venam123/Open_STMPLC/Document/ATM90E3x_V1.05/Hardware/ATM90E3x-DB V1.0/readme.txt

The project is designed with Altium Designer (Platform 27009).
