venam123/Open_STMPLC/Document/PCB_Design_Review_Report.docx

PCB Schematic Design Review Report

Universal PLC I/O Card + PLC Controller Card

Thingslista Automation LLp — Internal Design Review

Schematic Date: 19 Feb 2026 | Review Date: 20 Mar 2026

12 Critical Issues | 5 Warnings | 17 Total Issues

# Issue Summary

ID | Severity | Issue Title | Section
DI-01 | Critical | H11AA1 — Inverted Logic, NC pe LOW output aana | I/O Card — Digital Input
DO-01 | Critical | TVS Diode SMBJ33A Galat — 33V clamp > AO3400A 30V Vds max | I/O Card — Digital Output
DO-02 | Warning | 1N5819HW aur SMBJ33A Dono Parallel — Unnecessary Duplication | I/O Card — Digital Output
DO-03 | Critical | J20 Connector — Koi Signal Connected Nahi | I/O Card — Digital Output
SPI-01 | Critical | Energy Meter SPI — Chip Select CS Pin Allocate Hi Nahi Kiya | I/O Card — SPI / Energy Meter
SPI-02 | Critical | A_OUT_MOSI Net — Ambiguous Name, SPI Bus Conflict Risk | I/O Card — SPI / Energy Meter
AI-01 | Critical | INA828 — SGND Net Ambiguous, Ground Reference Unclear | I/O Card — Analog Input
AO-01 | Critical | J31/J32 — Voltage aur Current Output Same Connector — Wiring Hazard | I/O Card — Analog Output
AO-02 | Critical | R181-R187 — Component Values Missing in Schematic aur BOM | I/O Card — Analog Output
TEMP-01 | Critical | MAX6603ATB (I/O Card) + MAX31865 (Controller) — Duplicate RTD Architecture | I/O Card — Temperature / RTD
PWR-01 | Critical | TPS563200 U11 VFB Resistors R38/R39 Ulte — Output 1V aa raha, 3.3V nahi | Controller Card — Power Supply
PWR-02 | Critical | EC200U VBAT_RF — Bulk Cap Insufficient, GSM Burst mein Reboot | Controller Card — Power Supply
PWR-03 | Warning | Ferrite Bead FB1 BLM21AG121SN1D — 200mA only, VCC to AVDD33 Insufficient | Controller Card — Power Supply
MCU-01 | Critical | STM32F407 BOOT0 Pin 94 — Pull-Down Resistor Missing | Controller Card — MCU
MCU-02 | Warning | USB Connector J7 — VBUS Overvoltage Protection Missing | Controller Card — MCU
GEN-01 | Warning | Title Block — Sheet Numbers aur Revision Missing | General
GEN-02 | Warning | +5V / -5V Rail — I/O Card par Source Clearly Documented Nahi | General

# I/O Card — Digital Input

## DI-01 — H11AA1 — Inverted Logic, NC pe LOW output aana

Field | Details
Critical | Logic Error
Schematic Reference | Sheet 1-3, U6-U23 H11AA1-X007T, R20-R22, DIGITAL_INPUT1-18
Problem Description | • H11AA1 collector output topology se ACTIVE LOW deta hai — inherently inverting. • Input HIGH pe transistor ON, output LOW. NC/open pe transistor OFF, output HIGH (pull-up se). • Bug: NC pe LOW observe ho raha hai — MCU GPIO ka internal pull-down active ho sakta hai. • Expected: NC=HIGH, HIGH input=HIGH, LOW input=LOW. Actual sab ulta hai.
Recommended Fix | ✓ FIX A (Immediate, no hardware): MCU GPIO_PuPd_UP enable karo. actual = !GPIO_ReadInput(pin). Zero hardware change. ✓ FIX B (Next revision): 74HC14 schmitt trigger inverter add karo — proper hysteresis aur non-inverting output.

# I/O Card — Digital Output

## DO-01 — TVS Diode SMBJ33A Galat — 33V clamp > AO3400A 30V Vds max

Field | Details
Critical | Wrong Protection Component
Schematic Reference | Sheet 4-5, D11-D20 D23-D32 SMBJ33A, Q1-Q12 AO3400A
Problem Description | • AO3400A MOSFET max Vds = 30V. SMBJ33A clamp = 33V — 3V upar MOSFET rating se. • Inductive switching mein MOSFET 33V se pehle damage ho sakta hai. • 24V system ke liye TVS clamp ~26-28V hona chahiye (supply ka 120%).
Recommended Fix | ✓ SMBJ33A ko SMBJ26A ya SMBJ28A se replace karo. ✓ Alternative: AO3400A ki jagah 40V+ rated MOSFET use karo.

## DO-02 — 1N5819HW aur SMBJ33A Dono Parallel — Unnecessary Duplication

Field | Details
Warning | Redundant Components
Schematic Reference | Sheet 4-5, D9/D11 D10/D12 pairs har channel mein
Problem Description | • Har output channel mein Schottky flyback diode aur TVS dono hain. • Inductive load ke liye ek protection sufficient hai.
Recommended Fix | ✓ Ya sirf corrected TVS (SMBJ26A) rakho, ya sirf 1N5819HW. Dono ki zarurat nahi.

## DO-03 — J20 Connector — Koi Signal Connected Nahi

Field | Details
Critical | Floating Connector
Schematic Reference | Sheet 4, J20 1729128 2-pin, sirf +24VDC aur GND
Problem Description | • J20 par sirf power lines hain, koi DIGITAL_OUTPUT signal nahi. • Purpose unclear — power input ya output connector?
Recommended Fix | ✓ Power connector hai to clearly label karo "+24VDC Power Input". ✓ Output connector tha to missing signal connect karo ya connector hatao.

# I/O Card — SPI / Energy Meter

## SPI-01 — Energy Meter SPI — Chip Select CS Pin Allocate Hi Nahi Kiya

Field | Details
Critical | SPI Bus — Missing CS Pin
Schematic Reference | Controller Card Sheet 5, STM32F407VGT6, SPI GPIO allocation
Problem Description | • Energy meter ke liye dedicated CS pin MCU mein assign nahi kiya gaya. • Existing CS pins: E_CS, F_CS, TEMP0_CS, TEMP1_CS, A_IOUT_CS, A_VOUT_CS, CS_SD — sab occupied. • Bina CS ke energy meter SPI pe kabhi respond nahi karega.
Recommended Fix | ✓ STM32F407 available GPIO (PC/PD/PE) mein se ek pin EMETER_CS assign karo. ✓ Schematic mein net add karo aur MCU se energy meter CS pin tak connect karo. ✓ Agar GPIO nahi: 74HC138 decoder se 3 GPIO mein 8 CS lines generate karo.

## SPI-02 — A_OUT_MOSI Net — Ambiguous Name, SPI Bus Conflict Risk

Field | Details
Critical | SPI Net Naming Error
Schematic Reference | Sheet 7 U41 MCP4922 current DAC, Sheet 8 U44 MCP4922 voltage DAC
Problem Description | • A_VOUT_MOSI aur A_IOUT_MOSI dono ek hi A_OUT_MOSI net share karte hain. • Agar firmware dono CS ek saath assert kare to SPI bus fight aur dono DAC galat data receive karenge.
Recommended Fix | ✓ Nets clearly alag karo: A_IOUT_MOSI aur A_VOUT_MOSI. ✓ Firmware mein ek CS high kiye bina doosra CS low nahi karna.

# I/O Card — Analog Input

## AI-01 — INA828 — SGND Net Ambiguous, Ground Reference Unclear

Field | Details
Critical | Analog Ground Reference Error
Schematic Reference | Sheet 6, U36-U39 INA828ID, Pin 5 REF, SGND net
Problem Description | • INA828 REF pin VREF net se connected lekin SGND source schematic mein visible nahi. • SGND aur GND properly tied nahi hain to differential measurements mein systematic offset aayega.
Recommended Fix | ✓ SGND ko AGND se single point par explicitly connect karo. ✓ Agar offset nahi chahiye to REF pin seedha GND se connect karo.

# I/O Card — Analog Output

## AO-01 — J31/J32 — Voltage aur Current Output Same Connector — Wiring Hazard

Field | Details
Critical | Connector Design Error
Schematic Reference | Sheet 8, J31 J32 1727023 3-pin, Analog_Voutput + Analog_Ioutput same
Problem Description | • 0-10V voltage output aur 4-20mA current output ek hi Phoenix 3-pin connector par. • Field wiring mein dono mix ho sakte hain — connected equipment damage.
Recommended Fix | ✓ Voltage aur current output ke liye alag dedicated connectors use karo. ✓ Labels clearly likho: AO-V1 (0-10V) aur AO-I1 (4-20mA).

## AO-02 — R181-R187 — Component Values Missing in Schematic aur BOM

Field | Details
Critical | Incomplete Schematic
Schematic Reference | Sheet 8, R181 R182 R183 R184 R185 R186 R187, BOM Sheet 11
Problem Description | • R181-R187 mein koi resistance value ya part number nahi — ye DAC output voltage divider resistors hain. • Values se output voltage range set hoti hai — manufacturing ke liye incomplete.
Recommended Fix | ✓ Required output range (0-10V) ke liye OPA2197 gain stage se R values calculate karo. ✓ BOM mein in components ki values aur part numbers add karo.

# I/O Card — Temperature / RTD

## TEMP-01 — MAX6603ATB (I/O Card) + MAX31865 (Controller) — Duplicate RTD Architecture

Field | Details
Critical | Conflicting Architecture
Schematic Reference | I/O Card Sheet 9 U47 MAX6603ATB, Controller Sheet 9 U12 U13 MAX31865
Problem Description | • I/O card par MAX6603ATB (analog voltage RTD output). Controller card par MAX31865 SPI IC bhi. • Ek design mein dono approaches — redundant, confusing, extra cost. • MAX31865 direct SPI se accurate digital reading deta hai — better option.
Recommended Fix | ✓ MAX31865 use karo. I/O card par U47 MAX6603ATB ko DNP mark karo aur remove karo.

# Controller Card — Power Supply

## PWR-01 — TPS563200 U11 VFB Resistors R38/R39 Ulte — Output 1V aa raha, 3.3V nahi

Field | Details
Critical | Wrong Output Voltage — Critical Bug
Schematic Reference | Power Sheet 7, U11 TPS563200DDCR, R38 10k top R39 33.2k bot, VCC AVDD33
Problem Description | • TPS563200 reference = 0.768V. Vout = 0.768 x (1 + R_top/R_bot). • Current: R38=10k top, R39=33.2k bot -> Vout = 0.768 x 1.301 = 1.0V. GALAT. • Sahi: R_top=33.2k, R_bot=10k -> 0.768 x 4.32 = 3.317V. Resistors ulte hain. • STM32F407 aur sabhi 3.3V peripherals under-voltage mein — system properly kaam nahi karega.
Recommended Fix | ✓ Immediate rework: R38 position mein 33.2k lagao (top). R39 mein 10k (bottom). Swap karo. ✓ Fix ke baad VCC multimeter se measure karo — 3.3V plus/minus 2% aana chahiye. ✓ Next revision: schematic annotate karo R_top=33.2k R_bot=10k Vout=3.317V.

## PWR-02 — EC200U VBAT_RF — Bulk Cap Insufficient, GSM Burst mein Reboot

Field | Details
Critical | GSM Module Power Instability
Schematic Reference | Sheet 2 U1 EC200U pins 57-60, Power Sheet 7 C52 C53 100uF, MIC29302, F2
Problem Description | • EC200U GSM burst mein 2A peak current draw karta hai. • C52/C53 100uF EC200U se physically door — trace inductance VBAT drop badhata hai. • VBAT_RF 200-300mV dip kar sakta hai. EC200U minimum 3.4V chahiye — 800mV+ drop se reset. • MIC29302 LDO slow transient response se burst current handle nahi hota.
Recommended Fix | ✓ Immediate: EC200U VBAT_RF pins ke bilkul paas 470uF low-ESR cap add karo rework mein. ✓ Oscilloscope se verify: VBAT_RF GSM call mein 3.4V se neeche nahi aana chahiye. ✓ Next revision: VBAT_RF trace 1.5mm min. MIC29302 -> Ferrite bead -> 470uF -> VBAT_RF. ✓ F2 fuse 3A use karo — GSM burst ke liye 1.5A fuse blow ho sakta hai.

## PWR-03 — Ferrite Bead FB1 BLM21AG121SN1D — 200mA only, VCC to AVDD33 Insufficient

Field | Details
Warning | Analog Supply Filtering
Schematic Reference | Power Sheet 7, FB1 BLM21AG121SN1D, VCC to AVDD33, STM32 VDDA VSSA
Problem Description | • BLM21AG121SN1D max DC current = 200mA — saturation pe AVDD33 drop karega. • STM32 ADC measurements inaccurate honge AVDD33 drop se.
Recommended Fix | ✓ FB1 ko BLM21PG600SN1D 600mA se replace karo. ✓ Better: AVDD33 ke liye dedicated LDO LP2985 150mA 3.3V use karo — better analog isolation.

# Controller Card — MCU

## MCU-01 — STM32F407 BOOT0 Pin 94 — Pull-Down Resistor Missing

Field | Details
Critical | MCU Boot Configuration
Schematic Reference | Sheet 5, U2A STM32F407VGT6, Pin 94 BOOT0
Problem Description | • BOOT0 float kare to MCU bootloader mode mein start hoga — user firmware run nahi hoga. • Schematic mein BOOT0 pull-down visible nahi.
Recommended Fix | ✓ BOOT0 pin 94 se GND ke beech 10k resistor add karo. ✓ ISP ke liye test pad ya switch ke through control karo.

## MCU-02 — USB Connector J7 — VBUS Overvoltage Protection Missing

Field | Details
Warning | USB Protection
Schematic Reference | Sheet 5, J7 104110-0001LF micro USB, VBUS pin 1
Problem Description | • J7 VBUS seedha +5V se connected hai bina protection ke.
Recommended Fix | ✓ VBUS par Schottky diode ya USBLC6-2SC6 dedicated USB protection IC add karo.

# General

## GEN-01 — Title Block — Sheet Numbers aur Revision Missing

Field | Details
Warning | Documentation
Schematic Reference | All sheets — bottom right title block
Problem Description | • Multiple sheets par Sheet of blank, revision number missing.
Recommended Fix | ✓ Har sheet number fill karo e.g. Sheet 1 of 9. Revision Rev A add karo.

## GEN-02 — +5V / -5V Rail — I/O Card par Source Clearly Documented Nahi

Field | Details
Warning | Power Distribution Documentation
Schematic Reference | I/O Card Sheet 9, P5 Header 10X2 pins 11-12
Problem Description | • INA828, OPA2197, MCP4922 ko +5V aur -5V chahiye lekin I/O card par source unclear.
Recommended Fix | ✓ P5 connector assignment mein +5V/-5V source document karo. Power budget table add karo.

Confidential — Internal Design Review Thingslista Automation LLp

PCB Design Review — Thingslista Automation LLp March 2026
