venam123/Open_STMPLC/Document/ATM90E3x_V1.05/Hardware/ATSAM4C-CB V1.0/ATSAM4C-CB.PcbDoc.htm

Reporting Options

# File in Newer Format

Date | : | 10-06-2026
Time | : | 22:07:52
Filename | : | D:\Github\Open_STMPLC\Document\ATM90E3x_V1.05\Hardware\ATSAM4C-CB V1.0\ATSAM4C-CB.PcbDoc

Version | Warning
Release 13 | CAUTION - Silkscreen Over Component Pads Rules are converted to Silk To Solder Mask Clearance Rules. Suggest examining rule scopes for accuracy.

This file was generated by an earlier version of the software
