venam123/Open_STMPLC/Document/SMPS Design/Quatation/SMPS Price.xlsx

Sr No | Per PCB | Pcs
1 | 260 | 1200
Note
1 | Transfomer Control & Design
2 | Industry Design Components
3 | Total Indian Component not depend on China
4 | Shippng Charge Extra
