venam123/Open_STMPLC/Document/DXF Files/image (1).png

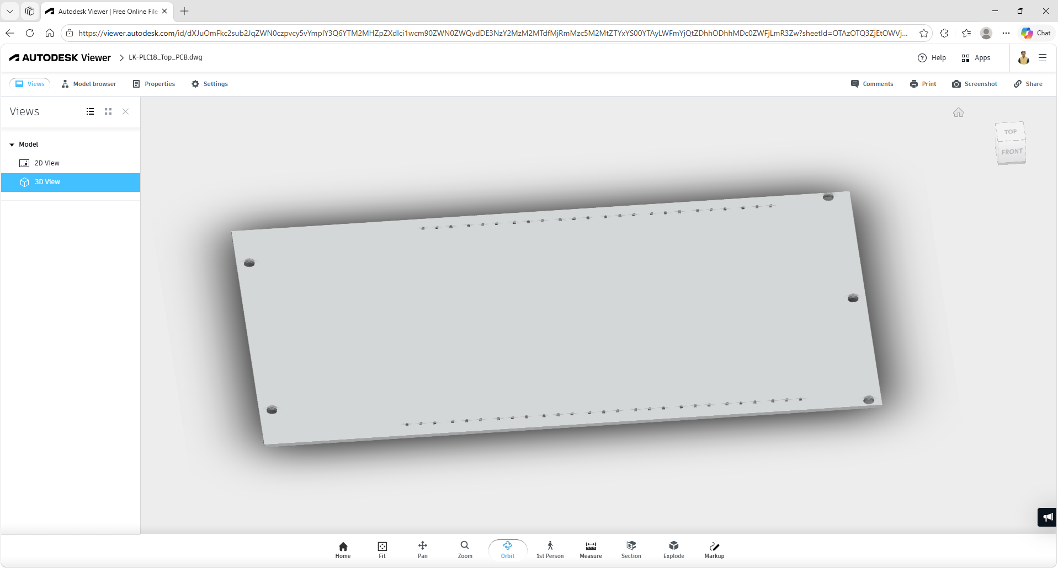
Document/DXF Files/image (1).png
