venam123/Open_STMPLC/Document/DXF Files/image (2).png

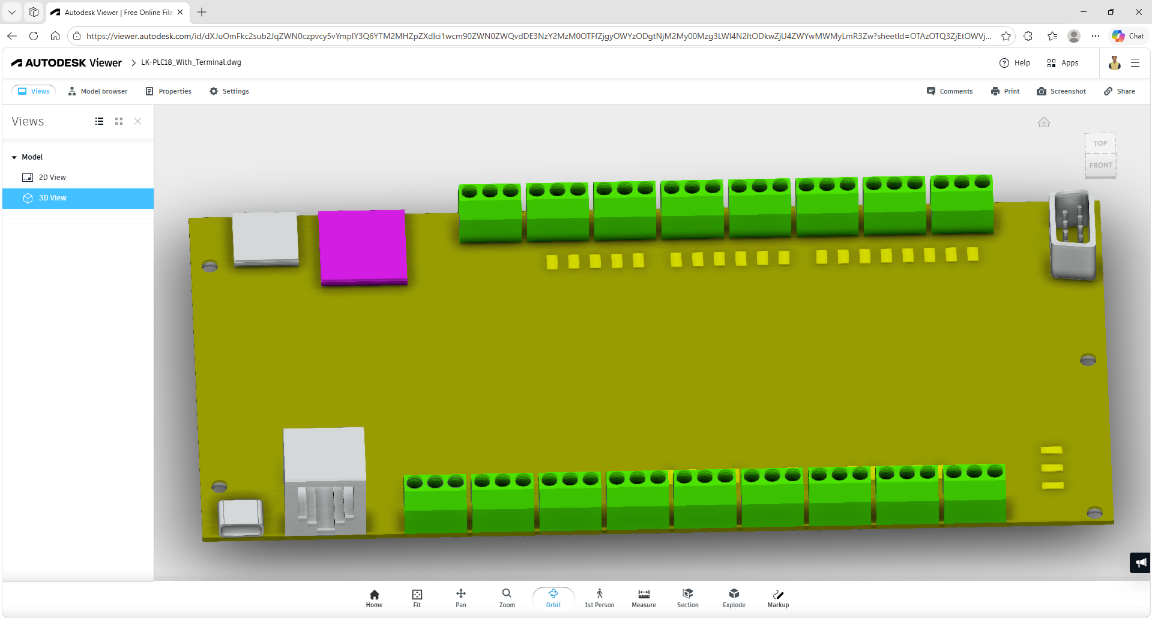
Document/DXF Files/image (2).png
