venam123/Open_STMPLC/Document/DXF Files/image.png

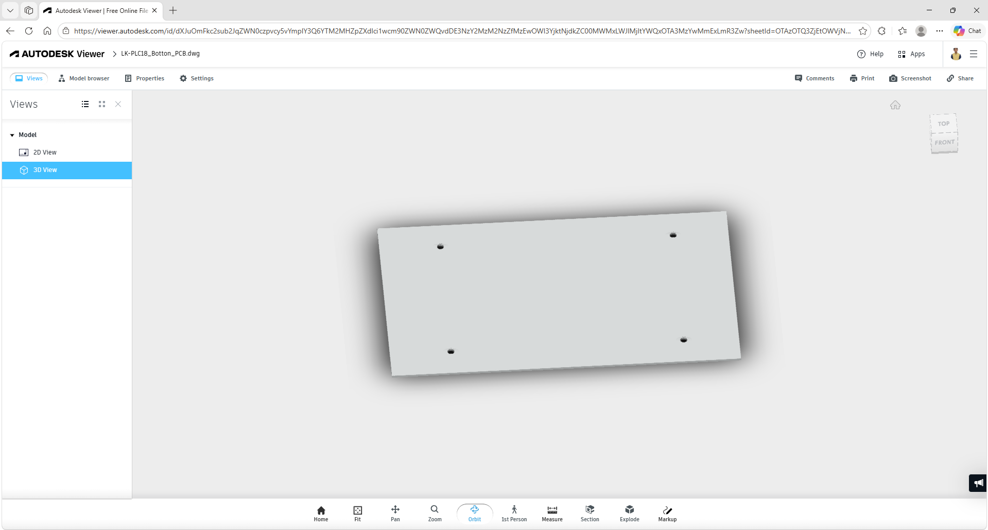
Document/DXF Files/image.png
