venam123/Open_STMPLC/Document/Watch-Dog Ref Image/Watch_Dog_Ref_Image.PNG

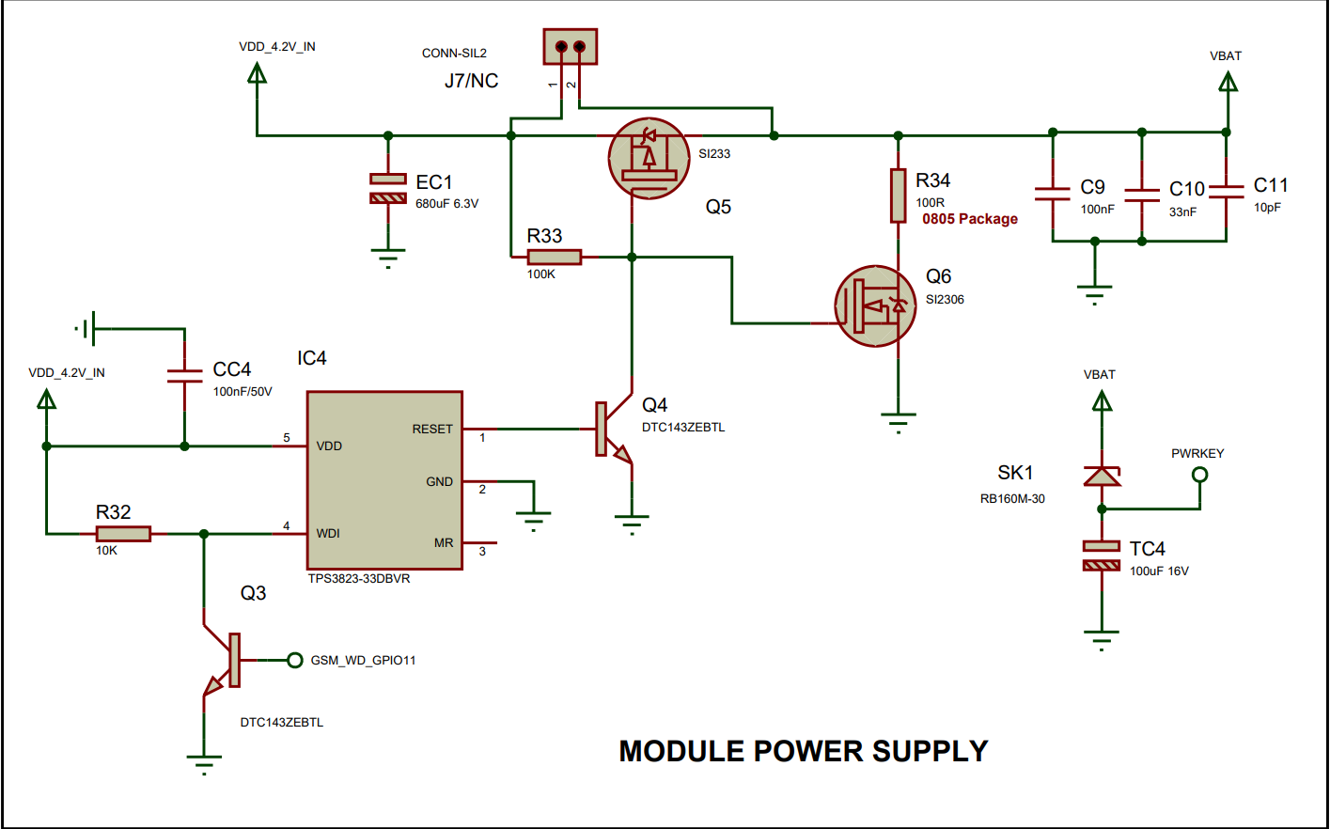
Document/Watch-Dog Ref Image/Watch_Dog_Ref_Image.PNG
