venam123/Open_STMPLC/Hardware/Running_Hardware/Open_STMPLC_IO_V0.1/bom/IO_PCB.xlsx

Sr No | References | Value | Footprint | kicad_dnp | Quantity | JLC PCB Part_Number
1 | C1, C3, C4, C5, C7, C12, C13, C15, C26, C30, C34, C35, C36, C37, C38, C39, C40, C41, C42, C43, C44, C45, C48, C54, C57, C59, C63, C66, C67, C68, C81, C86, C87, C88, C90 | 100nF | C_0603_1608Metric_Pad1.08x0.95mm_HandSolder |  | 35 | C5137636
2 | C8, C23, C27, C31, C47, C50, C51, C52, C58, C64, C65, C82 | 1uF | C_0603_1608Metric_Pad1.08x0.95mm_HandSolder |  | 12 | C559769
3 | C10, C16, C17, C18, C19, C20, C21, C22 | 620nF | C_0603_1608Metric_Pad1.08x0.95mm_HandSolder |  | 8 | C7496642
4 | C2, C25, C29, C33, C46 | 10uF | C_0805_2012Metric_Pad1.18x1.45mm_HandSolder |  | 5 | C440198
5 | C6, C11, C55, C62 | 10nF | C_0603_1608Metric_Pad1.08x0.95mm_HandSolder |  | 4 | C5137477
6 | C9, C24, C28, C32 | 2.2uF | C_0603_1608Metric_Pad1.08x0.95mm_HandSolder |  | 4 | C913904
7 | C69, C74, C79, C80 | 4.7nF | C_0603_1608Metric_Pad1.08x0.95mm_HandSolder |  | 4 | C106218
8 | C70, C73, C77, C78 | 680pF | C_0603_1608Metric_Pad1.08x0.95mm_HandSolder |  | 4 | C107055
9 | C71, C72, C75, C76 | 470pF | C_0603_1608Metric_Pad1.08x0.95mm_HandSolder |  | 4 | C107092
10 | C14, C85 | 10nF | C_0603_1608Metric_Pad1.08x0.95mm_HandSolder | DNP | 2 | C5137477
11 | C53, C60 | 47nF | C_0603_1608Metric_Pad1.08x0.95mm_HandSolder |  | 2 | C107093
12 | C56, C61 | 100nF | C_0603_1608Metric_Pad1.08x0.95mm_HandSolder | DNP | 2 | C5137636
13 | C83, C84 | 10pF | C_0603_1608Metric_Pad1.08x0.95mm_HandSolder |  | 2 | C106245
14 | C89 | 220uF/50V | CP_Elec_10x10.5 |  | 1 | C88818
15 | R1, R2, R17, R19, R20, R33, R35, R36, R40, R42, R43, R47, R49, R50, R54, R56, R57, R61, R63, R64, R68, R70, R71, R75, R77, R78, R89, R90, R100, R101, R111, R112, R207, R208, R215, R216, R217, R218, R219, R220, R221, R222, R223, R224, R225, R226 | 4.7K | R_0603_1608Metric_Pad0.98x0.95mm_HandSolder |  | 46 | C105428
16 | R4, R10, R37, R44, R51, R58, R65, R72, R79, R84, R95, R106, R114, R115, R120, R121, R126, R127, R132, R133, R138, R139, R144, R145, R168, R172, R176, R177, R180, R181, R193, R197, R202, R203, R227, R228, R229, R230, R231, R232, R233, R234, R235, R236, R237, R238 | 1K | R_0603_1608Metric_Pad0.98x0.95mm_HandSolder |  | 46 | C14676
17 | R3, R14, R16, R34, R41, R48, R55, R62, R69, R76, R83, R88, R94, R99, R105, R110, R159, R160, R164, R165, R166, R167, R183, R187, R188, R189 | 10K | R_0603_1608Metric_Pad0.98x0.95mm_HandSolder |  | 26 | C99198
18 | R22, R25, R116, R117, R122, R123, R128, R129, R134, R135, R140, R141, R146, R147, R148, R149, R150, R151, R152, R153, R154, R155, R156, R157 | 10R/1W | R_2512_6332Metric_Pad1.40x3.35mm_HandSolder |  | 24 | C16861
19 | R21, R23, R24, R27, R113, R118, R119, R124, R125, R130, R131, R136, R137, R142, R143, R169, R170, R185, R186, R206 | 2.2K | R_0603_1608Metric_Pad0.98x0.95mm_HandSolder |  | 20 | C113303
20 | R11, R87, R98, R109, R163, R239, R240, R241, R242, R243 | 470R | R_0603_1608Metric_Pad0.98x0.95mm_HandSolder |  | 10 | C23179
21 | R15, R38, R45, R52, R59, R66, R73, R80 | 100K | R_0603_1608Metric_Pad0.98x0.95mm_HandSolder | DNP | 8 | C14675
22 | R18, R39, R46, R53, R60, R67, R74, R81 | 15K | R_0603_1608Metric_Pad0.98x0.95mm_HandSolder |  | 8 | C114661
23 | R192, R194, R195, R196, R198, R199, R200, R201 | 180R | R_0603_1608Metric_Pad0.98x0.95mm_HandSolder |  | 8 | C137786
24 | R29, R30, R31, R210, R211, R212 | 0R | R_0603_1608Metric_Pad0.98x0.95mm_HandSolder | DNP | 6 | C95177
25 | R32, R171, R182, R190, R191, R209 | 0R | R_0603_1608Metric_Pad0.98x0.95mm_HandSolder |  | 6 | C95177
26 | R158, R161, R162, R204, R205, R245 | 100K | R_0603_1608Metric_Pad0.98x0.95mm_HandSolder |  | 6 | C14675
27 | R5, R12, R91, R102 | 715K | R_0603_1608Metric_Pad0.98x0.95mm_HandSolder |  | 4 | C19267401
28 | R6, R13, R92, R103 | 20K | R_0603_1608Metric_Pad0.98x0.95mm_HandSolder |  | 4 | C2907011
29 | R7, R82, R93, R104 | 30.1K | R_0603_1608Metric_Pad0.98x0.95mm_HandSolder |  | 4 | C137745
30 | R8, R85, R96, R107 | 11.8K | R_0603_1608Metric_Pad0.98x0.95mm_HandSolder |  | 4 | C185375
31 | R9, R86, R97, R108 | 33.2K | R_0603_1608Metric_Pad0.98x0.95mm_HandSolder |  | 4 | C2933200
32 | R26, R213 | 400R | R_0603_1608Metric_Pad0.98x0.95mm_HandSolder |  | 2 | C5841024
33 | R28, R214 | 4K | R_0603_1608Metric_Pad0.98x0.95mm_HandSolder | DNP | 2 | C242164
34 | R173, R184 | 15R | R_0603_1608Metric_Pad0.98x0.95mm_HandSolder |  | 2 | C128059
35 | R174, R179 | 1.65K | R_0603_1608Metric_Pad0.98x0.95mm_HandSolder |  | 2 | C2930051
36 | R175, R178 | 1.65K | R_0603_1608Metric_Pad0.98x0.95mm_HandSolder | DNP | 2 | C2930051
37 | D1, D2, D6, D7, D12, D13, D15, D16, D17, D19, D20, D21, D23, D24, D25, D27, D28, D29, D31, D32, D33, D34, D36, D37, D39, D41, D42, D44, D46, D47, D49, D50, D51, D53, D54, D55, D108, D109, D110, D111, D113, D115, D116, D117 | SS510 | D_SMA |  | 44 | C65010
38 | D100, D101, D102, D103, D104, D105, D126, D127, D128, D129, D130, D131, D132, D133, D134, D135, D136, D137, D138, D139, D140, D141, D142, D143, D144, D145, D146, D147, D148, D149, | LED(G) | LED_0603_1608Metric_Pad1.05x0.95mm_HandSolder |  | 30 | C965799
39 | D150, D151, D152 | LED® | LED_0603_1608Metric_Pad1.05x0.95mm_HandSolder |  | 3 | C125094
40 | D3, D5, D8, D9, D10, D14, D18, D22, D26, D30, D38, D43, D48, D52, D56, D60, D61, D66, D67, D72, D73, D78, D79, D84, D85, D112, D114, D118, D121, D124, D125, D160 | SMAJ33CA | D_SMA |  | 32 | C908829
41 | D11, D57, D62, D63, D68, D69, D74, D75, D80, D81, D86, D87 | MB110S | TO-269AA |  | 12 | C94545
42 | D58, D59, D64, D65, D70, D71, D76, D77, D82, D83, D88, D89 | NSI50010YT1G | D_SOD-123 |  | 12 | C150049
43 | D92, D93, D94, D95, D96, D97, D98, D99 | SMF5V0A | D_SMF |  | 8 | C1972946
44 | D4, D35, D40, D45 | BZT52C12 | D_SOD-123 |  | 4 | C173429
45 | D119, D120, D122, D123 | SMAJ10CA | D_SMA |  | 4 | C908816
46 | D90, D159 | BZV55C10 | D_MiniMELF |  | 2 | C2892588
47 | D91 | MMSZ5256ET1G | D_MiniMELF |  | 1
48 | U12, U20, U21, U22, U23, U24, U25, U26, U27, U28, U29, U30 | 6N137 | SMDIP-8_W9.53mm_Clearance8mm |  | 12 | C110020
49 | U1, U2, U3, U4, U5, U6, U9, U13 | TPS1H200A | HVSSOP-8-1EP_3x3mm_P0.65mm_EP1.57x1.89mm_ThermalVias |  | 8 | C2653785
50 | U7, U14, U16, U18 | TPS26600PWP | HTSSOP-16-1EP_4.4x5mm_P0.65mm_EP3.4x5mm_Mask2.66x2.46mm_ThermalVias |  | 4 | C544399
51 | U8, U15, U17, U19 | NVTFS5124PLTAG | WDFN-8_3.3X3.3_P0.65mm |  | 4 | C606162
52 | U10, U41 | MAX31865xTP | TQFN-20-1EP_5x5mm_P0.65mm_EP3.25x3.25mm |  | 2 | C779509
53 | U37, U38 | XTR305 | Texas_RGW0020A_VQFN-20-1EP_5x5mm_P0.65mm_EP3.15x3.15mm |  | 2 | C266132
54 | U11 | MAX31856 | TSSOP-14_4.4x5mm_P0.65mm |  | 1 | C2653162
55 | U39 | AD4111 | LFCSP-40-1EP_6x6mm_P0.5mm_EP4.6x4.6mm |  | 1 | C649166
56 | U40 | REF3025 | SOT-23 |  | 1 | C11334
57 | Y2 | 16MHz | Crystal_SMD_5032-4Pin_5.0x3.2mm |  | 1 | C18214305
58 | F1, F2, F3, F4 | MF-USMF005-2 | Fuse_1210_3225Metric |  | 4 | C118758
59 | F5 | 0685T5000-01 | Fuse_1206_3216Metric |  | 1 | C3163312
60 | Q1, Q2, Q3, Q4 | 2N7002K | SOT-23 |  | 4 | C414015
61 | FB1, FB2, FB3 | 120R@100MHz | L_0805_2012Metric_Pad1.05x1.20mm_HandSolder |  | 3 | C79382
62 | Q5, Q6 | AOD407 | TO-252-3_TabPin2 |  | 2 | C6396162
63 | FB4 | BLM31SN500SH1L | L_1206_3216Metric_Pad1.22x1.90mm_HandSolder |  | 1 | C527600
64 | Q7 | MMBT5401 | SOT-23 |  | 1 | C21488
65 | J3, J5, J6, J7, J8, J40 | Screw_Terminal_01x04 | TerminalBlock_Phoenix_MKDS-1-4-3.81_1x04_P3.81mm_Horizontal |  | 6 | C395880
66 | J4, J33, J34, J43 | Screw_Terminal_01x02 | TerminalBlock_Phoenix_MKDS-1-2-3.81_1x02_P3.81mm_Horizontal |  | 4 | C395878
67 | J35, J36, J37, J38 | Screw_Terminal_01x03 | TerminalBlock_Phoenix_MKDS-1-3-3.81_1x03_P3.81mm_Horizontal |  | 4 | C395879
68 | J39, J41, J42 | 10144517-041802LF | AMPHENOL_10144517-041802LF |  | 3 | C3645392
69 | J1 | Screw_Terminal_01x10 | TerminalBlock_Phoenix_MKDS-1-10-3.81_1x10_P3.81mm_Horizontal |  | 1 | C5137189
70 | J2 | Screw_Terminal_01x06 | TerminalBlock_Phoenix_MKDS-1-6-3.81_1x06_P3.81mm_Horizontal |  | 1 | C5143696
71 | J9 | DE9_Pins | A-DF_09_PP_Z |  | 1 | C183530
