venam123/Open_STMPLC/Hardware/Running_Hardware/Open_STMPLC_Main_V0.1/bom/Main_PCB_BOM.xlsx

null | Sourced | Placed | References | Value | Footprint | kicad_dnp | Quantity | JLC Part number
1 |  |  | C1, C5, C6, C8, C9, C10, C11, C12, C13, C14, C16, C17, C18, C21, C22, C23, C24, C26, C30, C31, C33, C34, C38, C39, C40, C41, C44, C45, C51, C53, C54, C59, C60, C63, C65, C70, C80 | 100nF | C_0603_1608Metric_Pad1.08x0.95mm_HandSolder |  | 37 | C5137636
2 |  |  | C2, C3, C19, C20, C42, C57, C58 | 10pF | C_0603_1608Metric_Pad1.08x0.95mm_HandSolder |  | 7 | C106245
3 |  |  | C4, C25, C27, C32, C35, C66, C71, C72, C79 | 10uF | C_0805_2012Metric_Pad1.18x1.45mm_HandSolder |  | 9 | C440198
4 |  |  | C43, C49, C50, C52 | 33pF | C_0603_1608Metric_Pad1.08x0.95mm_HandSolder |  | 4 | C107047
5 |  |  | C36, C46, C64 | 1uF | C_0603_1608Metric_Pad1.08x0.95mm_HandSolder |  | 3 | C15849
6 |  |  | C7, C15 | 10nF | C_0603_1608Metric_Pad1.08x0.95mm_HandSolder |  | 2 | C5137477
7 |  |  | C28, C29 | 1nF | C_0603_1608Metric_Pad1.08x0.95mm_HandSolder | DNP | 2 | C100040
8 |  |  | C47, C48 | 100uF | CP_EIA-3528-15_AVX-H |  | 2 | C2887903
9 |  |  | C55, C56, C67, C68 | 22uF | C_0805_2012Metric_Pad1.18x1.45mm_HandSolder |  | 4 | C338080
10 |  |  | C61, C62 | 2.2uF | C_0603_1608Metric_Pad1.08x0.95mm_HandSolder |  | 2 | C913904
13 |  |  | C69 | 100pF | C_0603_1608Metric_Pad1.08x0.95mm_HandSolder |  | 1 | C14858
14 |  |  | C73 | 1nF/2kV | C_1206_3216Metric_Pad1.33x1.80mm_HandSolder |  | 1 | C23631
11 |  |  | C37 | 470pF | C_0603_1608Metric_Pad1.08x0.95mm_HandSolder |  | 1 | C107092
12 |  |  | R1, R2, R8, R18, R19, R20, R31, R35, R36, R67, R68, R69, R70, R71, R72, R73 | 10K | R_0603_1608Metric_Pad0.98x0.95mm_HandSolder |  | 16 | C99198
13 |  |  | R3, R4, R5, R9, R22 | 0R | R_0603_1608Metric_Pad0.98x0.95mm_HandSolder |  | 5 | C95177
14 |  |  | R23, R24, R25, R26 | 49.9R | R_0603_1608Metric_Pad0.98x0.95mm_HandSolder |  | 4 | C114625
15 |  |  | R6, R7 | 10K | R_0603_1608Metric_Pad0.98x0.95mm_HandSolder | DNP | 2 | C99198
16 |  |  | R10, R11 | 5.1K | R_0603_1608Metric_Pad0.98x0.95mm_HandSolder |  | 2 | C105580
17 |  |  | R12, R13 | 10R | R_0603_1608Metric_Pad0.98x0.95mm_HandSolder |  | 2 | C109318
18 |  |  | R27, R28 | 270R | R_0603_1608Metric_Pad0.98x0.95mm_HandSolder |  | 2 | C2907020
19 |  |  | R21 | 12.1K | R_0603_1608Metric_Pad0.98x0.95mm_HandSolder |  | 1 | C22864
26 |  |  | R30 | 1M | R_1206_3216Metric_Pad1.30x1.75mm_HandSolder |  | 1 | C2907441
20 |  |  | R29 | 4.7K | R_0603_1608Metric_Pad0.98x0.95mm_HandSolder |  | 1 | C99782
21 |  |  | R34 | 51K | R_0603_1608Metric_Pad0.98x0.95mm_HandSolder |  | 1 | C107231
22 |  |  | L2 | 3.3uH | L_Abracon_ASPI-0630LR |  | 1 | C167219
31 |  |  | D92 | SMF5V0A | D_SMF |  | 1 | C1972946
24 |  |  | D1 | BAT54J | D_SOD-323F |  | 1 | C86299
29 |  |  | D2, D3, D4, D5, D6, D7, D8, D9, D10, D11, D12, D13, D14, D15, D16, D17, D18, D19, D20, D21, D22, D23, D24, D25, D26, D27, D28, D29, D30, D31 | UAD8C05L01 | D_SOD-882 |  | 30 | C523533
25 |  |  | D6 | DT1240A-08LP3810 | UDFN-9_1.0x3.8mm_P0.5mm |  | 1 | C526598
26 |  |  | U1 | STM32F407IGTx | LQFP-176_24x24mm_P0.5mm |  | 1 | C33993
27 |  |  | U2 | ADM2587E | SOIC-20W_7.5x12.8mm_P1.27mm |  | 1 | C12081
28 |  |  | U3 | TPS3430WDRC | VSON-10-1EP_3x3mm_P0.5mm_EP1.65x2.4mm |  | 1 | C2870545
29 |  |  | U4 | CH340C | SOIC-16_3.9x9.9mm_P1.27mm |  | 1 | C84681
30 |  |  | U5 | AMS1117-3.3 | SOT-223-3_TabPin2 |  | 1 | C917183
31 |  |  | U6 | W25Q64JVSSIQ | SOIC-8_5.3x5.3mm_P1.27mm |  | 1 | C179171
32 |  |  | U7 | LAN8720A | VQFN-24-1EP_4x4mm_P0.5mm_EP2.5x2.5mm_ThermalVias |  | 1 | C511283
32 |  |  | U11, U12 | SRV05-4 | SOT-23-6 |  | 2 | C20615829
33 |  |  | U8 | EC200U | EC200UCNAA-N05-SGNSA |  | 1
41 |  |  | U9 | AP63200WU | TSOT-23-6 |  | 1 | C2071868
42 |  |  | U10 | AP63205WU | TSOT-23-6 |  | 1 | C2071056
34 |  |  | Y1 | 48MHz | Crystal_SMD_5032-4Pin_5.0x3.2mm |  | 1 | C112580
35 |  |  | Y2 | 32.768kHz | Crystal_SMD_3215-2Pin_3.2x1.5mm |  | 1 | C42438016
36 |  |  | Y3 | 25MHz | Crystal_SMD_5032-4Pin_5.0x3.2mm |  | 1 | C7471625
37 |  |  | SW1 | Switch | SW_PUSH_6mm_H5mm |  | 1 | C393938
38 |  |  | SW2 | SW_SPDT | SW_Slide_SPDT_Straight_CK_OS102011MS2Q |  | 1
39 |  |  | SW3 | Switch_6x6 | SW_Push_1P1T_NO_E-Switch_TL3301NxxxxxG |  | 1
40 |  |  | Q1, Q2, Q3, Q4, Q5, Q6, Q7 | DTC143Z | SOT-23-3 |  | 7 | C15236
41 |  |  | BT1 | Battery_Cell | BatteryHolder_MYOUNG_BS-07-A1BJ001_CR2032 |  | 1 | C5239862
42 |  |  | ` | 10144518-041802LF | AMPHENOL_10144518-041802LF |  | 3 | C5410298
43 |  |  | J5, J6 | Conn_Coaxial | U.FL_Hirose_U.FL-R-SMT-1_Vertical |  | 2 | C5137195
44 |  |  | J1 | Conn_02x08_Odd_Even | PinSocket_2x08_P2.54mm_Horizontal |  | 1 | C239359
45 |  |  | J2 | USB C | USB_C_Receptacle_GCT_USB4105-xx-A_16P_TopMnt_Horizontal |  | 1 | C2765186
46 |  |  | J4 | TF-01A | SD_Card |  | 1 | C91145
47 |  |  | J7 | Simcard_Nano | TE_2336582-1 |  | 1
48 |  |  | J11 | HY951180A | HY951180A |  | 1 | C34677
