venam123/Open_STMPLC/Document/ATM90E3x_V1.05/Hardware/ATM90E3x-DB V1.0/ATM90E3x-DB BOM.xlsx

Bill of Materials |  | Bill of Materials For Project [ATM90E3x-DB.PrjPcb]
Source Data From: | ATM90E3x-DB.PrjPcb
Project: | ATM90E3x-DB.PrjPcb
Variant: | None
Version | 1.1
Print Date: | 2020-04-16 | 14:52:36
Designator | Comment | Footprint | Designation | Manufacturer | Part Number | Quantity
C1 | 100pF | C_FILM_600 |  | Epcos | B32922C3104M | 1
C2 | 220uF | C_ALUM_MIX_10x10 |  | Lelon | VE-221M1VTR-1010 | 1
C3, C4 | 22uF | C_TANT_B3528 | Tantalum Capacitor, 25V |  |  | 2
C5, C12, C22, C30 | 10uF | C0805 | Ceramic Capacitor, 16V |  |  | 4
C6, C7, C8 | 0.1uF | C0805 | Ceramic Capacitor, 16V |  |  | 3
C9, C15, C16, C17, C23 | 0.1uF | C0603 | Ceramic Capacitor, 16V |  |  | 5
C10, C11, C13, C14, C18, C19, C20, C21, C24, C25, C26, C27, C28, C29 | 18nF | C0805 | Ceramic Capacitor, 16V |  |  | 14
D1, D2 | 1N4147 | SMA DO-214AC |  |  |  | 2
D3 | Yellow | LED-0805Y |  |  |  | 1
D4, D5, D6, D7 | Red | LED-0805R |  |  |  | 4
J-IA, J-IB, J-IC, J-IN |  | TE-1776119-2 |  | Tyco | 1776119-2 | 4
J-U |  | TE-282843-4 |  | Tyco | 282843-4 | 1
J2 | HDR2X10 | HDR2X10 | Socket,Right Angle,2x10Pin,2.54MM pitch |  |  | 1
J3, J5, J6, J7, J8 | HDR1X2 | HDR1X2 | 2.54mm Pitch Single Row Pin Header |  |  | 5
J4 | HDR1X8 | HDR1X8 | 2.54mm Pitch Single Row Pin Header |  |  | 1
JP2, JP3, JP4, JP5, JP6, JP7, JP8 | JMP | HDR1X2 | 2.54mm Pitch Single Row Pin Header |  |  | 7
PW1 | PowerJack | PowerJacket2.5 | Connector,DC Jack,Right Angle,3Pin,2.0M |  |  | 1
R1, R5, R12, R16, R17, R20, R21, R23, R32 | 510R | R0805 | Chip Resistor |  |  | 9
R2, R3, R10, R11, R14, R15, R18, R19 | 1K | R0805 | Chip Resistor |  |  | 8
R30, R31, R40, R41, R49, R50 | 1K | R0805 | Chip Resistor, 25ppm |  |  | 6
R4 | 10K | R0603 | Chip Resistor |  |  | 1
R13 | 0R | R0603 | Chip Resistor |  |  | 1
R22, R24, R25, R26, R27, R28, R29, R33, R34, R35, R36, R37, R38, R39, R42, R43, R44, R45, R46, R47, R48 | 240K | R1206 | Chip Resistor, 25ppm |  |  | 21
RC1, RC2, RC3, RC4, RC5, RC6, RC7, RC8 | 2R4 | R0805 | Chip Resistor, 25ppm |  |  | 8
RR1, RR2, RR3, RR4, RR5, RR6, RR7, RR8 | 0 | R0805 | Chip Resistor |  |  | 8
RV1 | RES-V | VDRS10P510BSE |  | Vishay | VDRS10P510BSE | 1
U1 | TMLM04109 | TMLM04112 |  | TRACO POWER | TMLM04109 | 1
U2 | 78L33 | SOT-89 |  | ST |  | 1
U3, U4, U5, U6 | PS2501L-1 | PS2501L-1 |  | NEC | PS2501L-1 | 4
U7 | ATM90E36 | TQFP-48(7x7) |  | ATMEL | ATM90E36A | 1
X1 | 16.384MHz | XTAL-MIX-49 | 16.384MHz,+/-20PPM,18PF, Level≤100µW | e.g. YXC | e.g. X49SD16384MSD2SI-1 | 1
 |  |  |  |  |  | 128
