venam123/Open_STMPLC/Document/ATM90E3x_V1.05/Hardware/ATSAM4C-CB V1.0/ATSAM4C-CB BOM.xlsx

Bill of Materials |  | Bill of Materials For Project [ATSAM4C-CB.PrjPcb]
Source Data From: | ATSAM4C-CB.PrjPcb
Project: | ATSAM4C-CB.PrjPcb
Variant: | None
Creation Date: | 7/23/2013 | 10:06:57
Print Date: | 2013-10-25 | 10:23:07
Designator | Comment | Footprint | Designation | Manufacturer | Part Number | Quantity
BT1 | 3000TR | X-S_3000_01 | BATTERY HOLDER | Keystone | 3000TR | 1
C1, C6, C7, C8 | 20pF | C0603 | Ceramic Capacitor |  |  | 4
C2 | 47uF | C_TANT_B3528 | Tantalum Capacitor |  |  | 1
C3 | 22uF | C_TANT_B3528 | Tantalum Capacitor |  |  | 1
C4, C5, C9, C10, C11, C12, C14, C16, C17, C18, C19, C21, C22, C23, C24, C26, C28, C29, C30, C31, C33, C35, C37, C40, C42, C43, C48, C49, C50, C51, C55, C56, C57, C58, C59, C60, C61, C62, C63, C65, C67, C68, C69 | 0.1uF | C0603 | Ceramic Capacitor |  |  | 43
C13, C15 | 10uF | C0805 | Ceramic Capacitor |  |  | 2
C20, C25, C27, C32, C34, C36, C38, C39, C44, C45 | 2.2uF | C0805 | Ceramic Capacitor |  |  | 10
C41, C54 | 4.7uF | C0805 | Ceramic Capacitor |  |  | 2
C46, C47 | 47pF | C0603 | Ceramic Capacitor |  |  | 2
C52, C53 | 1uF | C0805 | Ceramic Capacitor |  |  | 2
D1 | 1N4147 | DIODE-SMD |  |  |  | 1
D2, D4, D5, D6 | LED | LED-0805 |  |  |  | 4
D3 | IR | LED-5mm |  |  |  | 1
J2 | HDR1X2 | HDR1X2(None) |  |  |  | 1
J3 | 105017-0001 | micro_usb_dip_b | MicroUSB B port,5 Position,Right Angle,Gold Flash 1u |  |  | 1
J4 | Terminal-Screw-2 | TE-1776119-2 |  | Tyco | 1776119-2 | 1
J5 | D Connector 9 | DSUB1.385-2H9 | Receptacle Assembly, 9 Position, Right Angle |  |  | 1
J6 | HDR2X10 | HDR2X10 | 2.54mm Pitch THU 20 Pins Box Connector | SAMTEC | HTST-110-01-L-D | 3
J7 | HDR2X10 | HDR2X10 | Header,Right Angle,2x10Pin,2.54MM pitch |  |  | 3
J8 | HDR2X10 | HDR2X10 | Header,Straight,,2x10Pin,2.54MM pitch |  |  | 3
JP1, JP2, JP3, JP6, JP7 | JMP | JMP |  |  |  | 5
JP4, JP5 | JMP3 | JMP3 |  |  |  | 2
L1, L2 | 56uH | 1210 | INDUCTOR 56UH FIXED 1210 5% | Panasonic | ELJ-DA560JF | 2
L3 | 220ohm @100MHZ | 0805 | FerriteBead,220ohm@100MHz,2000mA,0.045ohm | Murata | BLM21PG221SN1D | 1
LCD1 | JY12298 | LCD_JY12298 |  |  |  | 1
PW1 | PowerJack | PowerJacket2.5 |  |  |  | 1
Q1 | PT334-6C | LED-DIP-100 | PT334-6C；EVERLIGHT; |  |  | 1
Q2 | PNP | SOT-23 |  |  |  | 1
Q3 | NPN | SOT-23 |  |  |  | 1
R1 | 510R | R0603 | Chip Resistor |  |  | 1
R2 | 680K | R0603 | Chip Resistor |  |  | 1
R3, R13, R14, R15, R17, R24, R28, R37, R38, R48, R49, R50, R51, R62, R63, R64, R65, R66, R67, R68, R69, R70, R71, R72, R73, R74, R75, R77, R79 | 0R | R0603 | Chip Resistor |  |  | 29
R4 | 240K | R0603 | Chip Resistor |  |  | 1
R5, R6, R7, R8, R9, R10, R16, R22, R27, R33, R34, R35, R36, R42, R43, R44, R46, R47, R78 | 10K | R0603 | Chip Resistor |  |  | 19
R11, R12 | 2R2 | R0603 | Chip Resistor |  |  | 2
R18, R19, R21, R26 | 1K | R0603 | Chip Resistor |  |  | 4
R20 | 270R | R0603 | Chip Resistor |  |  | 1
R23 | 1K5 | R0603 | Chip Resistor |  |  | 1
R25 | 100R | R0603 | Chip Resistor |  |  | 1
R29, R31 | 150R | R0603 | Chip Resistor |  |  | 2
R30 | 3K3 | R0603 | Chip Resistor |  |  | 1
R32 | 3.3K | R0603 | Chip Resistor |  |  | 1
R39, R40, R58, R59, R60, R61 | 100K | R0603 | Chip Resistor |  |  | 6
R41, R45 | 47K | R0603 | Chip Resistor |  |  | 2
R52 | 470R | R0603 | Chip Resistor |  |  | 1
R54 | 470K | R0603 | Chip Resistor |  |  | 1
R55, R56, R57 | 33R | R0603 | Chip Resistor |  |  | 3
R76 | 4K7 | R0603 | Chip Resistor |  |  | 1
S1, S2, S3, S4, S5 | KEY | KEY-4P - SMD |  |  |  | 5
U1 | 78L33 | SOT-89 |  | ST |  | 1
U2 | AT91SAM4C16C | LQFP-100 |  |  |  | 1
U3 | FT232RL | SSOP-28 | IC,USB to serial UART interface | FTDI | FT232RL-REEL | 1
U4 | IR-RX | IR-Rx |  |  |  | 1
U5, U6 | SFH6345-X007 | SO08-400 | IC,High Speed Optocoupler 1Mbd 15kV/μs CMR Transistor Output |  |  | 2
U7 | TLV70033QDDCRQ1 | SOT23-5 | IC,200-mA Low-IQ Low-Dropout Regulator | TI | TLV70033QDDCR | 1
U8 | ADM3312EA | TSSOP-24 |  |  |  | 1
U9 | ADM3485 | SOP-8 |  |  |  | 1
U10 | AT24C1024BN-SH25-S | SO8 | Two Wires Serial EEPROM |  |  | 1
U11 | ATSHA204-SH-DA-T | SO8 | IC,CryptoAuthentication,ATSHA204-SH-DA-T |  |  | 1
U12 | AT25DF321A-SH-T | SOIC8 | 32 Mb Serial DataFlash |  |  | 1
X1 | 8.192MHz | crystal_5032 | Crystal,ABM3B-8.192MHz-B2-T,8.192MHz,+/-20PPM,18PF | Abracon | ABM3B-8.192MHZ-B2-T | 1
X2 | 32.768KHz | CFPX-217 | Crystal,CFPX-217,32.768KHz,+/-20PPM,12.5PF,3.2 x1.5MM,SMD | IQD | CFPX-217 | 1
 |  |  |  |  |  | 199
