venam123/Open_STMPLC/Quatation/Mass_Qty_Queatation.xlsx

Mass_Quantity (LCSC Site)
Sr No | Description | PCB Qunatity | BOM Cost in Doller | BOM Cost in Ruppes | Per PCB Cost in Doller | Per PCB Cost in Ruppes
1 | Main_PCB | 1000 | 16648.6 | 1612583.396 | 16.6486 | 1612.583396
2 |  | 2000 | 32269.4 | 3125614.084 | 16.1347 | 1562.807042
3 | IO_PCB | 1000 | 39405.5 | 3816816.73 | 39.4055 | 3816.81673
4 |  | 2000 | 78103.6 | 7565114.696 | 39.0518 | 3782.557348
 | Combine Main + IO PCB Price
 | 1000 Qty | 5429.400126
 | 2000 Qty | 5345.36439
