venam123/Open_STMPLC/Document/Controller/Controller Card/Project Outputs for PLC_Controller Card/PLC_Controller Card.xlsx

Comment | Description | Designator | Footprint | LibRef | Quantity | Value | Part Number | PartNumber | Resistance | Capacitance
S8411-45R | BATTERY HOLDER COIN 12MM SMD | BT1 | FP-S8411-45R-MFG | CMP-15817-000007-1 | 1
NA |  | C1, C2 | CAPC2013X145X50ML20T25 | CMP-1036-04819-2 | 2 |  | C0805C225K9PACTU
GRM21BR71H104KA01L | Chip Capacitor, 0.1 uF, +/- 10%, 50 V, -55 to 125 degC, 0805 (2012 Metric), RoHS, Tape and Reel | C3 | CAPC2013X135X45ML10T25 | CMP-2100-03644-1 | 1 |  |  |  |  | 100nF
C0805C101J1GACTU | CAP CER 100PF 100V C0G/NP0 0805 | C4 | FP-C0805C-DN-MFG | CMP-03020-014281-1 | 1 | 100 pF |  |  |  | 100 pF
CC0603KRX5R8BB475 | CAP CER 4.7UF 25V X5R 0603 | C5 | FP-CC0603-DA-MFG | CMP-03422-001217-1 | 1 | 4.7 uF |  |  |  | 4.7 uF
CC0603KRX7R6BB105 | CAP CER 1UF 10V X7R 0603 | C6, C11 | FP-CC0603-DA-MFG | CMP-03422-000835-1 | 2 | 1 uF |  |  |  | 1 uF
CC0603KRX7R6BB103 | CAP CER 10000PF 10V X7R 0603 | C7, C12 | FP-CC0603-DA-MFG | CMP-03422-000575-1 | 2 | 10 nF |  |  |  | 10 nF
C0603C104K8PAC7867 | CAP CER SMD 0603 .1UF 10% X5R 10 | C8, C9, C10, C13, C16 | FP-C0603C-CF-MFG | CMP-03020-019869-2 | 5 | 0.1μF |  |  |  | 0.10 μF
CC0603KPX5R5BB225 | CC0603 2.2 uF X5R 10.00% 6.3 V | C14, C15 | FP-CC0603-DA-MFG | CMP-03422-000566-1 | 2 | 2.2 uF |  |  |  | 2.2 uF
0.1uF |  | C17, C60, C61, C62, C63, C64, C65 | CAPC1608X92X38ML15T08 | CMP-2006-01211-1 | 7 |  | VJ0603Y104KXJAP
C0805C106K8PACTU | CAP CER 10UF 10V X5R 0805 | C18, C21, C22 | FP-C0805C-DG-MFG | CMP-2007-03243-2 | 3 | 10uF |  |  |  | 10uF
08051C104K4T2A | Automotive Ceramic Capacitor, 0805, 100nF, 10%, X7R, 15%, 100V | C19, C20, C23 | FP-0805-L_2_01_0_2-W_1_25-IPC_B | CMP-2007-04172-2 | 3 |  |  |  |  | 100nF
EEE-HA1H100P | CAP ALUM 10UF 20% 50V SMD | C24 | FP-HAD-MFG | CMP-05427-000102-1 | 1 |  |  |  |  | 10uF
C1206C106K3RACAUTO | CAP CER 10UF 25V X7R 1206 | C25, C26, C32, C33, C39, C40 | FP-C1206C-EH-MFG | CMP-03020-004605-1 | 6 | 10uF |  |  |  | 10uF
C1206C104F3GACAUTO | C1206 0.10 μF C0G 1.00% 25 V | C27, C31, C34, C38, C41, C45 | FP-C1206C-EB-MFG | CMP-03020-009647-2 | 6 | 0.1μF |  |  |  | 0.10 μF
CAP 22uF 16V 1206(3216) | CAP 22uF 16V -20% to +80% 1206 (3216 Metric) Thickness 1.9mm SMD | C28, C29, C30, C35, C36, C37, C42, C43, C44 | CAPC1206(3216)190_L | CMP-1037-04994-1 | 9 | 22uF
CAP 100nF 16V 1206(3216) | CAP 100nF 16V ±20% 1206 (3216 Metric) Thickness 1.7mm SMD | C46, C49 | CAPC1206(3216)170_L | CMP-1037-04183-1 | 2 | 100nF
C1206C330M4GACTU | CAP CER 33PF 16V NP0 1206 | C47, C50, C57, C58, C59 | FP-C1206C-EB-MFG | CMP-1037-01126-2 | 5 | 33 pF |  |  |  | 33 pF
CAP 10pF 16V 1206(3216) | CAP 10pF 16V ±10% 1206 (3216 Metric) Thickness 1mm SMD | C48, C51 | CAPC1206(3216)100_N | CMP-1037-00631-1 | 2 | 10pF
EEEFK1C101P | Aluminum Electrolytic Capacitor, 100 uF, 20%, 16 V, -55 to 105 degC, 2-Pin SMD, RoHS, Tape and Reel | C52, C53 | PNSC-EEEFK1C101P_L | CMP-2000-06203-1 | 2 |  |  |  |  | 100µF
C0805C103K2RACTU | CAP CER 10000PF 200V X7R 0805 | C54 | FP-C0805C-DN-MFG | CMP-2007-00259-2 | 1 | 10,000 pF |  |  |  | 10,000 pF
08051A102J4T2A |  | C55, C56 | CAPC2013X94X50NL20T25 | CMP-2007-04125-1 | 2 |  | 08051A102J4T2A
VJ0603A180JXAAC |  | C66, C67 | CAPC1608X92X38ML15T08 | CMP-2006-01139-1 | 2 |  | VJ0603A180JXAAC
C0603C120C5GAC7867 | CAP CER 12PF 50V NP0 0603 | C68, C69 | FP-C0603C-CF-MFG | CMP-03020-011295-1 | 2 | 12 pF |  |  |  | 12 pF
KP-3216PBC-A | LED, Low Power, Blue, SMD, 1.6mm x 2mm, 20 mA, 3.2 V, 470 nm | D1, D2, D3, D4 | FP-KP-3216PBC-A-MFG | CMP-44529-000052-1 | 4
SM712-02HTG | TVS DIODE 12V 31V SOT23-3 | D5 | FP-SM712-MFG | CMP-2000-07561-2 | 1 |  |  |  |  | 75pF
ESD5Z2.5T1G | Transient Voltage Suppressor, Micro-Packaged Diode for ESD Protection, 2-Pin SOD-523, Pb-Free, Tape and Reel | D6, D7, D8, D17, D18, D19, D20, D21 | ONSC-SOD-523-2-502-01_V | CMP-1063-00103-1 | 8 |  |  | ESD5Z2.5T1G
SS34-E3/9AT | DIODE SCHOTTKY 40V 3A DO214AB | D9 | FP-SMC-MFG | CMP-02539-000066-1 | 1
SML-LX0805SRC-TR | LED RED CLEAR SMD | D10, D12, D13, D14, D16 | FP-SML-LX0805SRC-TR-MFG | CMP-57192-000013-1 | 5
SMBJ33A | TVS DIODE 33V 53.3V DO214AA | D11 | FP-SMBJ-MFG | CMP-2000-07095-2 | 1
MMSZ4V7T1G | Zener Voltage Regulator, 500 mW, 2-Pin SOD-123, Pb-Free, Tape and Reel | D15 | ONSC-SOD-123-2-425-04_V | CMP-1060-00343-1 | 1 |  |  | MMSZ4V7T1G
LTST-C191TBKT | LED BLUE CLEAR CHIP SMD | D22, D23 | FP-LTST-C191TBKT-MFG | CMP-22017-000008-1 | 2
1812L150/24MR | PTC RESET FUSE 24V 1.5A 1812 | F1 | FP-1812L-MFG | CMP-08606-000018-1 | 1 | 0.04-0.12Ω |  |  | 0.04-0.12Ω
0473003.YRT1L | FUSE BRD MNT 3A 125VAC/VDC AXIAL | F2 | FP-473-0 | CMP-08605-000017-1 | 1 | 0.0380Ω |  |  | 0.0380Ω
BLM21AG121SN1D | FERRITE BEAD 120 OHM 0805 1LN | FB1 | FP-BLM21-0_2-t0_85-e0_5-IPC_A | CMP-0686-00716-3 | 1 |  |  |  | 150mR
U.FL-R-SMT(10) | CONN U.FL RCPT STR 50 OHM SMD | J1, J2 | FP-U_FL-R-SMT_10-MFG | CMP-0029-00003-2 | 2
MSD-1-A | Micro SD Card Connector, 9 Positions, Connector and Ejector, Push In, Auto Eject Out, Surface Mount, 1.8 mm Height Above Board, Gold Flash | J3 | MSD1A | MSD-1-A | 1
1729128 | PCB Terminal Block, 13.5 A, 400 V, 2-Pin THD, RoHS, Bulk | J4 | PHOE-1729128-2_V | CMP-2000-05815-1 | 1 |  |  | 1729128
SIM8066-6-1-14-01-A | SIM8066-6-1-14-01-A Memory Card Connectors 1.44mm Nano SIM Conn w/Peg and Switch | J5 | FP-SIM8066-6-1-14-01-A-MFG | CMP-03329-117635865-1 | 1
315-43-106-41-001000 | 315-43-106-41-001000 IC & Component Sockets Interconnect Socket | J6 | FP-315-43-106-41-001000-MFG | CMP-00254-12081839-1 | 1
10104110-0001LF | Micro USB, Receptacle, -55 to 85 degC, 5-Pin SMD, RoHS, Tape and Reel | J7 | FCI-10104110-0001LF_V | CMP-2000-05823-1 | 1
LQW18AN47NG00D | Wire Wound RF Inductor 47nH ±2% 380mA 0.29Ω 0603 (1608) | L1 | FP-LQW18AN_00-MFG | CMP-06042-007966-1 | 1
IFSC1515AHER2R2M01 | FIXED IND 2.2UH 3A 45 MOHM SMD | L2, L3, L4 | FP-IFSC1515AH-MFG | CMP-02424-000690-1 | 3
Header 10X2 | Header, 10-Pin, Dual row | P1 | HDR2X10 | Header 10X2 | 1
Header 20 | Header, 20-Pin | P2 | HDR1X20 | Header 20 | 1
Header 14 | Header, 14-Pin | P3 | HDR1X14 | Header 14 | 1
Header 3 | Header, 3-Pin | P5 | HDR1X3 | Header 3 | 1
61900411121 |  | P6, P7 | 61900411121 | CMP-1502-00586-2 | 2
691317510004 | 691317510004 Terminal block, 5.08mm pitch, close horizontal PCB header, flanges, 4 Pins | P8, P9 | 691317510004 | CMP-03913-90321403-1 | 2
MMBT3904 | NPN General Purpose Amplifier, 40 V, 0.2 A, -55 to 150 degC, 3-Pin SOT23, RoHS, Tape and Reel | Q1, Q2, Q3, Q4, Q5, Q6, Q7 | FAIR-SOT23-3_V | CMP-1670-00008-1 | 7 |  |  |  |  | 1.8E-11 f
0R | RES Thick Film, 0Ω, 0.125W, 0805 | R1, R2 | FP-CRCW0805-e3-IPC_B | CMP-2001-04897-2 | 2 |  |  |  | 0mR
CRCW08052K20FKEA | RES Thick Film, 2.2kΩ, 1%, 0.125W, 100ppm/°C, 0805 | R3, R4, R9, R10 | FP-CRCW0805-e3-IPC_B | CMP-2001-03760-2 | 4 |  |  |  | 2.2K
CRG0805F1K0 | CRG0805F1K0 Thick Film Resistors - SMD 1K Ohm 1% 1/8W Res Thick Film 0805 | R5, R6, R11, R43, R44, R47, R48 | FP-CRG0805-IPC_A | CMP-03790-16077480-1 | 7 |  |  |  | 1kΩ
RC0805FR-0710KL | Chip Resistor, 10 KOhm, +/- 1%, 0.125 W, -55 to 155 degC, 0805 (2012 Metric), RoHS, Tape and Reel | R7, R8, R12, R42, R45, R46, R49, R50 | RESC2013X60X35NL10T20 | CMP-1659-00013-4 | 8 | 10K
CRCW060310K0FKED | RES Thick Film, 10kΩ, 1%, 0.1W, 100ppm/°C, 0603 | R13, R14, R15, R30, R32, R34, R36, R38, R40 | FP-CRCW0603-e3-IPC_A | CMP-02407-003273-1 | 9 |  |  |  | 10kR
RC0805FR-071KL | Chip Resistor, 1 KOhm, +/- 1%, 125 mW, -55 to 155 degC, 0805 (2012 Metric), RoHS, Tape and Reel | R16, R18 | RESC2013X60X35ML10T20 | CMP-2100-03671-1 | 2 |  |  |  | 1KOhm
CRCW0805120RFKEA | RES Thick Film, 120Ω, 1%, 0.125W, 100ppm/°C, 0805 | R17 | FP-CRCW0805-e3-MFG | CMP-02407-007854-1 | 1 |  |  |  | 120R
RC0805FR-074K7L | General Puprose Chip Resistor, 4700 Ohm +/- 1%, 0.125 W, -55 to 155 degC, 2-Pin SMD, RoHS, Tape and Reel | R19, R20, R21, R22, R23 | YAGO-RC0805_M | CMP-1568-00001-1 | 5 |  |  | RC0805FR-074K7L | 4.7K
CRGCQ0603J1K0 | CRGCQ 0603 1K0 5% | R24, R29, R35, R37, R41 | FP-CRGCQ0603-IPC_C | CMP-03211-006828-1 | 5 | 1KΩ |  |  | 1KΩ
CRCW080551K0FKEA |  | R25, R51 | RESC2013X50X30NL20T20 | CMP-2001-03993-1 | 2 | 51K | CRCW080551K0FKEA
12K | RES 100K OHM 1% 1/8W 0805 | R26 | FP-RC0805-0_6-IPC_C | CMP-2100-03668-5 | 1 |  |  |  | 20K
CRCW0805470RJNEAHP | RES Thick Film, 470Ω, 5%, 0.5W, 200ppm/°C, 0805 | R27 | FP-CRCW0805-HPe3-MFG | CMP-2001-04210-2 | 1 |  |  |  | 470R
CR0805-FX-4702ELF | Thick Film Chip Resistors 0805 47kΩ 0.125W 1% 100ppm/°C | R28 | FP-CR0805-IPC_C | CMP-07231-004291-1 | 1
CRCW060332K4FHEAP | RES Thick Film, 32.4kΩ, 1%, 0.1W, 50ppm/°C, 0603 | R31, R33, R39 | FP-CRCW0603-Pe3-IPC_B | CMP-03613-000206-1 | 3 |  |  |  | 54.9K, 44.2K, 33.2kR
AC0603JR-0710ML | RES 10MΩ 5.00% 0.1W 0603 | R52, R57 | FP-AC0603-IPC_A | CMP-03412-043768-1 | 2 |  |  |  | 10MR
CRGCQ0603F1K2 | CRGCQ 0603 1K2 1% | R53, R58 | FP-CRGCQ0603-IPC_C | CMP-03211-000516-1 | 2 | 1.2KΩ |  |  | 1.2KΩ
DNP | 35.7Ω ±1% 0.4W 0805 Anti-Surge Chip Resistor AEC-Q200 | R54, R55, R59, R60 | FP-ESR10-IPC_A | CMP-08839-006492-1 | 4 |  |  |  | 35.7R
4K | 35.7Ω ±1% 0.4W 0805 Anti-Surge Chip Resistor AEC-Q200 | R56, R61 | FP-ESR10-IPC_A | CMP-08839-006492-1 | 2 |  |  |  | 35.7R
EVP-BB2A9B000 | SWITCH TACTILE SPST-NO 0.02A 15V | SW1 | FP-EVP-BB2A9B000-MFG | CMP-05618-000013-1 | 1
EC200U |  | U1 | XCVR_EC200U | EC200U | 1
STM32F407VGT6 |  | U2 | FP-LQFP100-1L-IPC_A | CMP-0243-00017-5 | 1
W5500_LITE |  | U3 | W5500 | W5500 | 1
ISO3088DWR | Isolated RS-485 Transceiver, 20 Mbps, 5 V, Half Duplex, -40 to 85 degC, 16-pin SOIC (DW) | U4 | DW0016B_N | CMP-0316-00040-2 | 1 |  |  | ISO3088DWR
TCA9517DR | IC TRNSLTR BIDIRECTIONAL 8SOIC | U5 | FP-D0008A-MFG | CMP-04881-000005-1 | 1
W25Q16JVSNIQ TR | IC FLASH 16MBIT SPI/QUAD 8SOIC | U6 | FP-W25Q16JVSNIQ_TR-IPC_A | CMP-78876-000009-2 | 1
MIC29302WU-TR | IC REG LINEAR POS ADJ 3A TO263-5 | U7 | FP-C04-012-MFG | CMP-06324-000007-1 | 1
TPS60400DBVR | IC REG CHARG PUMP INV 60MA SOT23 | U8 | FP-DBV0005A-IPC_C | CMP-0391-00019-3 | 1
TPS563200DDCR | IC REG BUCK ADJ 3A TSOT23-6 | U9, U10, U11 | FP-DDC0006A-MFG | CMP-04918-000155-1 | 3
MAX31865ATP+ | RTD-to-Digital Converter | U12, U13 | QFN65P500X500X80-21N | MAX31865ATP+ | 2
ABM8-25.000MHZ-B2-T3 | Crystal 25MHz ±20ppm 18pF SMD-4 3.2mm x 2.5mm | Y1 | FP-ABM8-MFG | CMP-27762-001275-1 | 1
ABS09-32.768KHZ-1-T | CRYSTAL 32.7680KHZ 12.5PF SMD | Y2 | FP-ABS09-MFG | CMP-27762-005385-1 | 1
