venam123/Open_STMPLC/Hardware/Running_Hardware/Open_STMPLC_EnergyMon_V0..1/Libraries_Open_STMPLC_EnergyMon/3D_Models/DC-DC_B5050S-1W.stp

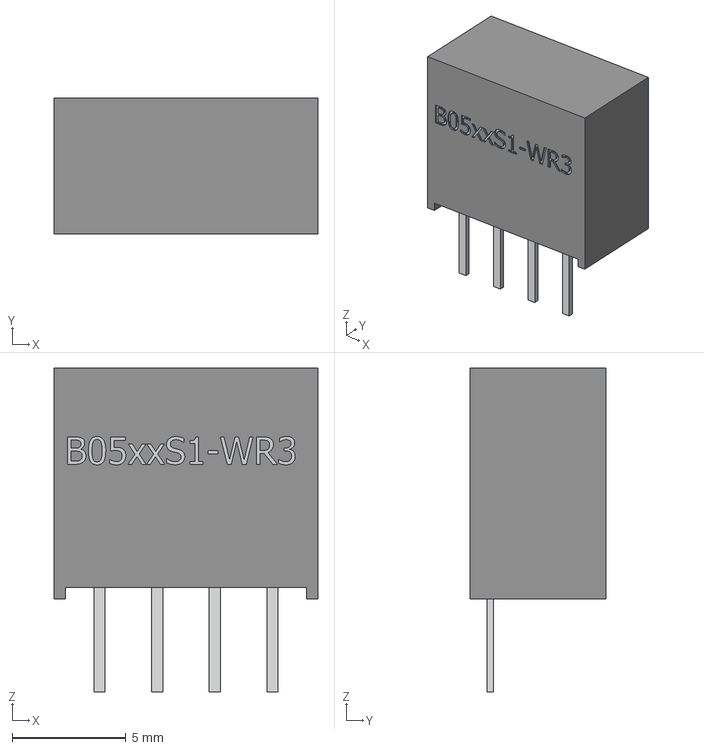
[picture p5: CAD file, 2026-06-21]
Hardware/Running_Hardware/Open_STMPLC_EnergyMon_V0..1/Libraries_Open_STMPLC_EnergyMon/3D_Models/DC-DC_B5050S-1W.stp
11.6 x 6.00 x 14.3 mm
