venam123/Open_STMPLC/Hardware/Running_Hardware/Open_STMPLC_EnergyMon_V0..1/Open_STMPLC_EnergyMon_V0..1.step

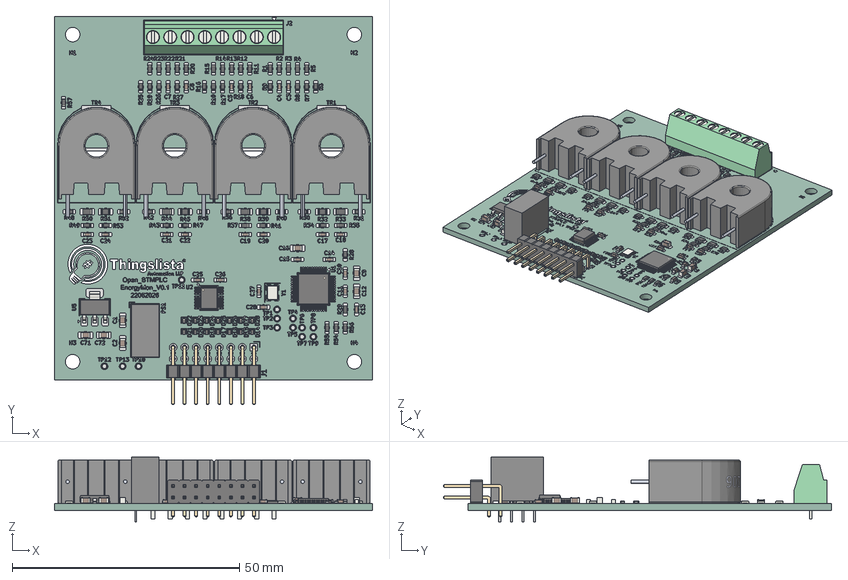
[picture p6: CAD file, 2026-06-22]
Hardware/Running_Hardware/Open_STMPLC_EnergyMon_V0..1/Open_STMPLC_EnergyMon_V0..1.step
70.0 x 85.4 x 14.3 mm
R_0603_1608Metric x 49
C_0603_1608Metric x 23
R_0805_2012Metric x 8
D_SOD-882 x 14
PinHeader_2x08_P2.54mm_Horizontal
zmct206 x 4
C_0805_2012Metric x 7
TQFP-48_7x7mm_P0.5mm
TerminalBlock_Phoenix_MKDS-1-8-3.81_1x08_P3.81mm_Horizontal
DC-DC_B5050S-1W
Crystal_SMD_3225-4Pin_3.2x2.5mm
SSOP-16_3.9x4.9mm_P0.635mm
SOT-223
Open_STMPLC_EnergyMon_V0..1_pad
Open_STMPLC_EnergyMon_V0..1_silkscreen x 2
Open_STMPLC_EnergyMon_V0..1_PCB
