venam123/Open_STMPLC/Hardware/Running_Hardware/Open_STMPLC_IO_V0.1/DXF_Plot/Universal_PLC_Top_PCB.dxf

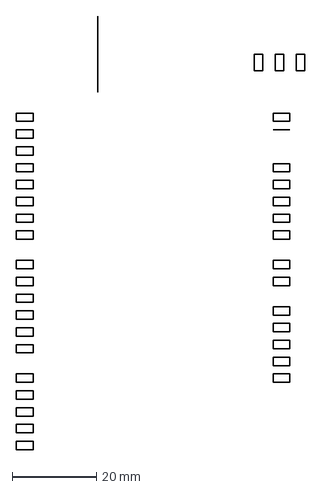
[picture p7: CAD file, 2026-04-20]
Hardware/Running_Hardware/Open_STMPLC_IO_V0.1/DXF_Plot/Universal_PLC_Top_PCB.dxf
68.5 x 103.0 mm
