venam123/Open_STMPLC/Hardware/Running_Hardware/Open_STMPLC_EnergyMon_V0..1/Libraries_Open_STMPLC_EnergyMon/3D_Models/zmct206.STEP

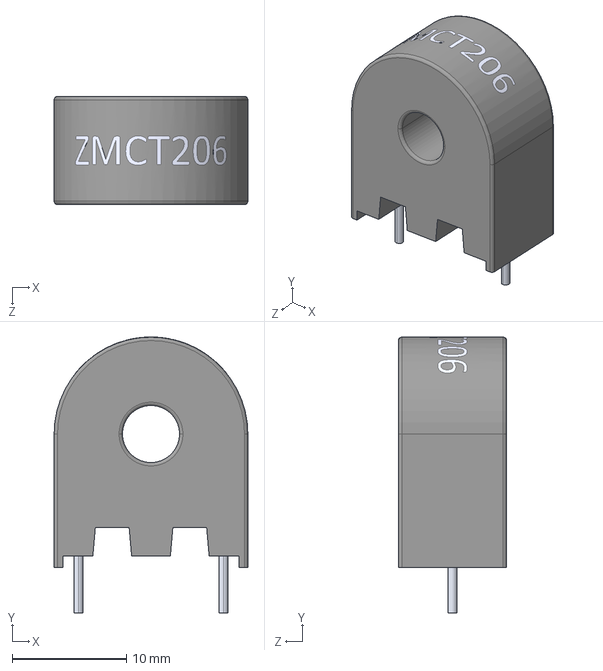
[picture p8: CAD file, 2026-06-21]
Hardware/Running_Hardware/Open_STMPLC_EnergyMon_V0..1/Libraries_Open_STMPLC_EnergyMon/3D_Models/zmct206.STEP
17.0 x 24.2 x 9.50 mm
