venam123/Open_STMPLC/Hardware/Running_Hardware/Open_STMPLC_IO_V0.1/DXF_Plot/Universal_PLC_Bottom_PCB.dxf

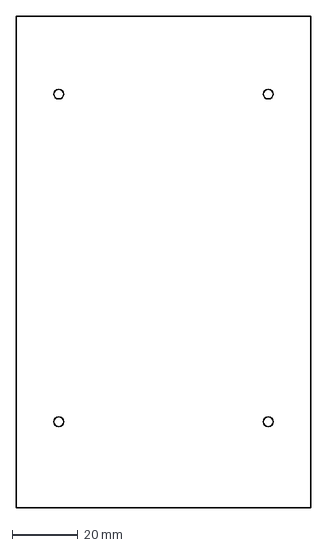
[picture p9: CAD file, 2026-04-20]
Hardware/Running_Hardware/Open_STMPLC_IO_V0.1/DXF_Plot/Universal_PLC_Bottom_PCB.dxf
90.0 x 150.0 mm
