venam123/Open_STMPLC/Hardware/Running_Hardware/Open_STMPLC_IO_V0.1/Libraries_Open_STMPLC_IO/3D_Models/A-DF_09_PP_Z.stp

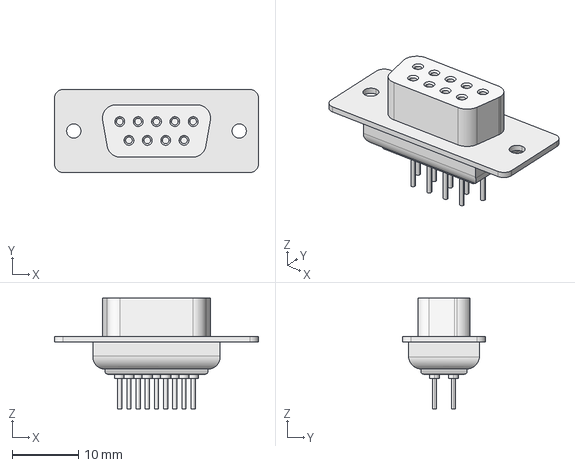
[picture p10: CAD file, 2026-05-02]
Hardware/Running_Hardware/Open_STMPLC_IO_V0.1/Libraries_Open_STMPLC_IO/3D_Models/A-DF_09_PP_Z.stp
30.8 x 12.6 x 16.7 mm
