venam123/Open_STMPLC/Hardware/Running_Hardware/Open_STMPLC_IO_V0.1/Libraries_Open_STMPLC_IO/3D_Models/TPS1H200AQDGNRQ1.STEP

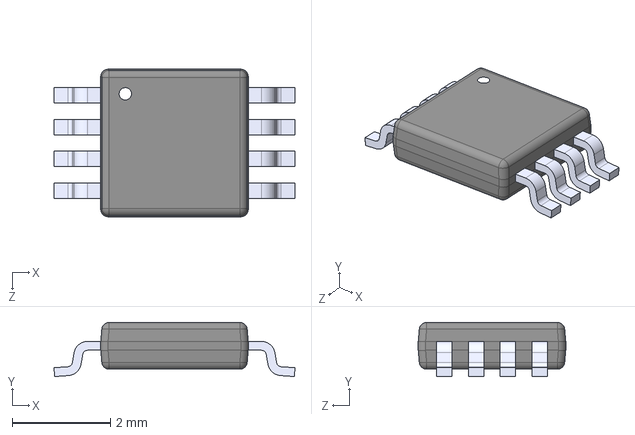
[picture p11: CAD file, 2026-04-26]
Hardware/Running_Hardware/Open_STMPLC_IO_V0.1/Libraries_Open_STMPLC_IO/3D_Models/TPS1H200AQDGNRQ1.STEP
4.90 x 1.10 x 3.00 mm
