venam123/Open_STMPLC/Hardware/Running_Hardware/Open_STMPLC_Main_V0.1/Libraries_Open_STMPLC_Main/3D_Models/EC200UCNAA.STEP

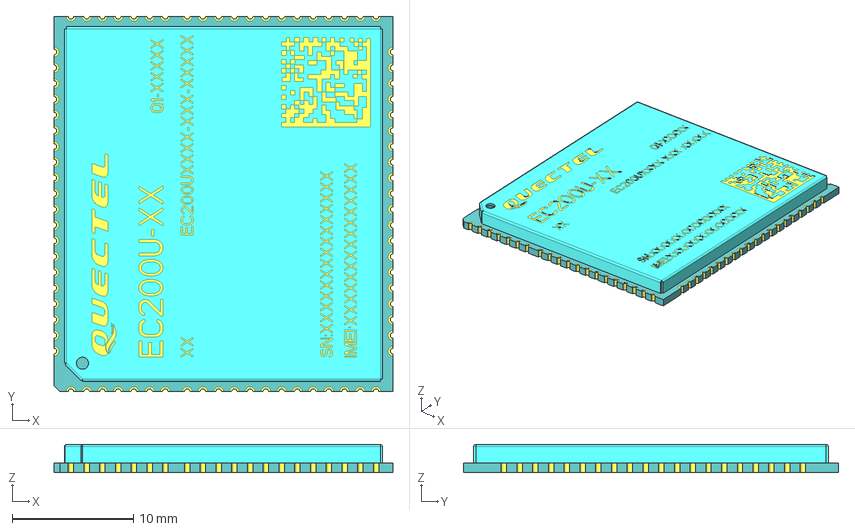
[picture p12: CAD file, 2026-05-13]
Hardware/Running_Hardware/Open_STMPLC_Main_V0.1/Libraries_Open_STMPLC_Main/3D_Models/EC200UCNAA.STEP
28.0 x 31.0 x 2.35 mm
EC200-CN_PCB_1
EC200X-CN_COVER_1
