venam123/Open_STMPLC/Hardware/Running_Hardware/Open_STMPLC_IO_V0.1/Libraries_Open_STMPLC_IO/3D_Models/NVTFS5124PLTAG.stp

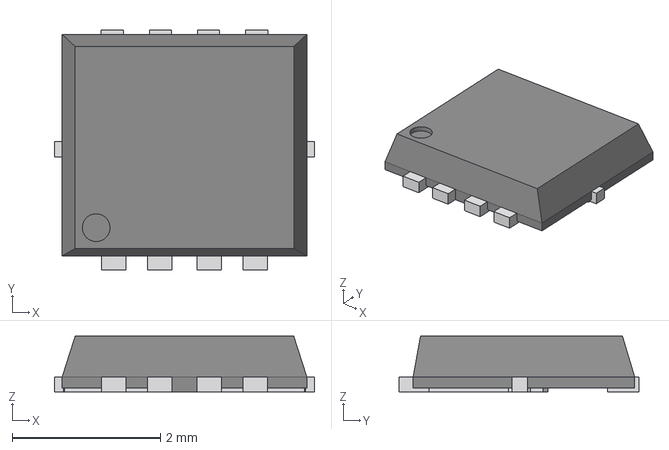
[picture p13: CAD file, 2026-03-25]
Hardware/Running_Hardware/Open_STMPLC_IO_V0.1/Libraries_Open_STMPLC_IO/3D_Models/NVTFS5124PLTAG.stp
3.50 x 3.24 x 0.75 mm
