venam123/Open_STMPLC/Hardware/Running_Hardware/Open_STMPLC_Main_V0.1/Libraries_Open_STMPLC_Main/3D_Models/CR2032_Holder_THT_Horizontal.STEP

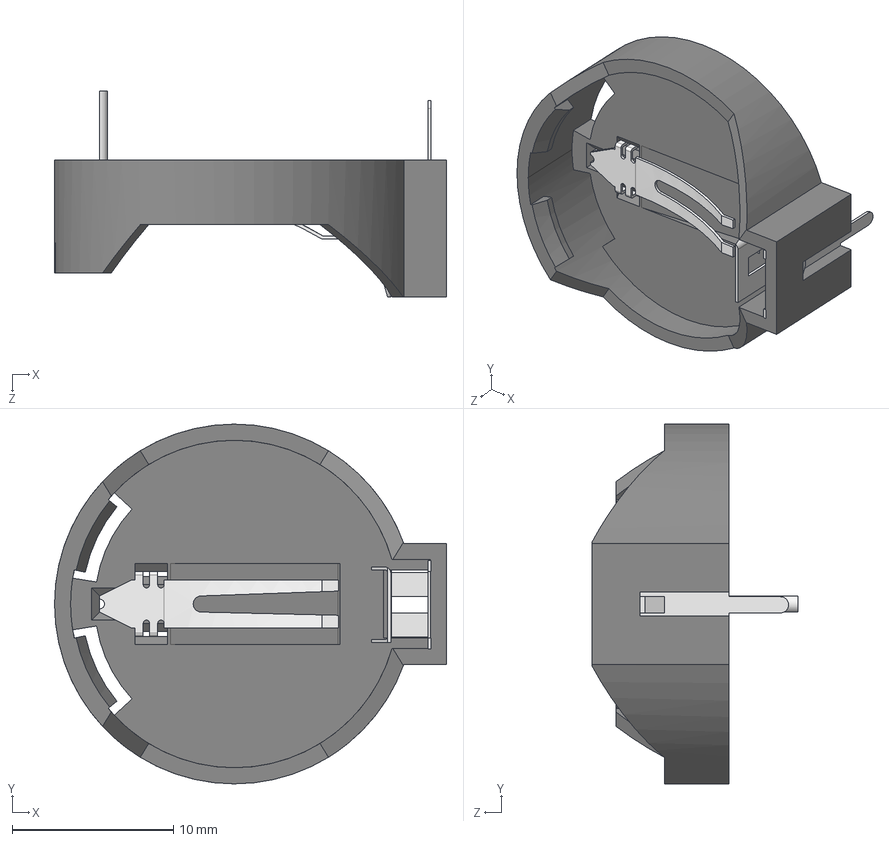
[picture p14: CAD file, 2026-05-13]
Hardware/Running_Hardware/Open_STMPLC_Main_V0.1/Libraries_Open_STMPLC_Main/3D_Models/CR2032_Holder_THT_Horizontal.STEP
24.3 x 22.3 x 12.8 mm
BH-642_Plastic
BH-642_Metal_minus
BH-642_Metal_plus
