venam123/Open_STMPLC/Hardware/Running_Hardware/Open_STMPLC_Main_V0.1/Libraries_Open_STMPLC_Main/3D_Models/Inductor_ASPI-0630LR.STEP

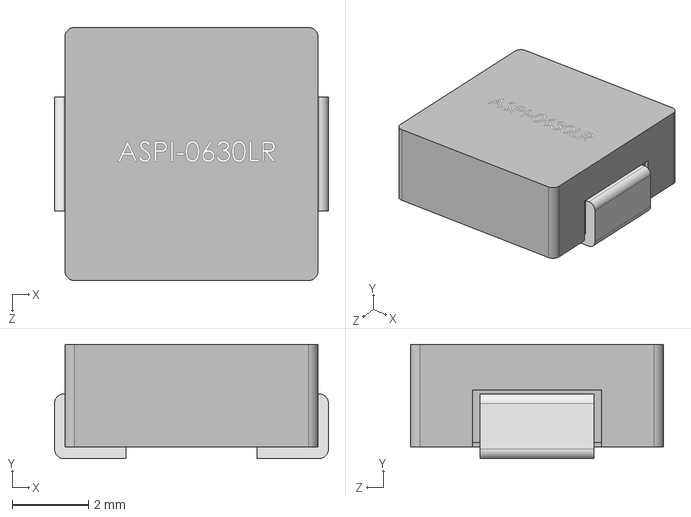
[picture p15: CAD file, 2026-05-13]
Hardware/Running_Hardware/Open_STMPLC_Main_V0.1/Libraries_Open_STMPLC_Main/3D_Models/Inductor_ASPI-0630LR.STEP
7.20 x 3.00 x 6.65 mm
