venam123/Open_STMPLC/Hardware/Running_Hardware/Open_STMPLC_Main_V0.1/Libraries_Open_STMPLC_Main/3D_Models/SD_Card_TF-01A.step

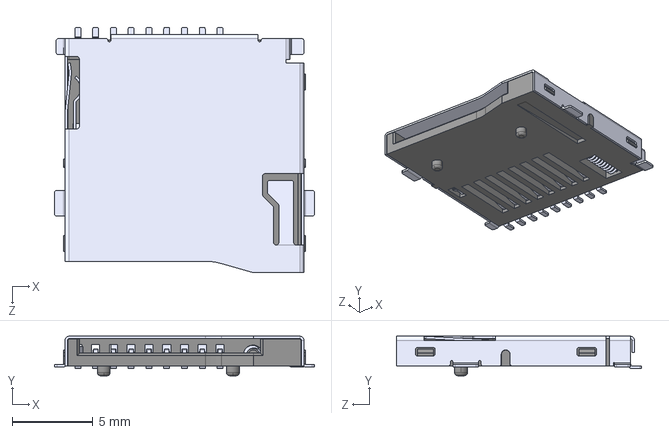
[picture p16: CAD file, 2026-05-11]
Hardware/Running_Hardware/Open_STMPLC_Main_V0.1/Libraries_Open_STMPLC_Main/3D_Models/SD_Card_TF-01A.step
16.1 x 2.45 x 15.2 mm
