venam123/Open_STMPLC/Hardware/Running_Hardware/Open_STMPLC_Main_V0.1/Libraries_Open_STMPLC_Main/3D_Models/SimCard_Nano.stp

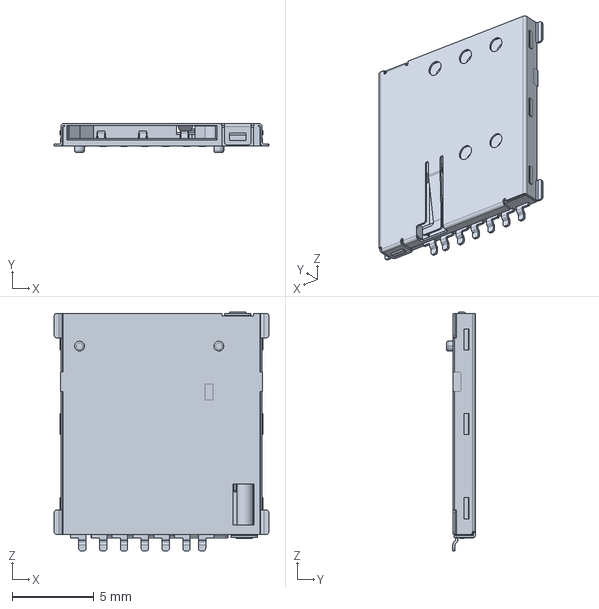
[picture p17: CAD file, 2026-04-04]
Hardware/Running_Hardware/Open_STMPLC_Main_V0.1/Libraries_Open_STMPLC_Main/3D_Models/SimCard_Nano.stp
13.1 x 1.77 x 14.6 mm
