venam123/Open_STMPLC/Hardware/Running_Hardware/Open_STMPLC_IO_V0.1/Libraries_Open_STMPLC_IO/3D_Models/10144517-043802LF.STEP

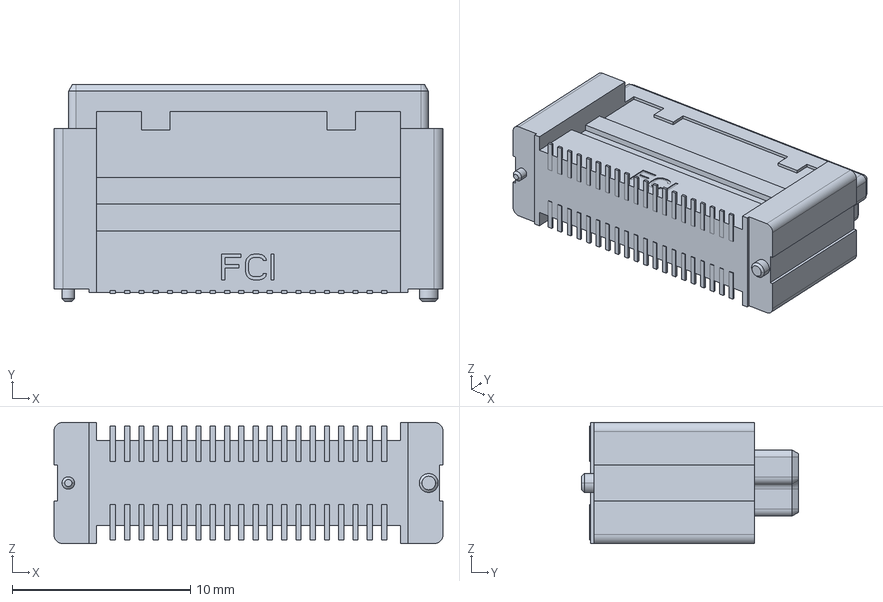
[picture p18: CAD file, 2026-05-24]
Hardware/Running_Hardware/Open_STMPLC_IO_V0.1/Libraries_Open_STMPLC_IO/3D_Models/10144517-043802LF.STEP
21.8 x 12.2 x 6.80 mm
