venam123/Open_STMPLC/Hardware/Running_Hardware/Open_STMPLC_Main_V0.1/Libraries_Open_STMPLC_Main/3D_Models/10144518-042802LF.STEP

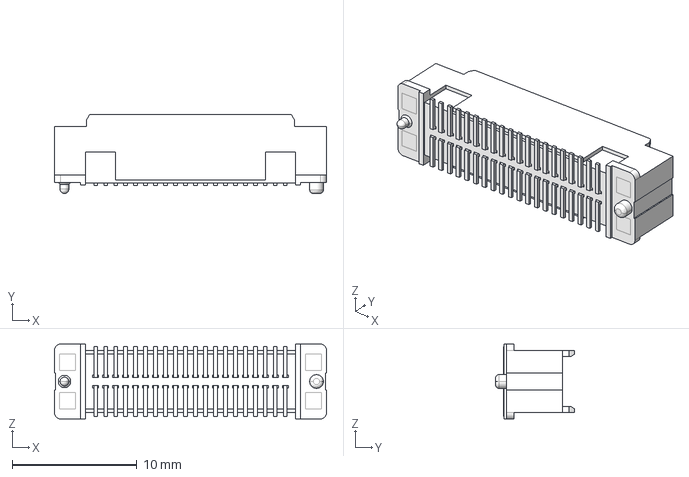
[picture p19: CAD file, 2026-05-24]
Hardware/Running_Hardware/Open_STMPLC_Main_V0.1/Libraries_Open_STMPLC_Main/3D_Models/10144518-042802LF.STEP
21.8 x 6.35 x 6.00 mm
