venam123/Open_STMPLC/(list of files, cad)

Other CAD files:
Document/DXF Files/LK-PLC18_Botton_PCB.dxf
Document/DXF Files/LK-PLC18_Top_PCB.dxf
Document/DXF Files/LK-PLC18_Top_Bottom_Overlapp.dxf
Hardware/Running_Hardware/Open_STMPLC_IO_V0.1/DXF_Plot/Universal_PLC_Bottom_PCB.dwg
Hardware/Running_Hardware/Open_STMPLC_IO_V0.1/DXF_Plot/Universal_PLC_Top_PCB.dwg
Hardware/Running_Hardware/Open_STMPLC_IO_V0.1/Libraries_Open_STMPLC_IO/3D_Models/10144517-042802LF.STEP
Hardware/Running_Hardware/Open_STMPLC_Main_V0.1/Libraries_Open_STMPLC_Main/3D_Models/10144518-041802LF.step
Hardware/Running_Hardware/Open_STMPLC_Main_V0.1/Libraries_Open_STMPLC_Main/3D_Models/10144518-043802LF.STEP
Hardware/Running_Hardware/Open_STMPLC_Main_V0.1/Libraries_Open_STMPLC_Main/3D_Models/HR911105A.STEP
Hardware/Running_Hardware/Open_STMPLC_Main_V0.1/Libraries_Open_STMPLC_Main/3D_Models/HY951180A.stp
