venam123/Open_STMPLC/Hardware/Running_Hardware/Open_STMPLC_IO_V0.1/Open_STMPLC_IO_V0.1.pdf

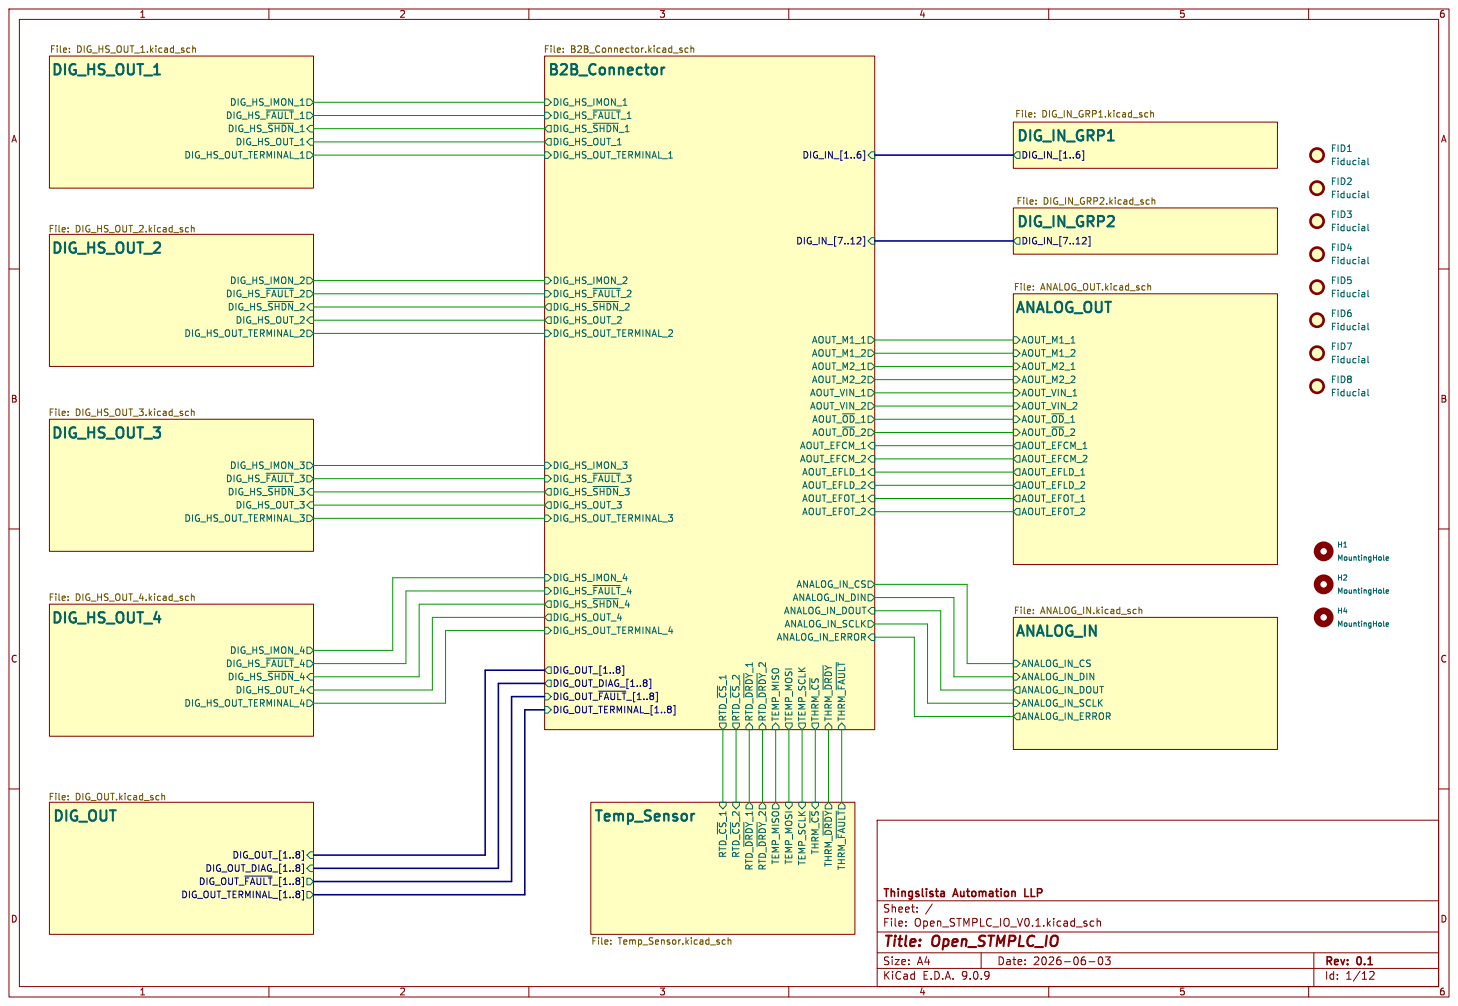
[picture p20: page 1]

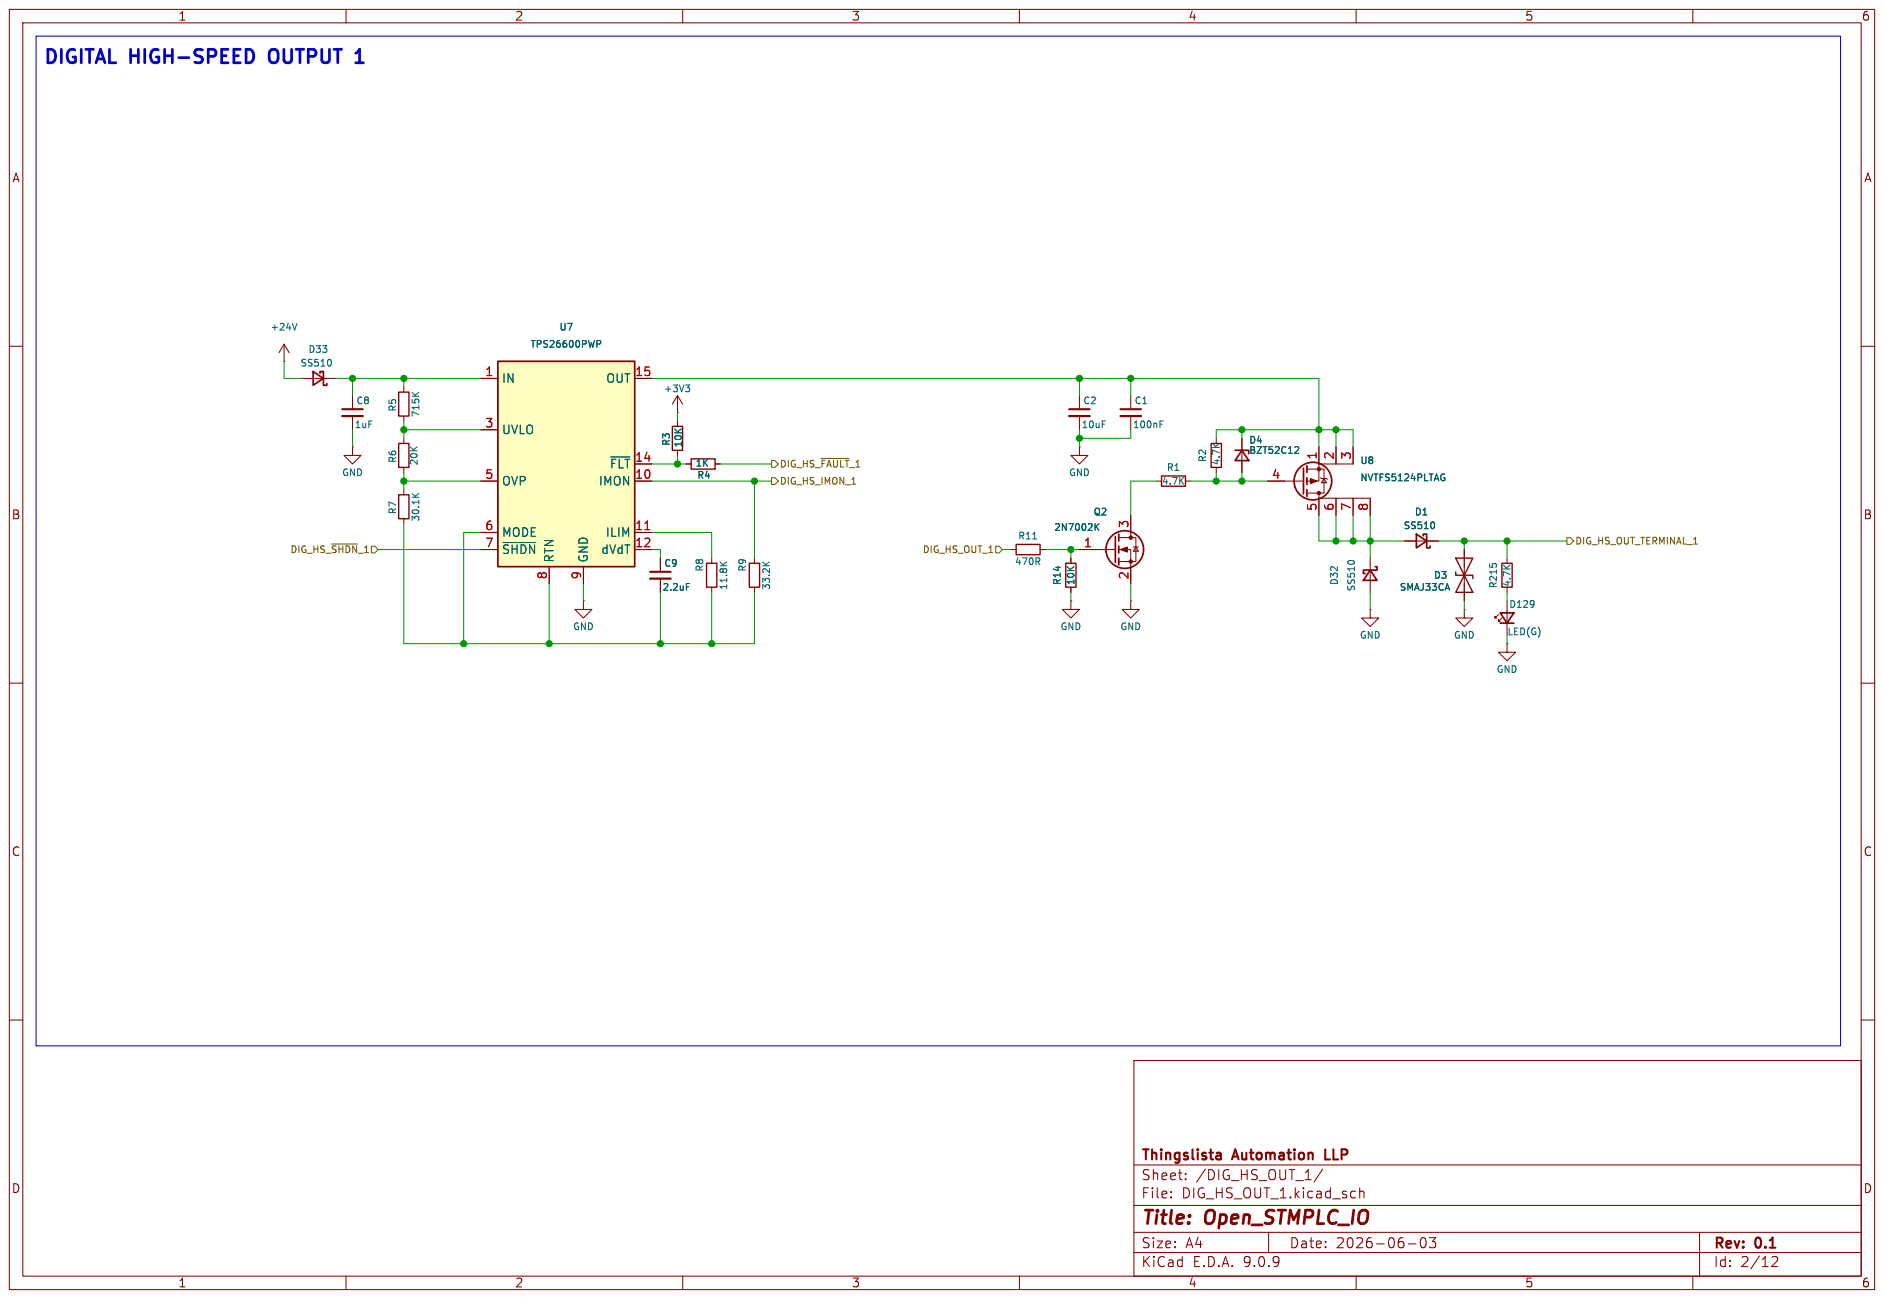
[picture p21: page 2]

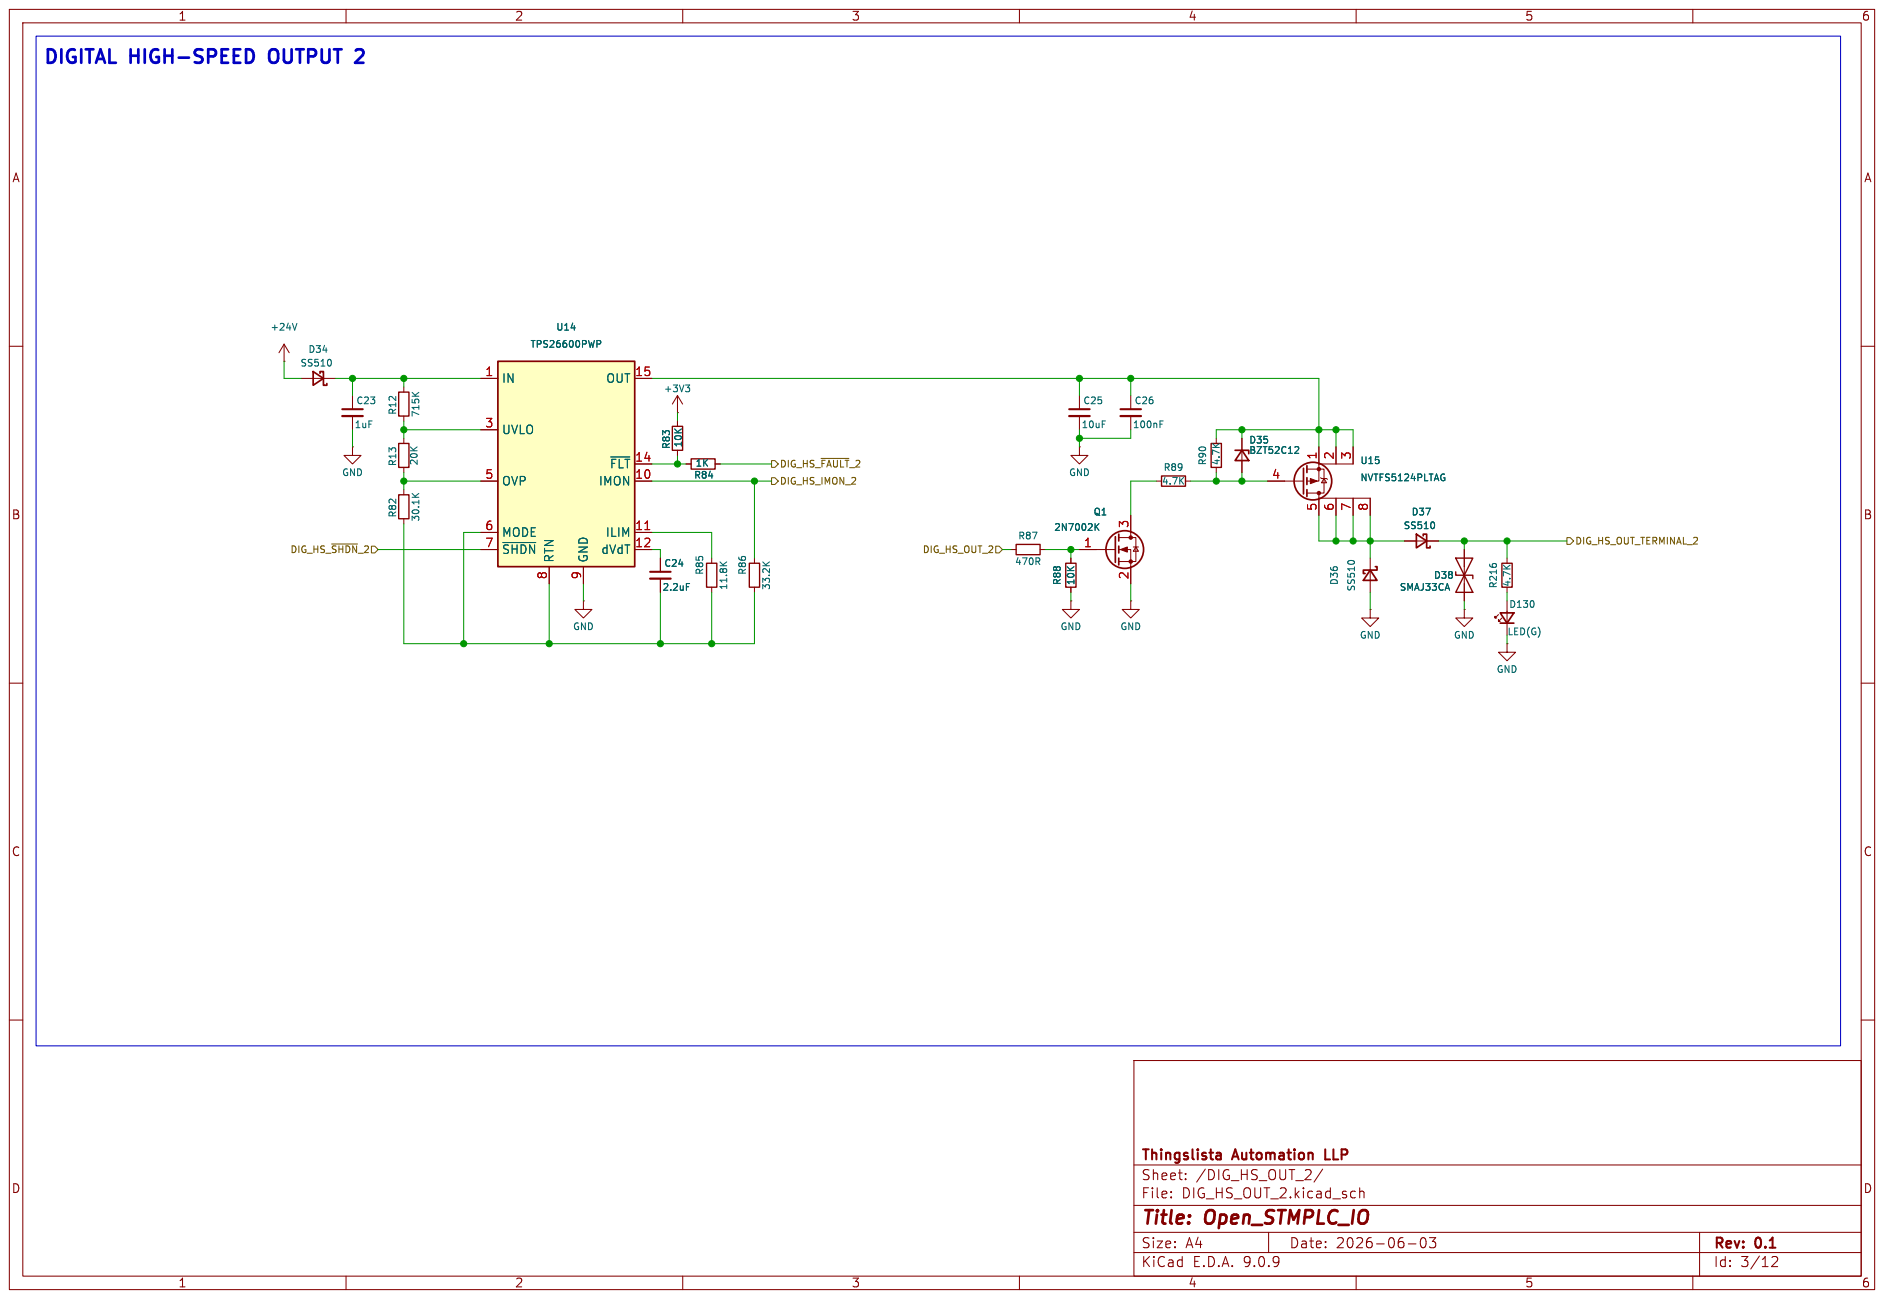
[picture p22: page 3]

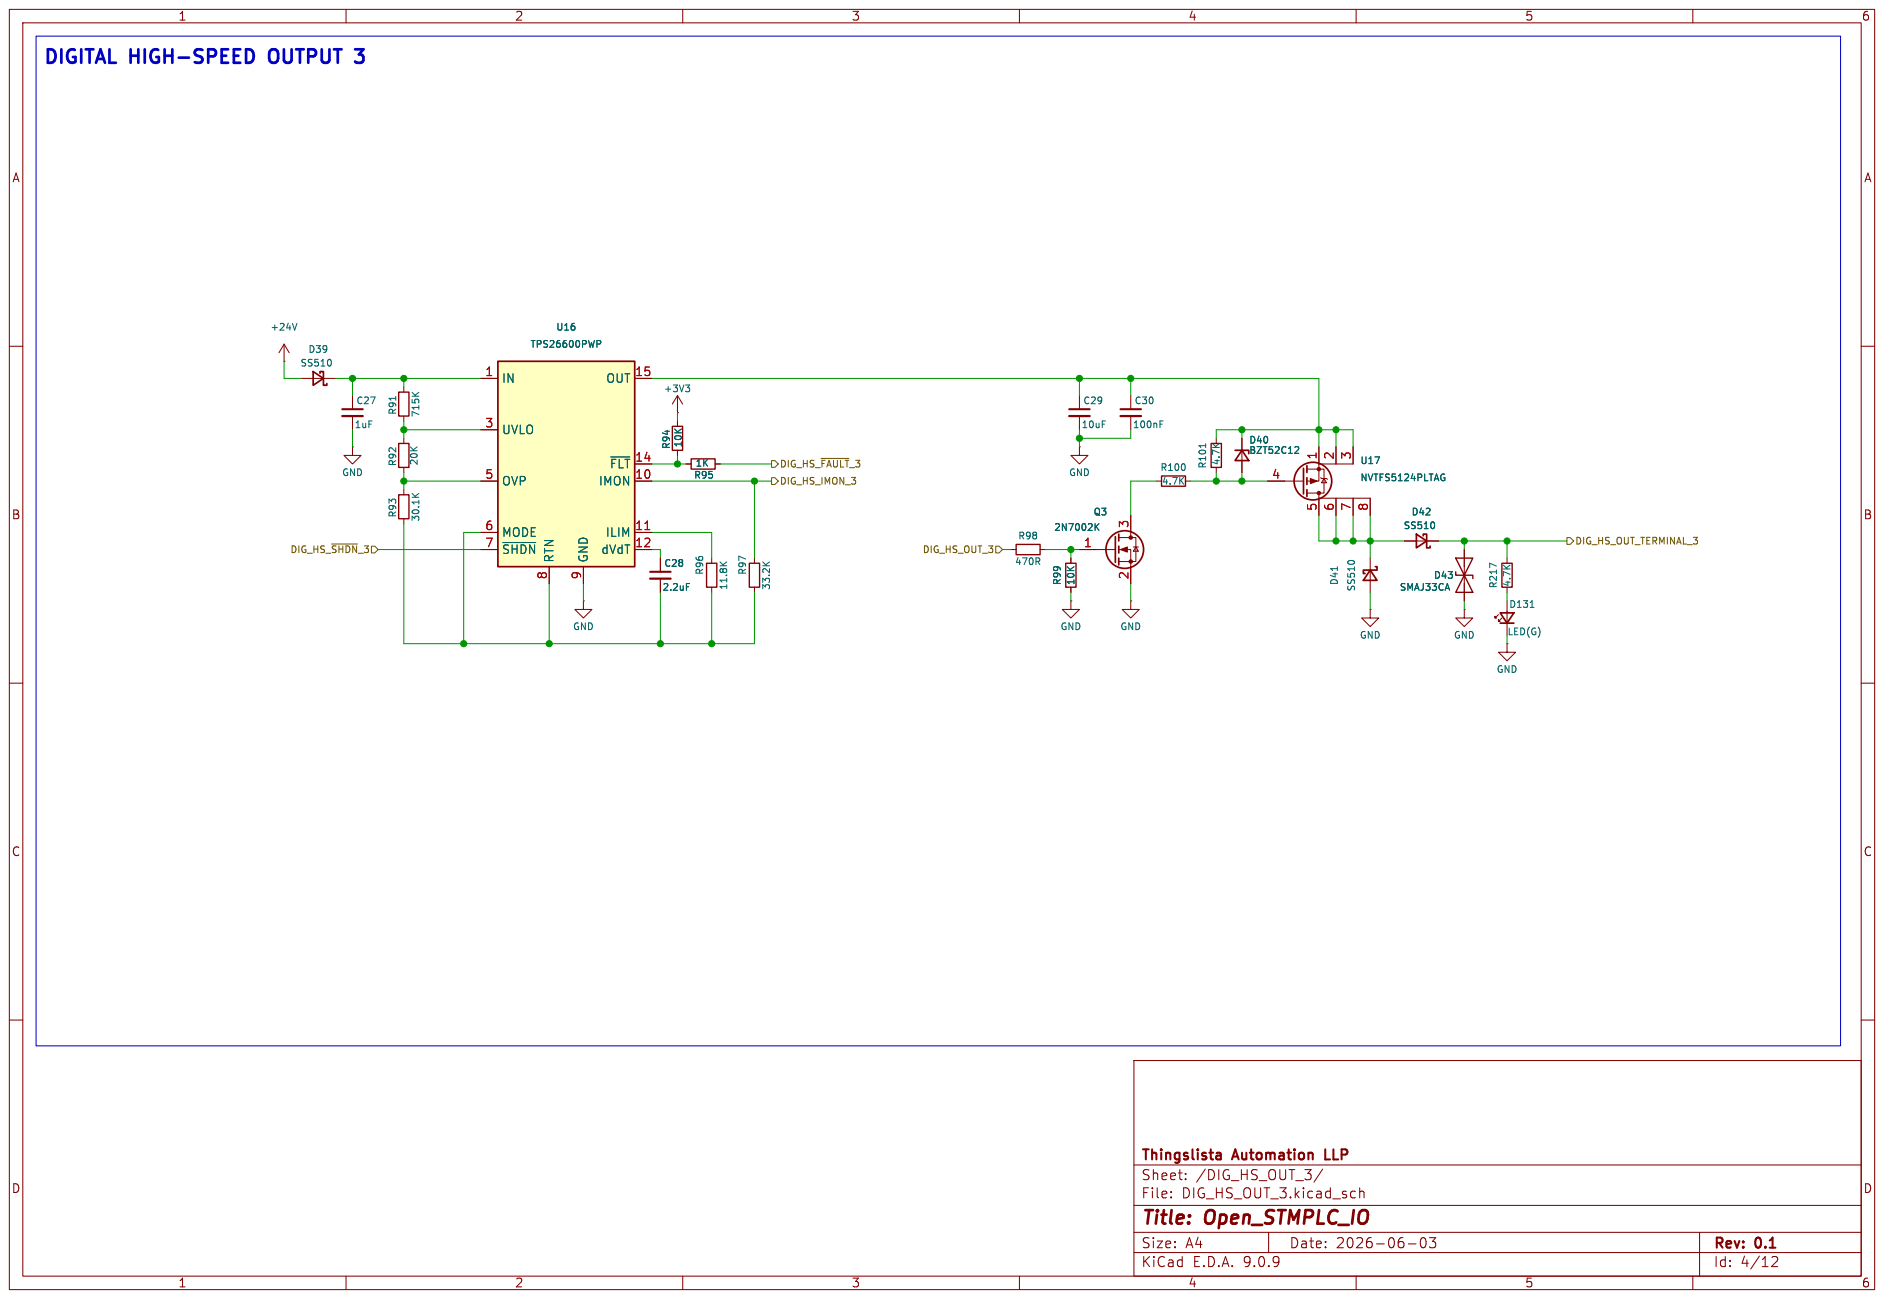
[picture p23: page 4]

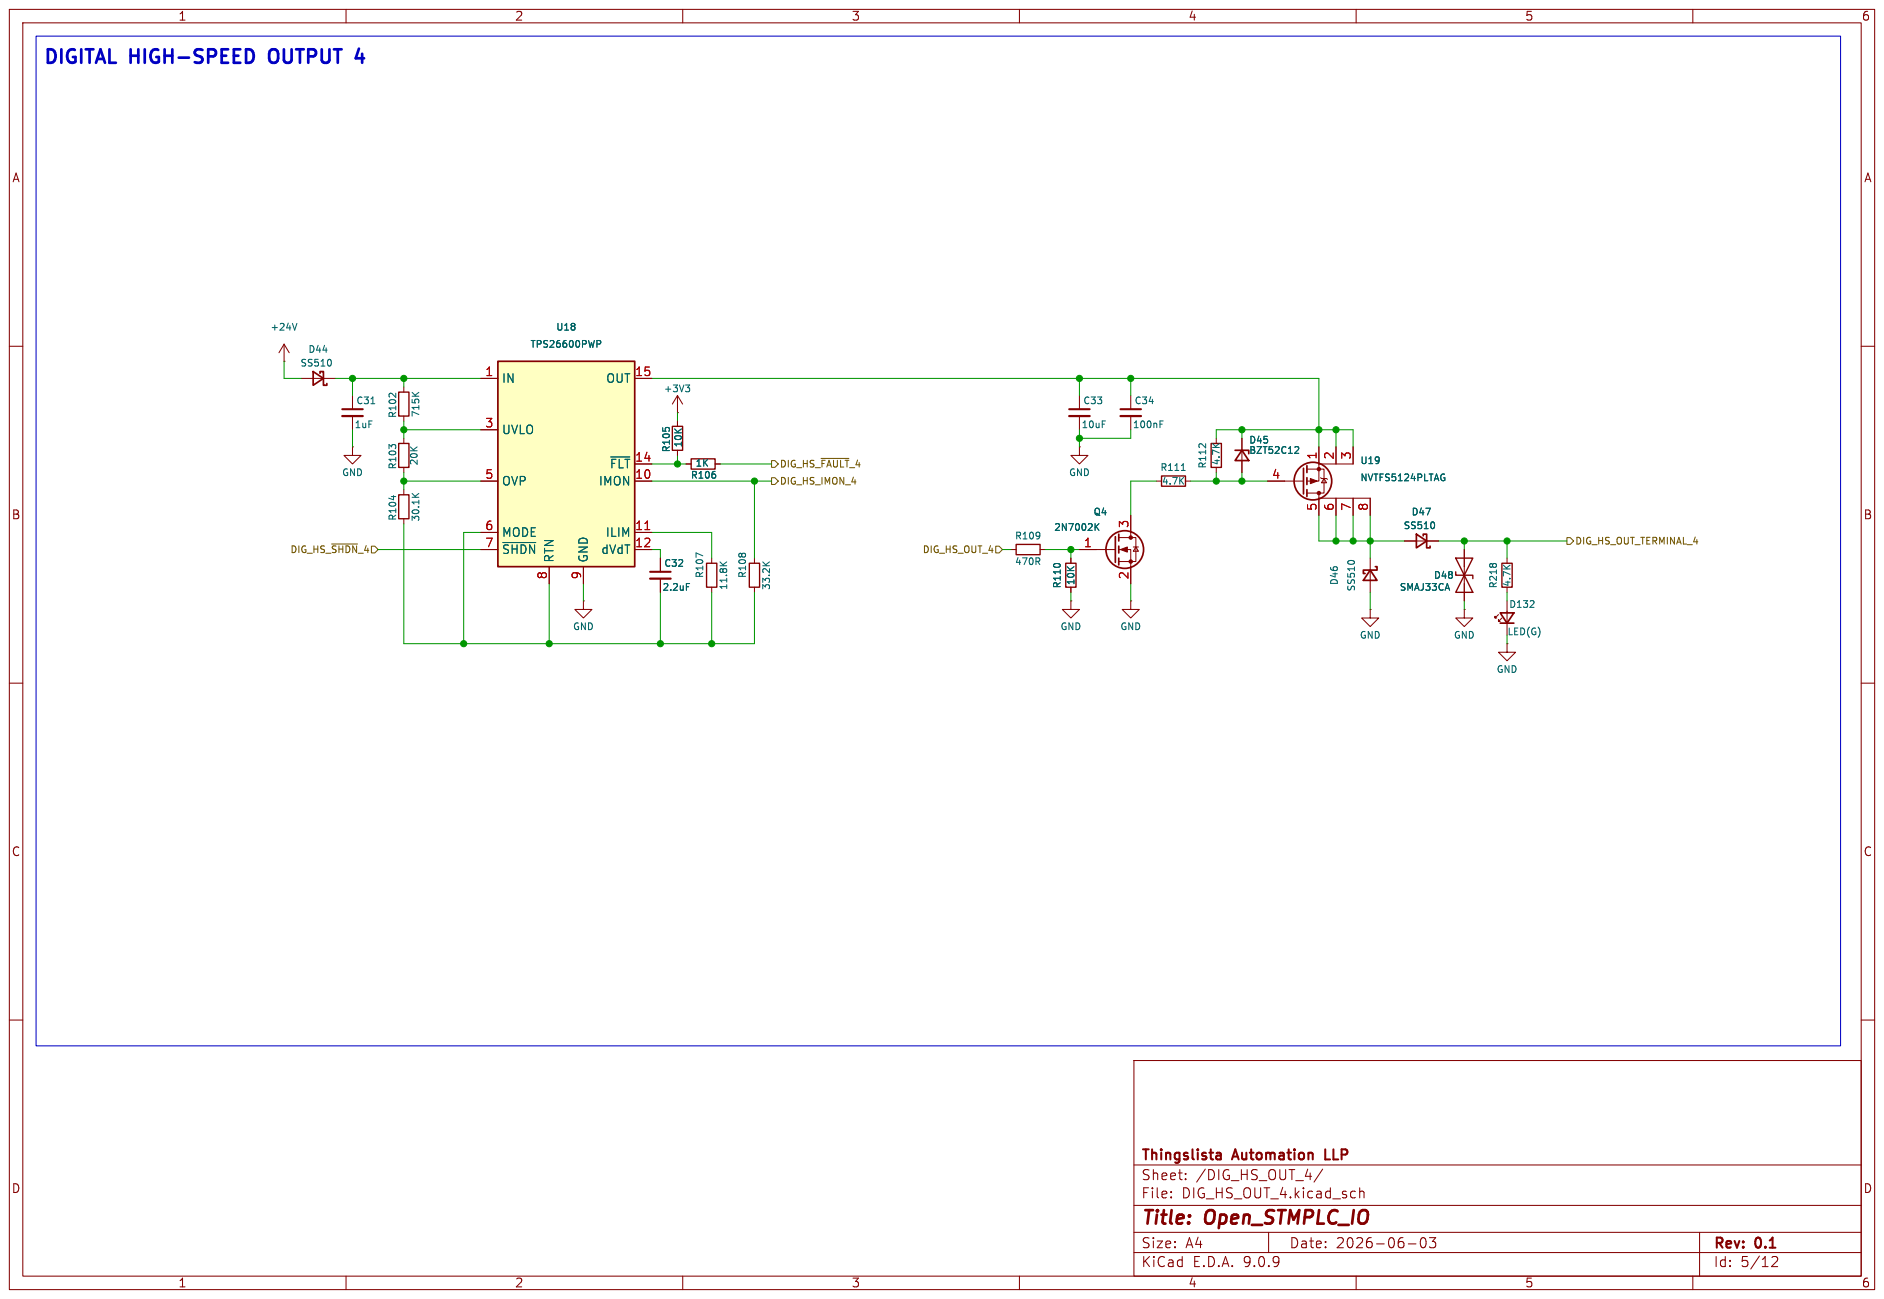
[picture p24: page 5]

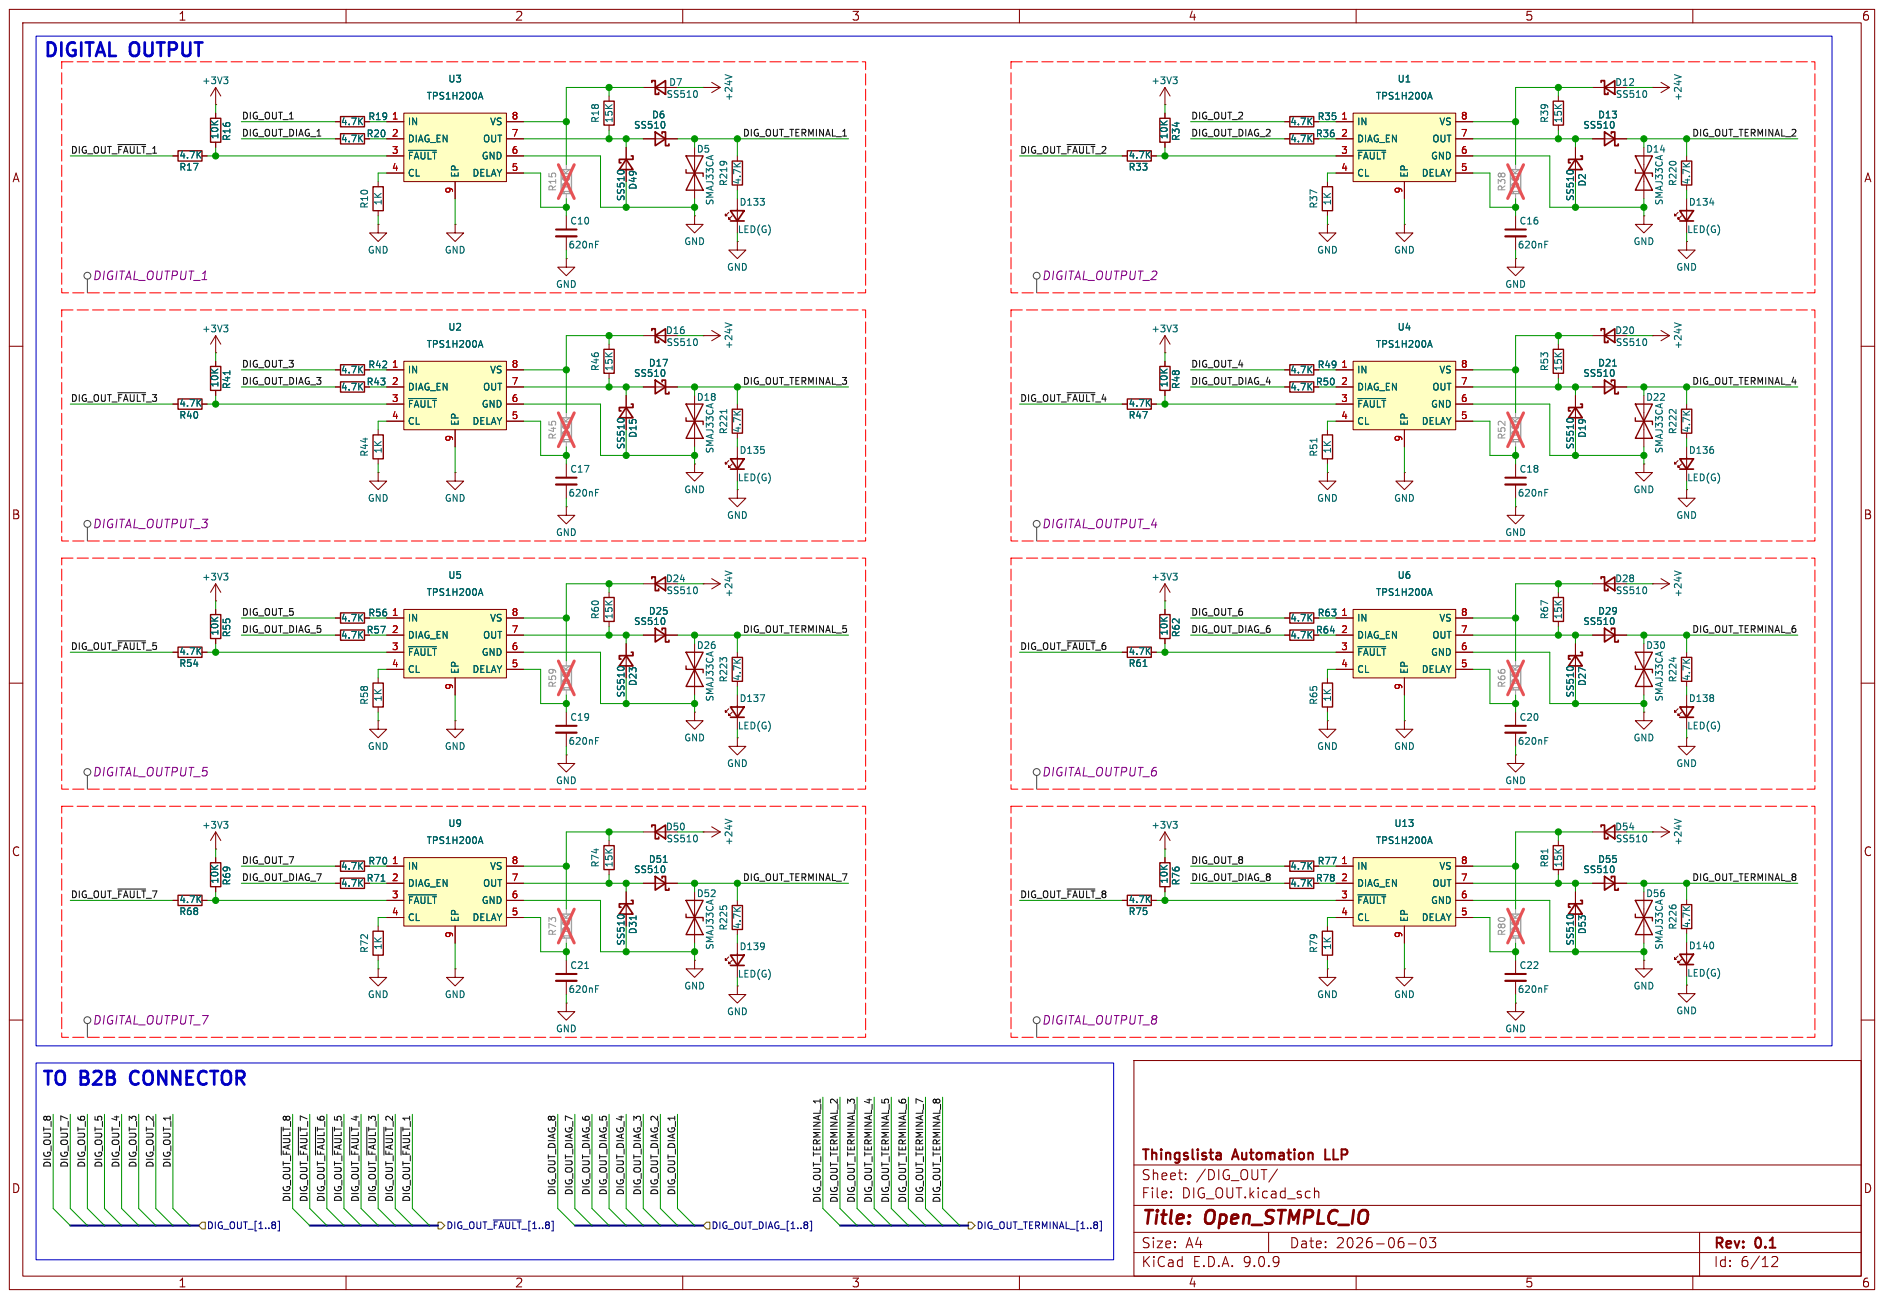
[picture p25: page 6]

9 VS 8 OUT 7 GND 6 DELAY 5 U3 TPS1H200A

9 VS 8 OUT 7 GND 6 DELAY 5 U1 TPS1H200A 10K R34 +3V3 +3V3 +24V D13 SS510 D12 SS510 R47

9 VS 8 OUT 7 GND 6 DELAY 5 10K R16 D25 SS510 D23 SS510 R68

9 VS 8 OUT 7 GND 6 DELAY 5 10K R34 D13 SS510 R47

9 VS 8 OUT 7 GND 6 DELAY 5 R50 4.7K R33

9 VS 8 OUT 7 GND 6 DELAY 5 U2 TPS1H200A GND

9 VS 8 OUT 7 GND 6 DELAY 5 D51 SS510 D31 SS510 U2 TPS1H200A

9 VS 8 OUT 7 GND 6 DELAY 5 U4 TPS1H200A R51 1K R50 4.7K GND GND

9 VS 8 OUT 7 GND 6 DELAY 5 D15 SS510 D53 SS510 10K R62 R61

9 VS 8 OUT 7 GND 6 DELAY 5 U13 TPS1H200A R77 4.7K R79 1K GND DIGITAL_OUTPUT_3 DIGITAL_OUTPUT_7

9 VS 8 OUT 7 GND 6 DELAY 5 U5 TPS1H200A

9 VS 8 OUT 7 GND 6 DELAY 5 U6 TPS1H200A +24V D55 SS510 GND

9 VS 8 OUT 7 GND 6 DELAY 5 10K R69 R71 4.7K R70 4.7K R54

9 VS 8 OUT 7 GND 6 DELAY 5 R64 4.7K R63 4.7K U13 TPS1H200A

9 VS 8 OUT 7 GND 6 DELAY 5 U9 TPS1H200A D139

9 VS 8 OUT 7 GND 6 DELAY 5 R77 4.7K R78 4.7K

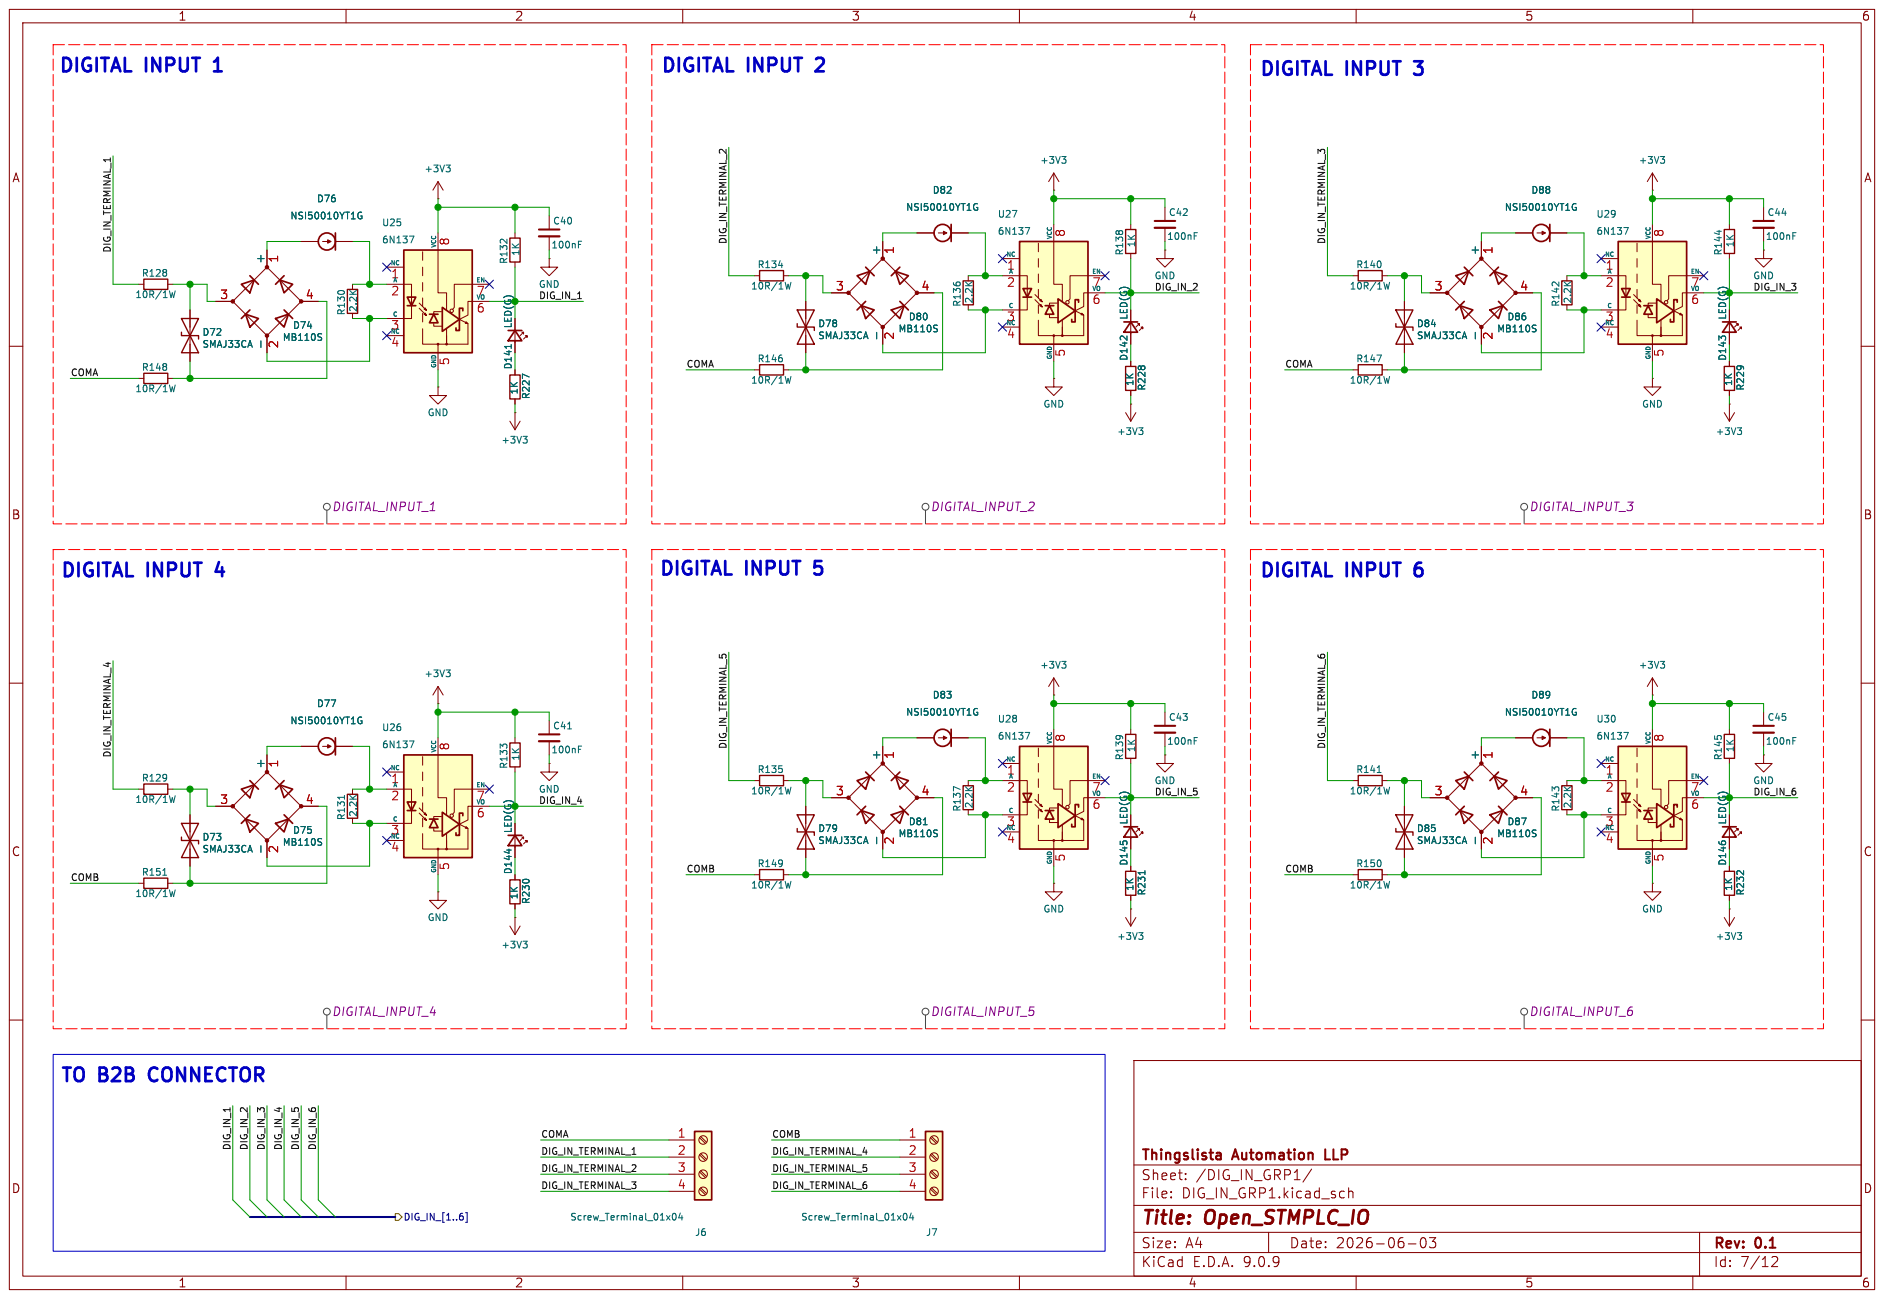
[picture p26: page 7]

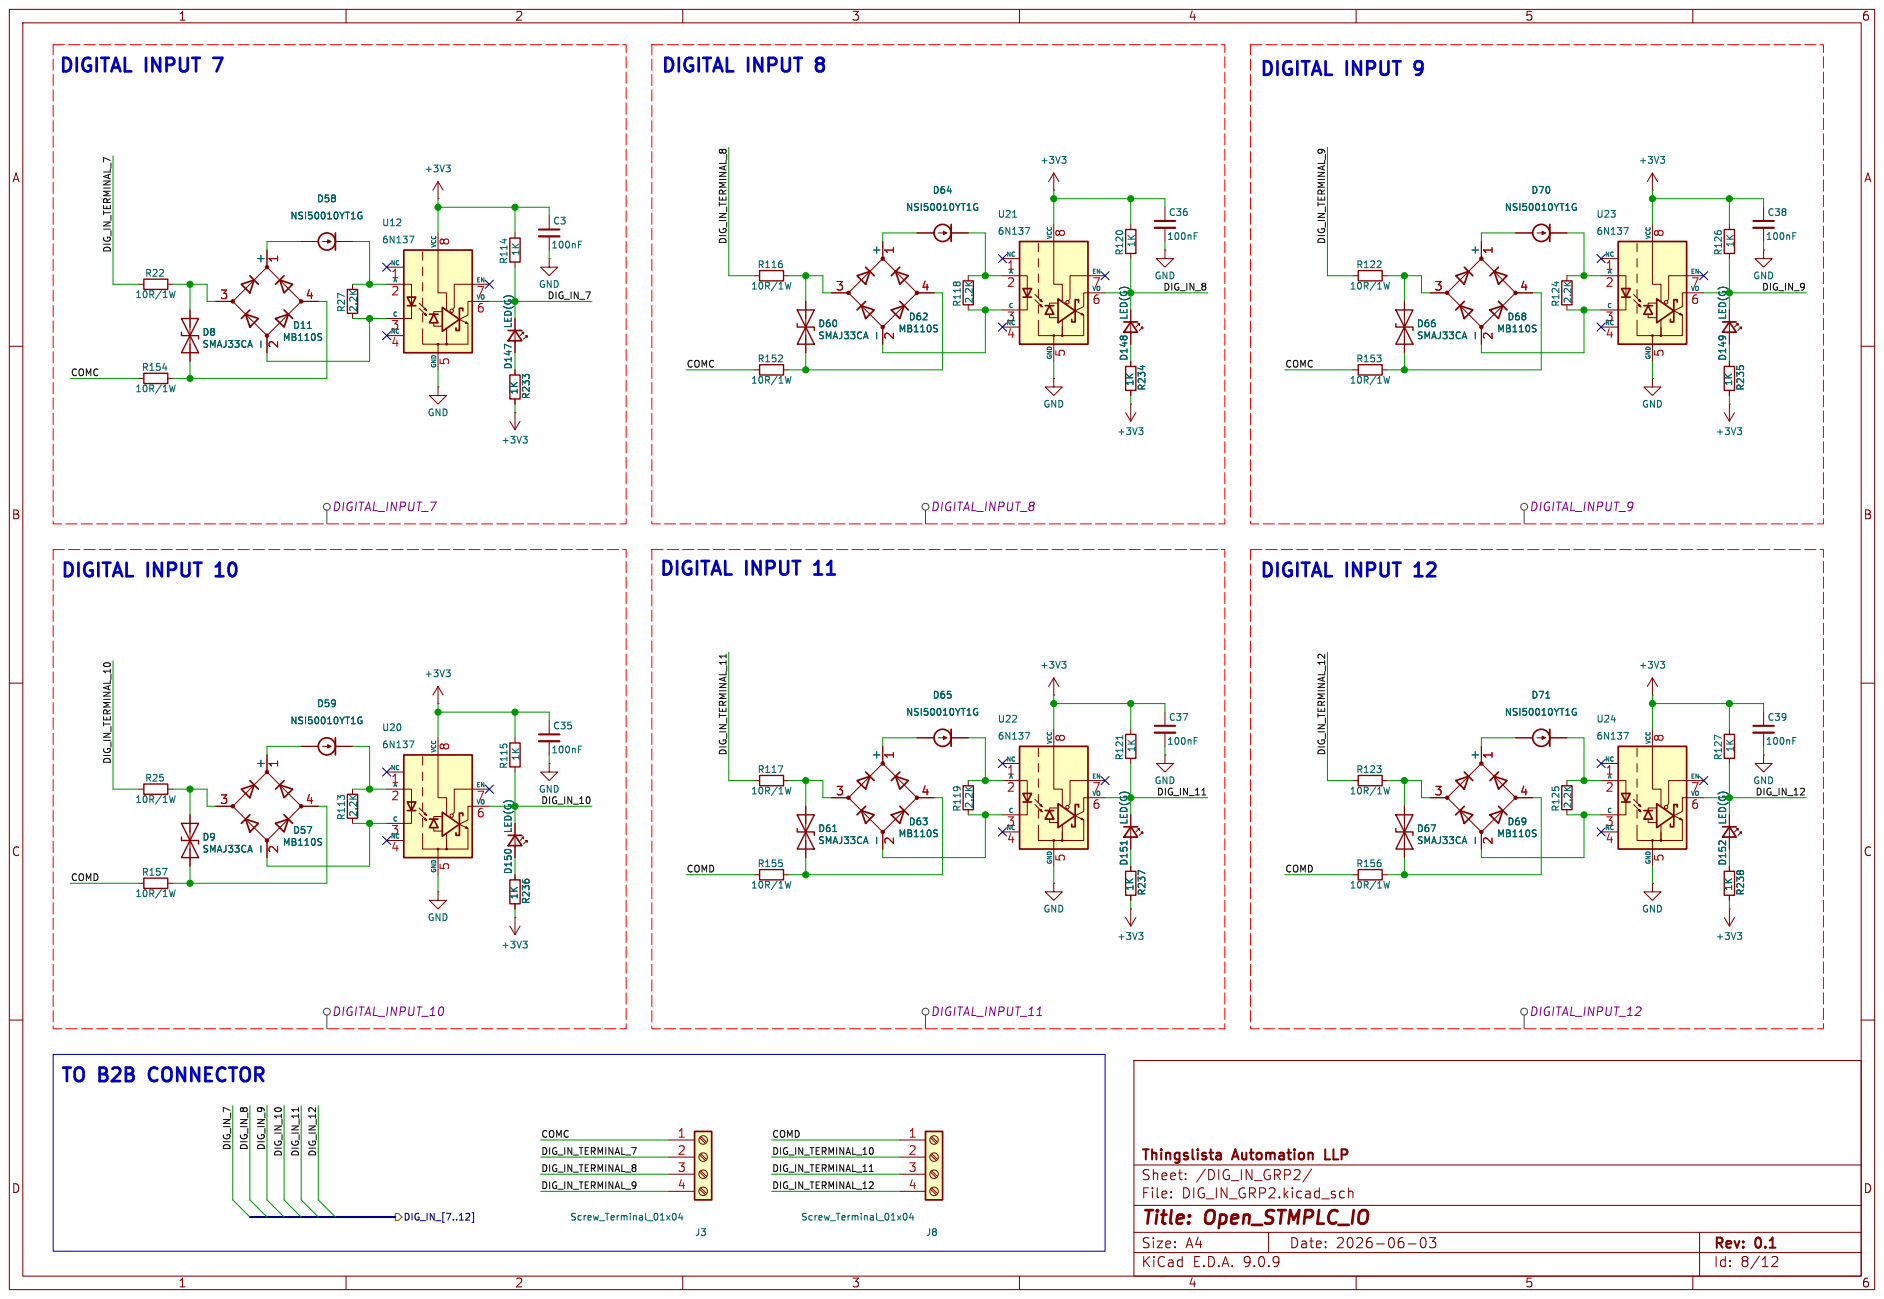
[picture p27: page 8]

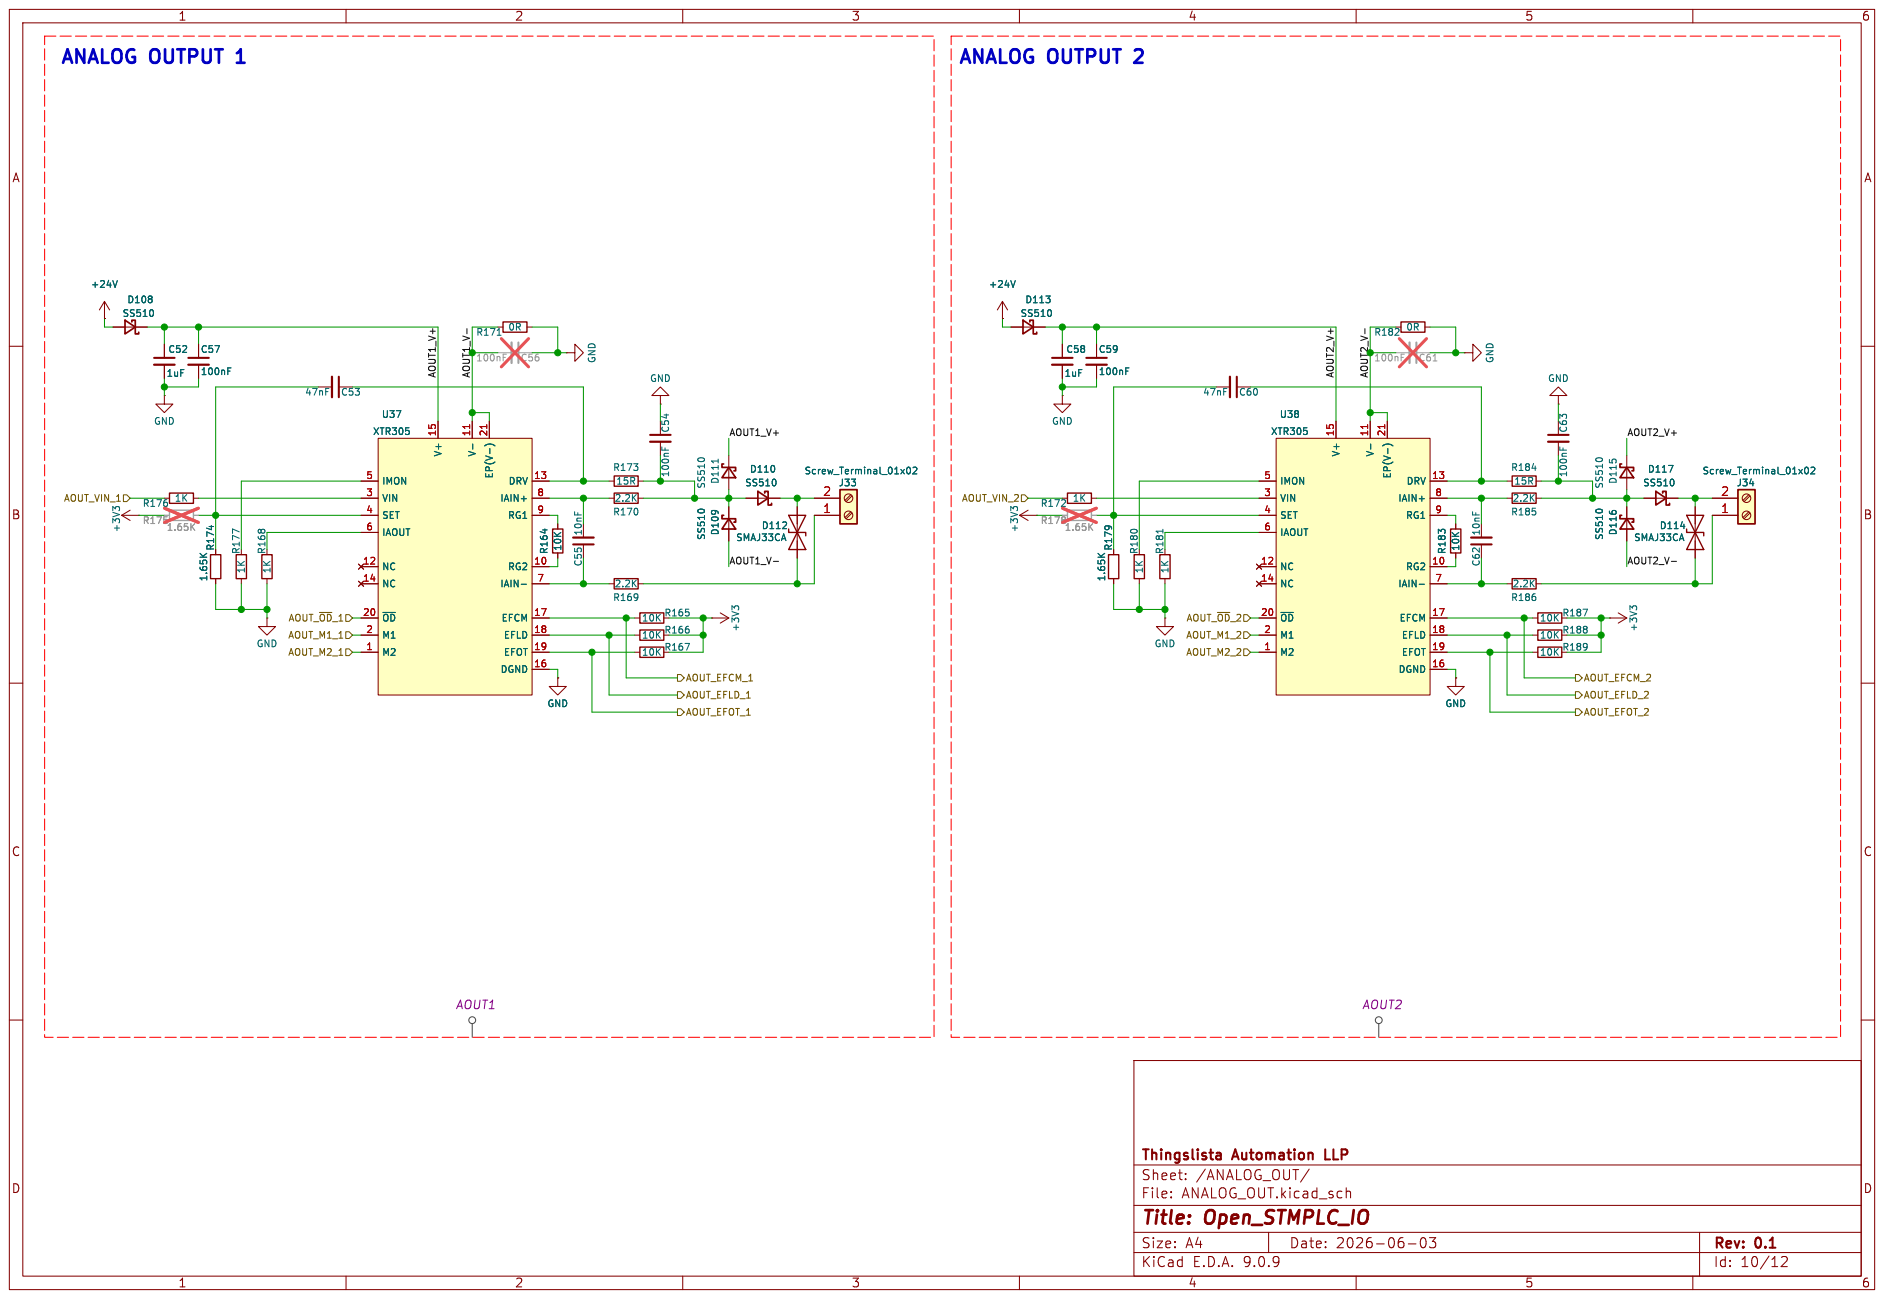
[picture p28: page 9]

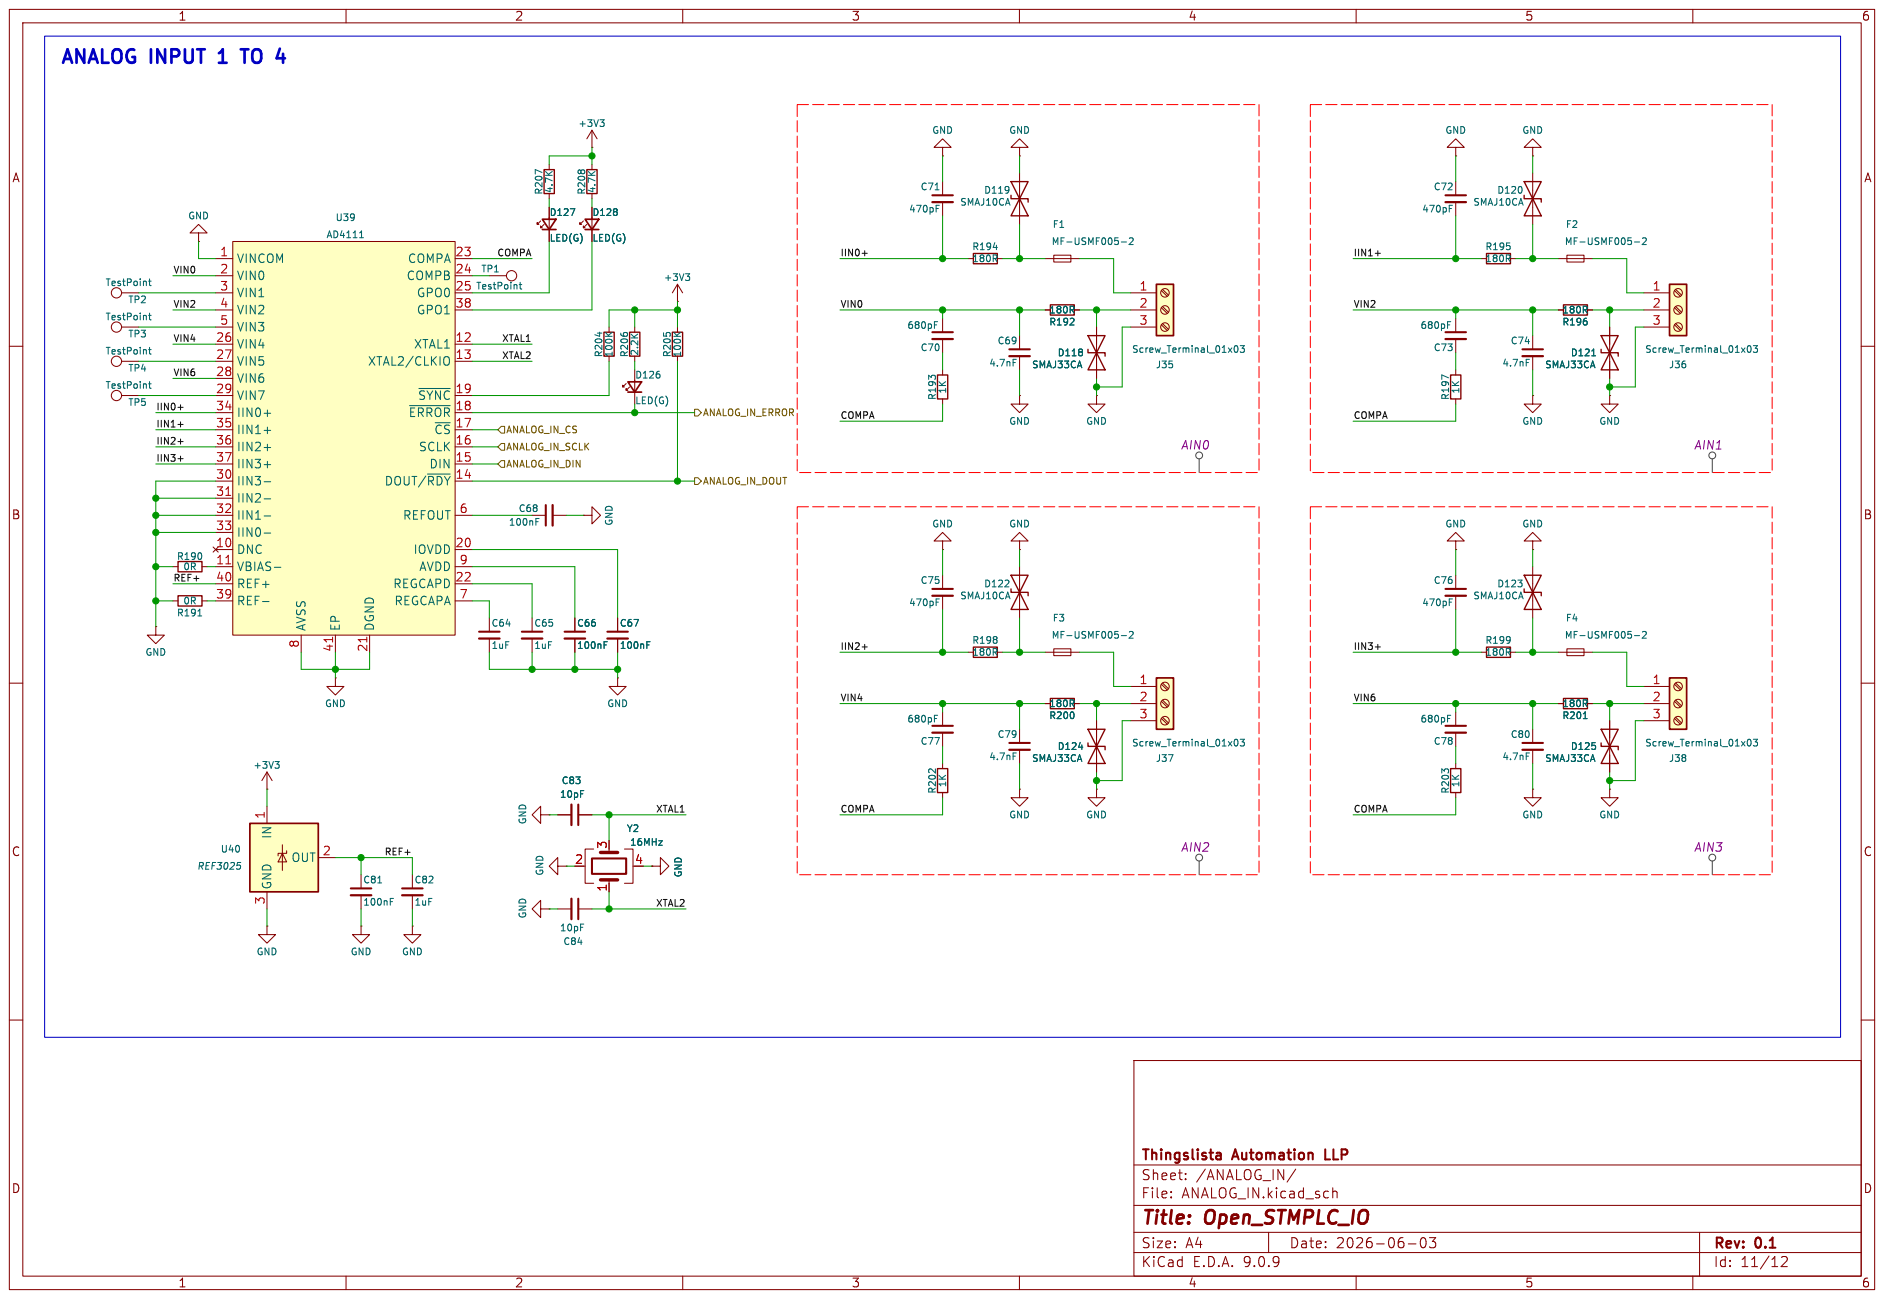
[picture p29: page 10]

8 EP 41 DGND 21 COMPA 23 COMPB 24 GPO0 25 GPO1 38 XTAL1 12 XTAL2/CLKIO 13 ~{SYNC} 19 ~{ERROR} 18 ~{CS} 17 SCLK 16 DIN 15 DOUT/~{RDY}14 REFOUT 6

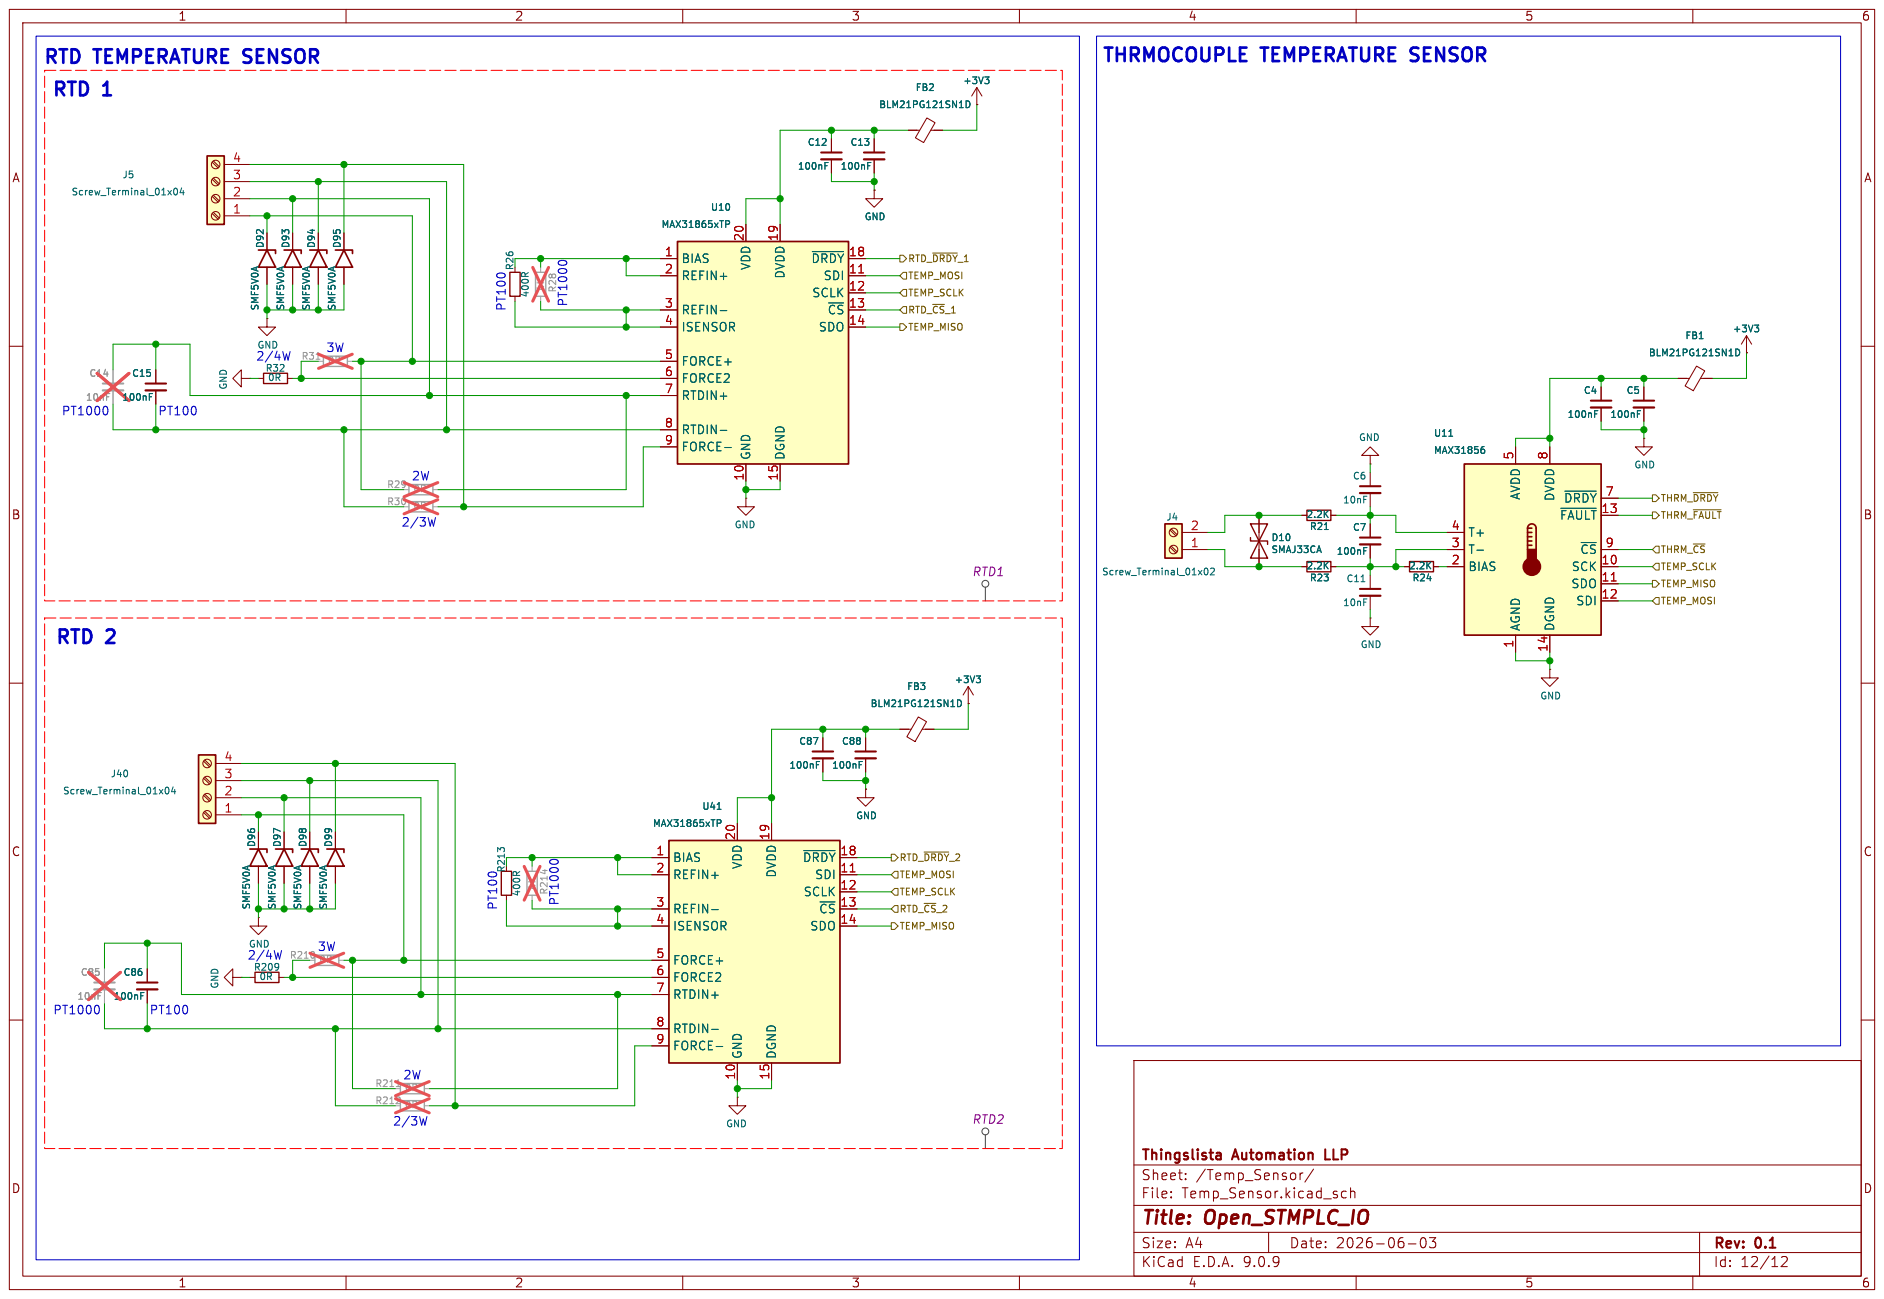
[picture p30: page 11]

~{DRDY}7 ~{FAULT} 13 ~{CS}9 SCK 10 SDO 11 SDI 12 U11 MAX31856 D99 SMF5V0A

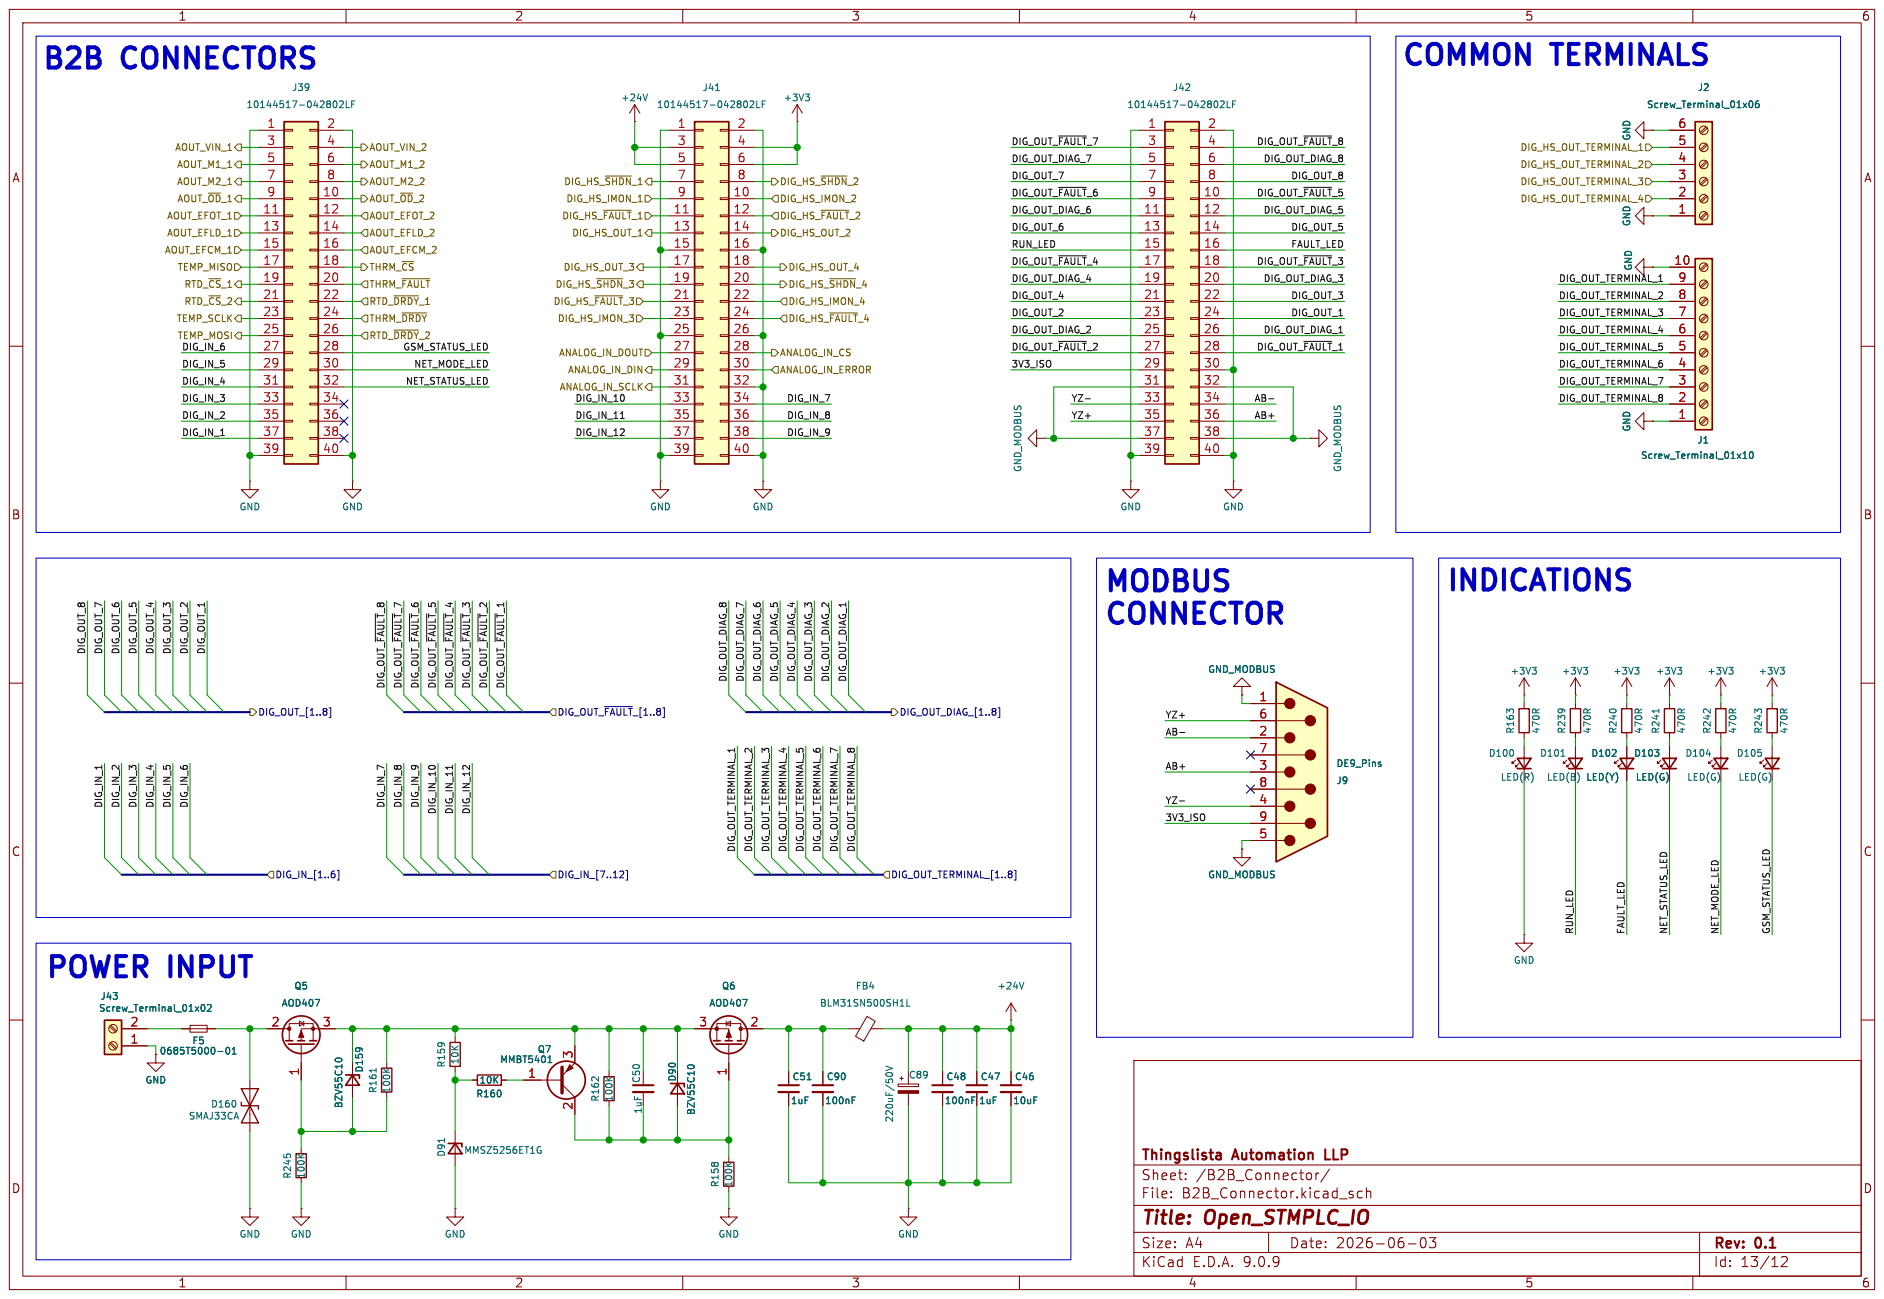
[picture p31: page 12]

DIG_HS_~{FAULT}_3 DIG_HS_~{SHDN}_3 DIG_HS_~{SHDN}_1 DIG_OUT_~{FAULT}_[1..8]
