venam123/Open_STMPLC/Document/ATM90E3x_V1.05/Hardware/ATM90E3x-DB V1.0/PDF.pdf

# dpdp fg

# dpdp fg

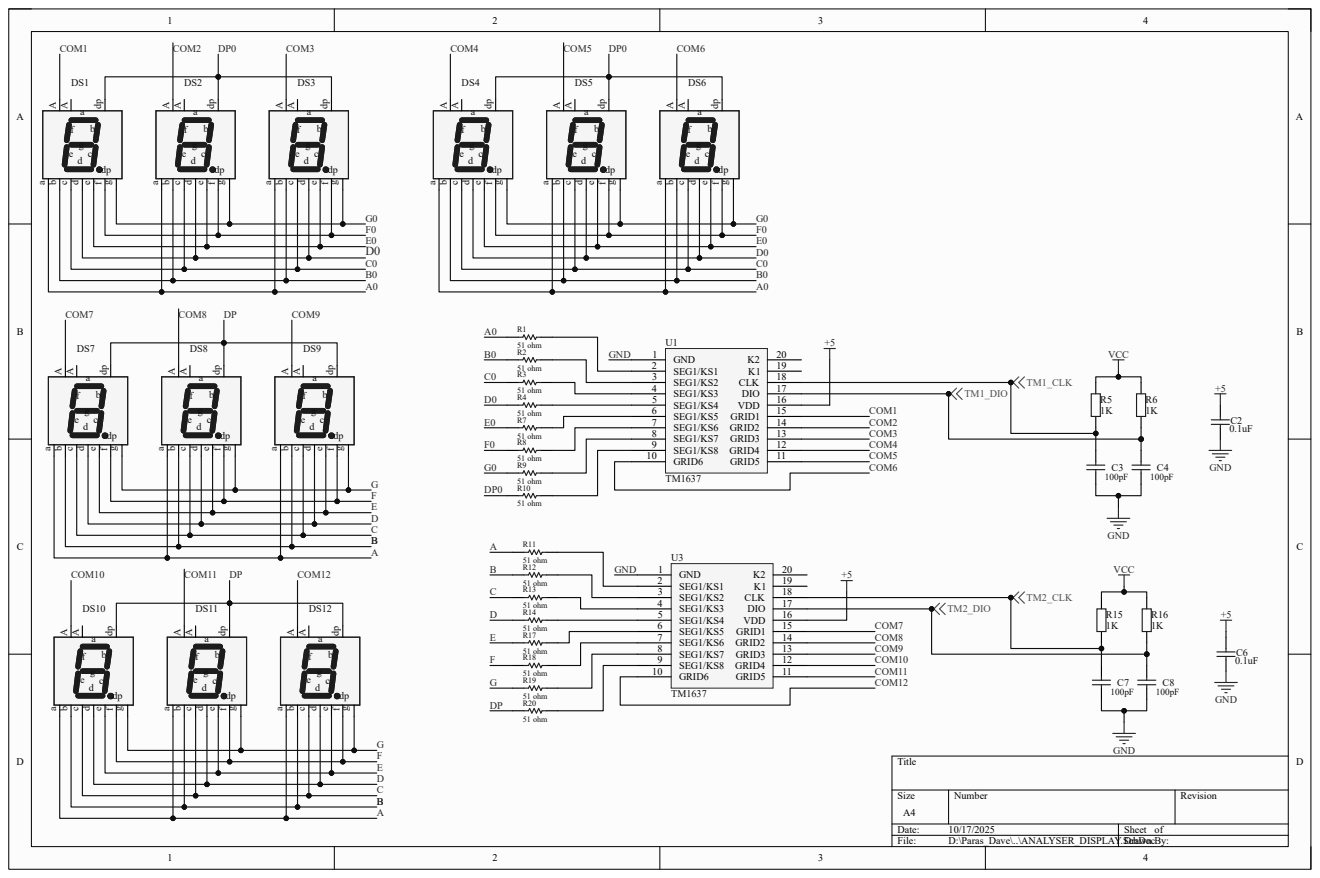
[picture p32: page 1]

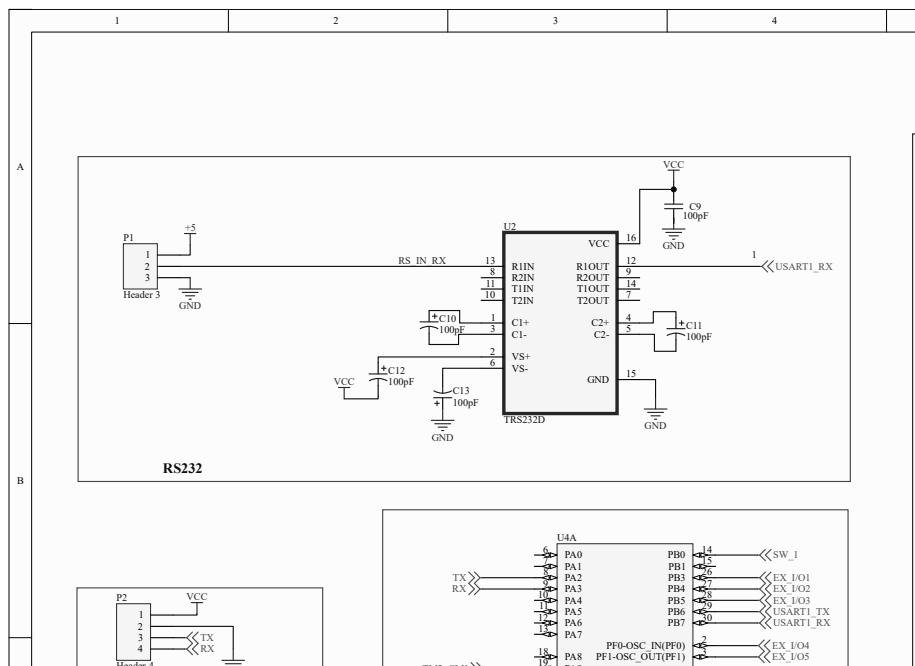
[picture p33: page 2]

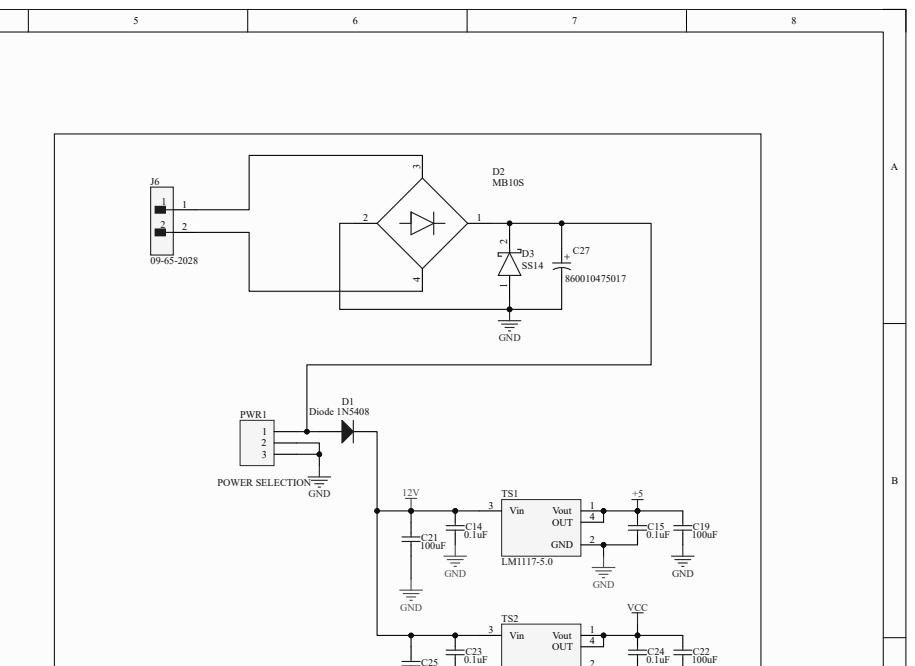
[picture p34: page 3]

## UART CONNECTOR

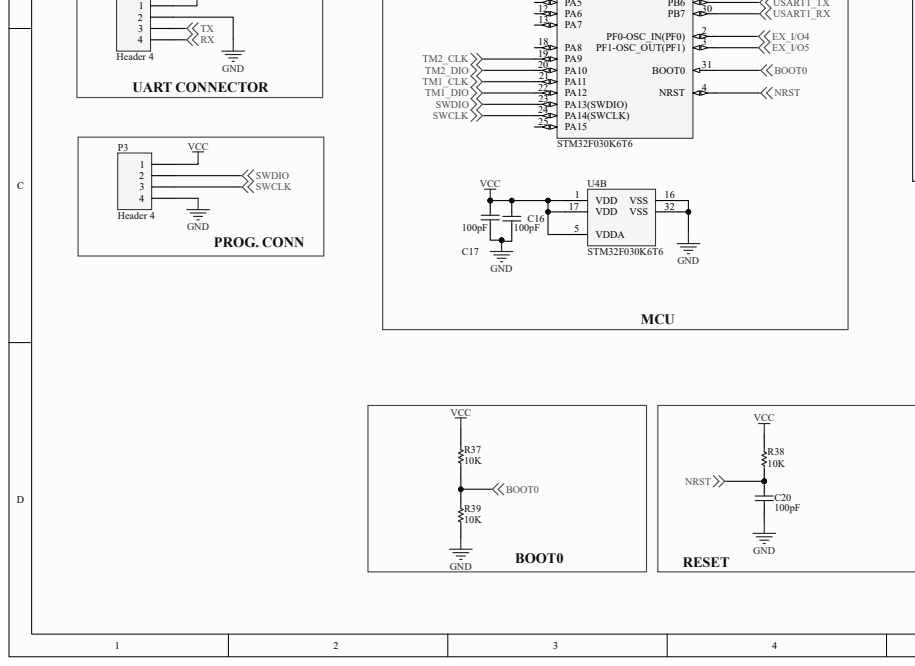
[picture p35: page 4]

## Power Supply

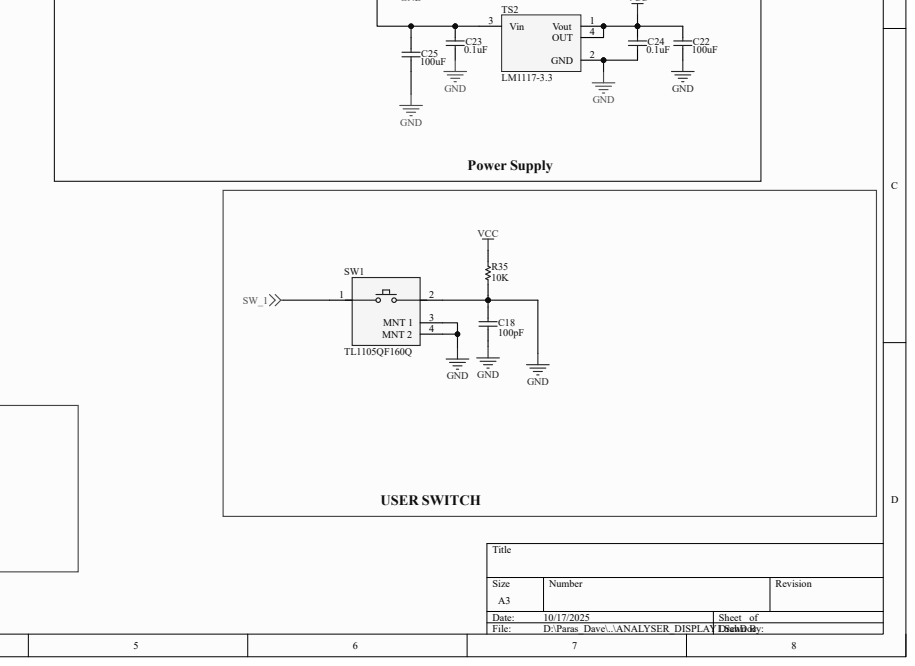
[picture p36: page 5]
Title; Size; Number; Revision; Date:; Sheet of; File:; D:\Paras_Dave\..\ANALYSER_DISPLAY1.SchDoc Drawn By:; MNT 1; MNT 2; GND; VCC; USER SWITCH; Vin 3; Vout; OUT
