venam123/Open_STMPLC/Hardware/Running_Hardware/Open_STMPLC_EnergyMon_V0..1/Open_STMPLC_EnergyMon_V0..1.pdf

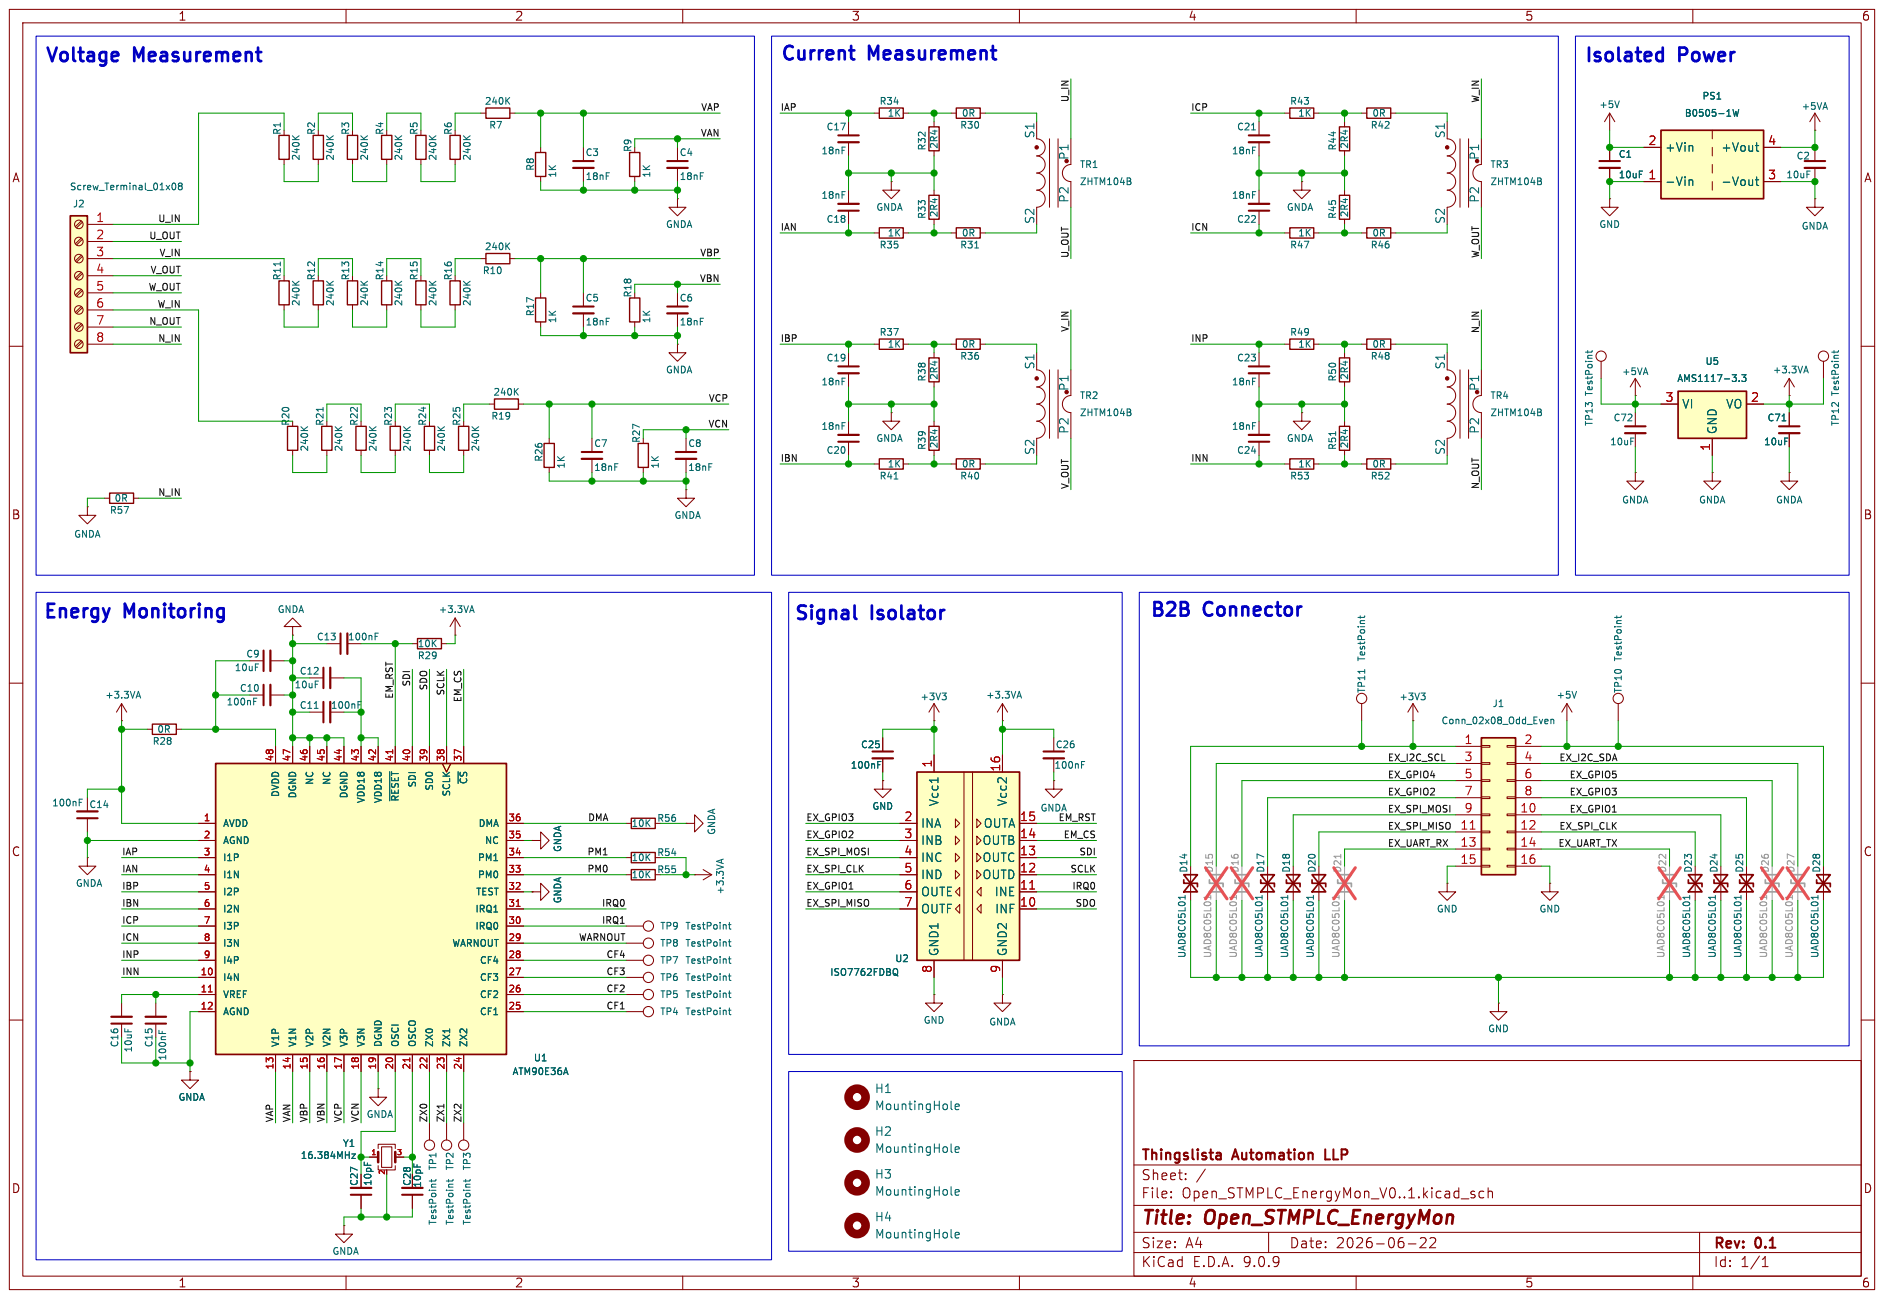
[picture p37: page 1]

9 OUTA 15 OUTB 14 OUTC 13 OUTD 12
