venam123/Open_STMPLC/Hardware/Running_Hardware/Open_STMPLC_Main_V0.1/Open_STMPLC_Main_V0.1.pdf

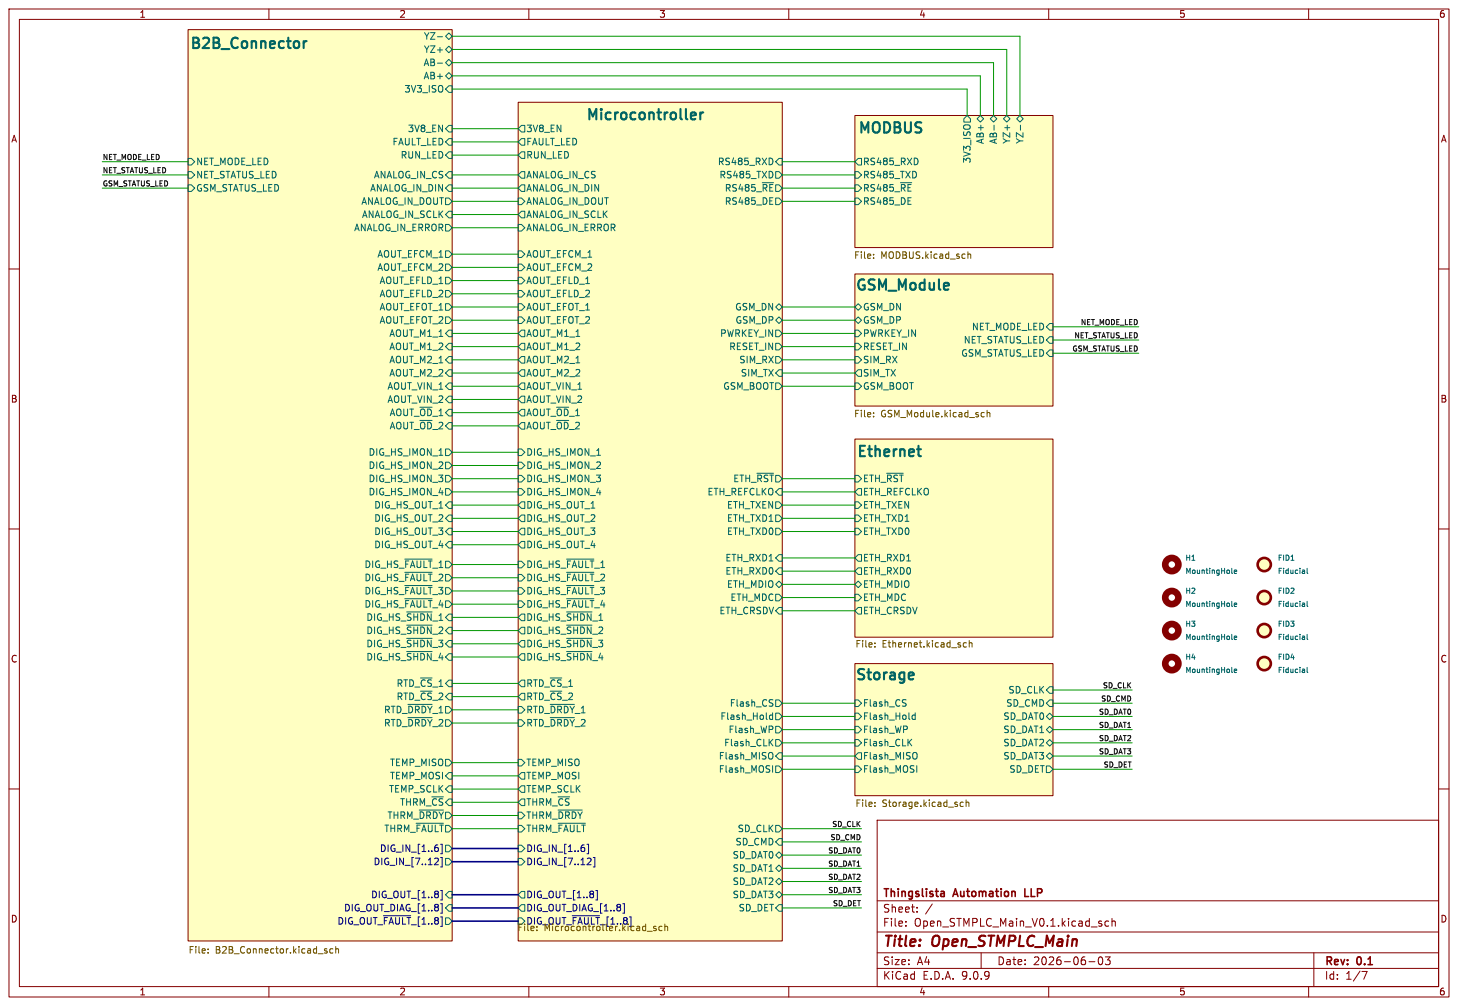
[picture p38: page 1]

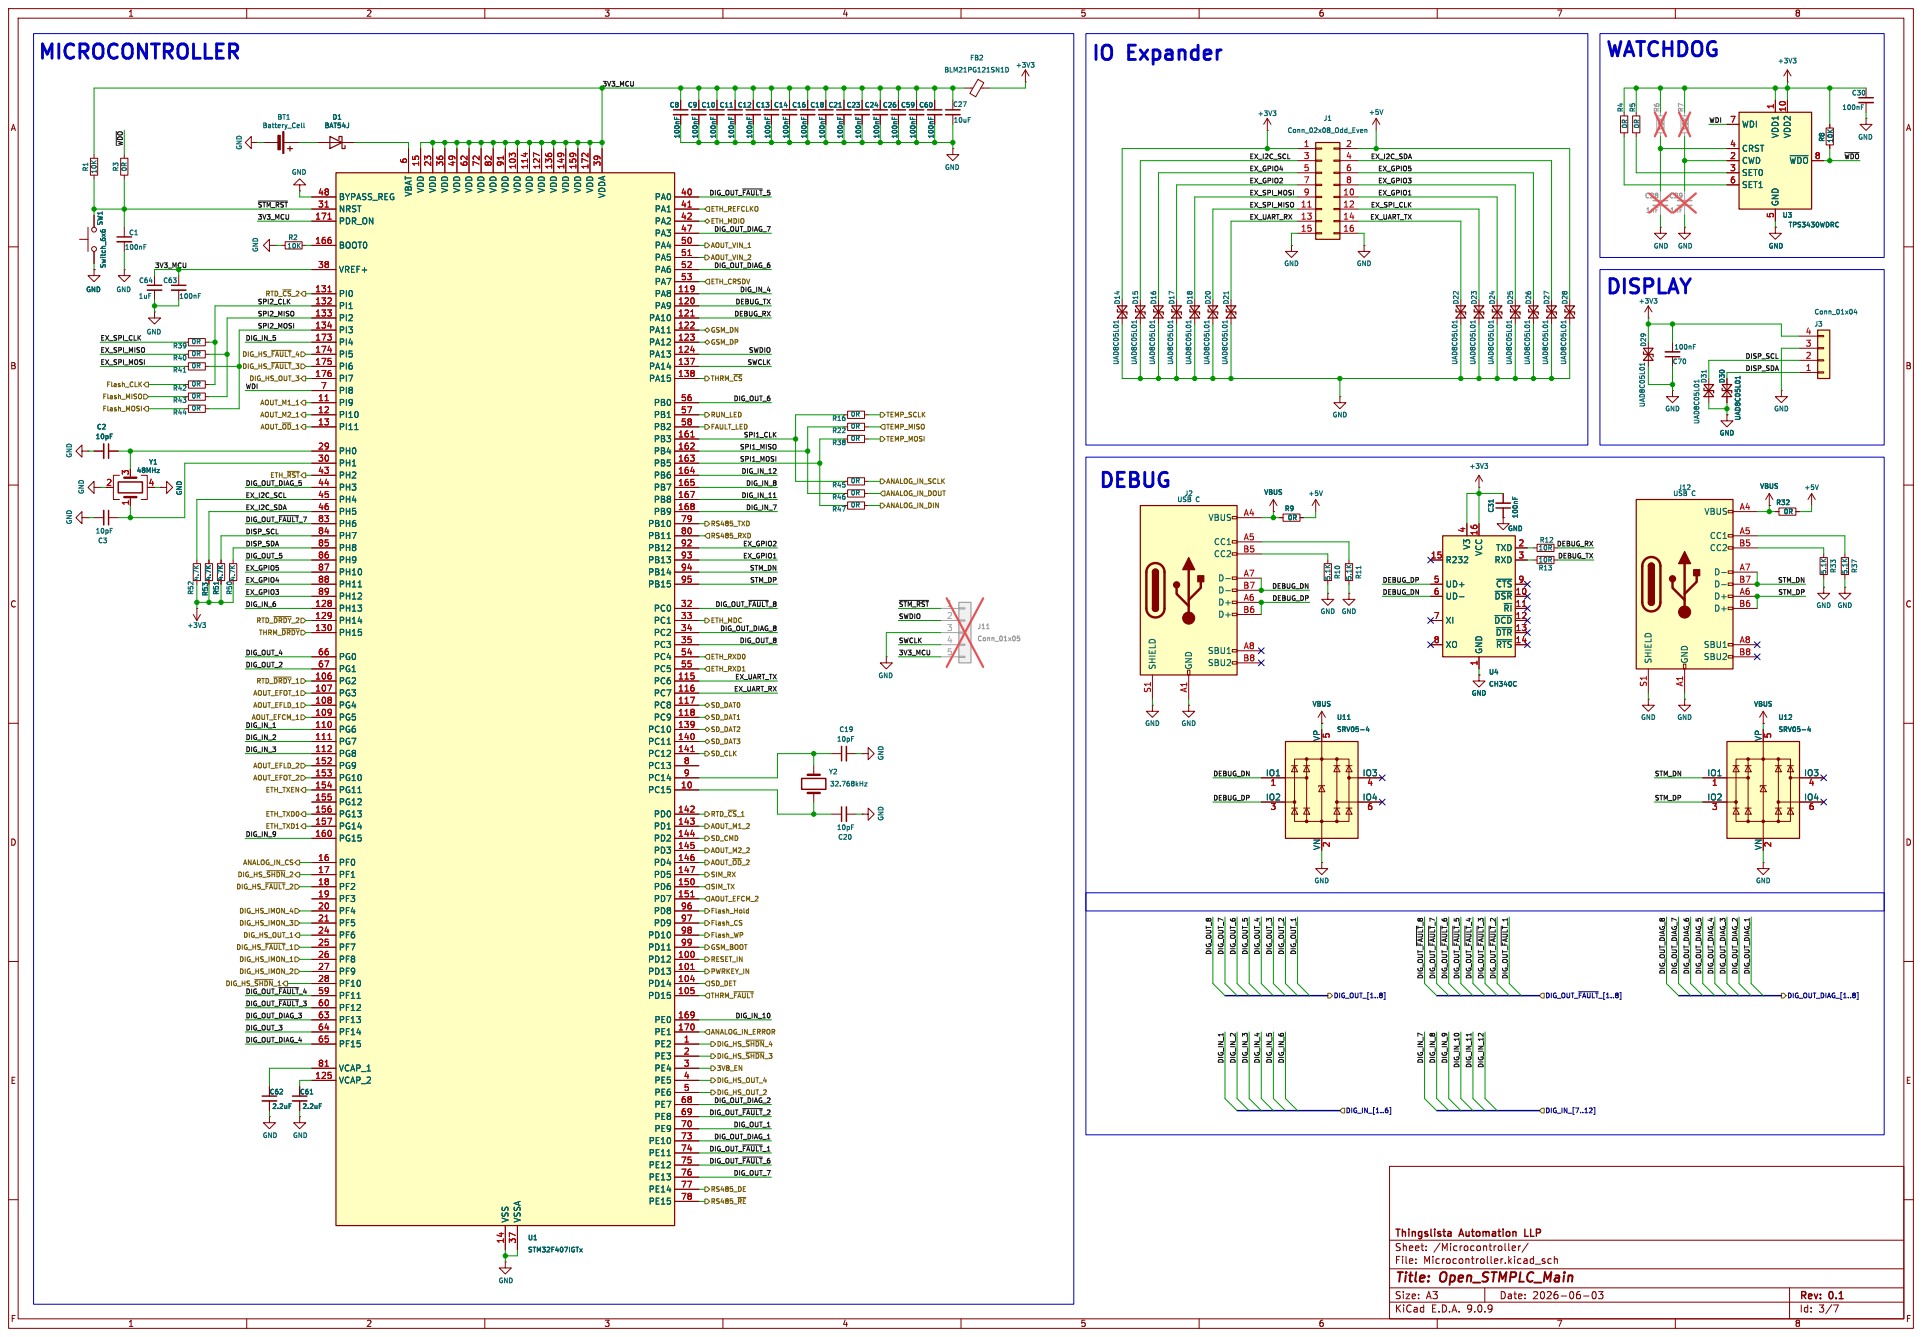
[picture p39: page 2]

6 VDD 15 VDD 23 VDD 36 VDD 49 VDD 62 VDD 72 VDD 82 VDD 91 VSS 14 VDD 103 VSSA 37 VDD 114 VDD 127 VDD 136 VDD 149 VDD 159 VDD 172 VDDA 39 PA0 40 PA1 41 PA2 42 PA3 47 PA4 50 PA5 51 PA6 52 PA7 53 PA8 119 PA9 120 PA10 121 PA11 122 PA12 123 PA13 124 PA14 137 PA15 138 PB0 56 PB1 57 PB2 58 PB3 161 PB4 162 PB5 163 PB6 164 PB7 165 PB8 167 PB9 168 PB10 79 PB11 80 PB12 92 PB13 93 PB14 94 PB15 95 PC0 32 PC1 33 PC2 34 PC3 35 PC4 54 PC5 55 PC6 115 PC7 116 PC8 117 PC9 118 PC10 139 PC11 140 PC12 141 PC13 8 PC14 9 PC15 10 PD0 142 PD1 143 PD2 144 PD3 145 PD4 146 PD5 147 PD6 150 PD7 151 PD8 96 PD9 97 PD10 98 PD11 99 PD12 100 PD13 101 PD14 104 PD15 105 PE0 169 PE1 170 PE2 1 PE3 2 PE4 3 PE5 4 PE6 5 PE7 68 PE8 69 PE9 70 PE10 73 PE11 74 PE12 75 PE13 76 PE14 77 PE15 78 C62
GND

6 VDD 15 VDD 23 VDD 36 VDD 49 VDD 62 VDD 72 VDD 82 VDD 91 VSS 14 VDD 103 VSSA 37 VDD 114 VDD 127 VDD 136 VDD 149 VDD 159 VDD 172 VDDA 39 PA0 40 PA1 41 PA2 42 PA3 47 PA4 50 PA5 51 PA6 52 PA7 53 PA8 119 PA9 120 PA10 121 PA11 122 PA12 123 PA13 124 PA14 137 PA15 138 PB0 56 PB1 57 PB2 58 PB3 161 PB4 162 PB5 163 PB6 164 PB7 165 PB8 167 PB9 168 PB10 79 PB11 80 PB12 92 PB13 93 PB14 94 PB15 95 PC0 32 PC1 33 PC2 34 PC3 35 PC4 54 PC5 55 PC6 115 PC7 116 PC8 117 PC9 118 PC10 139 PC11 140 PC12 141 PC13 8 PC14 9 PC15 10 PD0 142 PD1 143 PD2 144 PD3 145 PD4 146 PD5 147 PD6 150 PD7 151 PD8 96 PD9 97 PD10 98 PD11 99 PD12 100 PD13 101 PD14 104 PD15 105 PE0 169 PE1 170 PE2 1 PE3 2 PE4 3 PE5 4 PE6 5 PE7 68 PE8 69 PE9 70 PE10 73 PE11 74 PE12 75 PE13 76 PE14 77 PE15 78 U1STM32F407IGTx

1 TXD 2 RXD 3 ~{CTS}9 ~{DSR} 10 ~{RI} 11 ~{DCD} 12 ~{DTR} 13 ~{RTS} 14 U4 CH340C

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

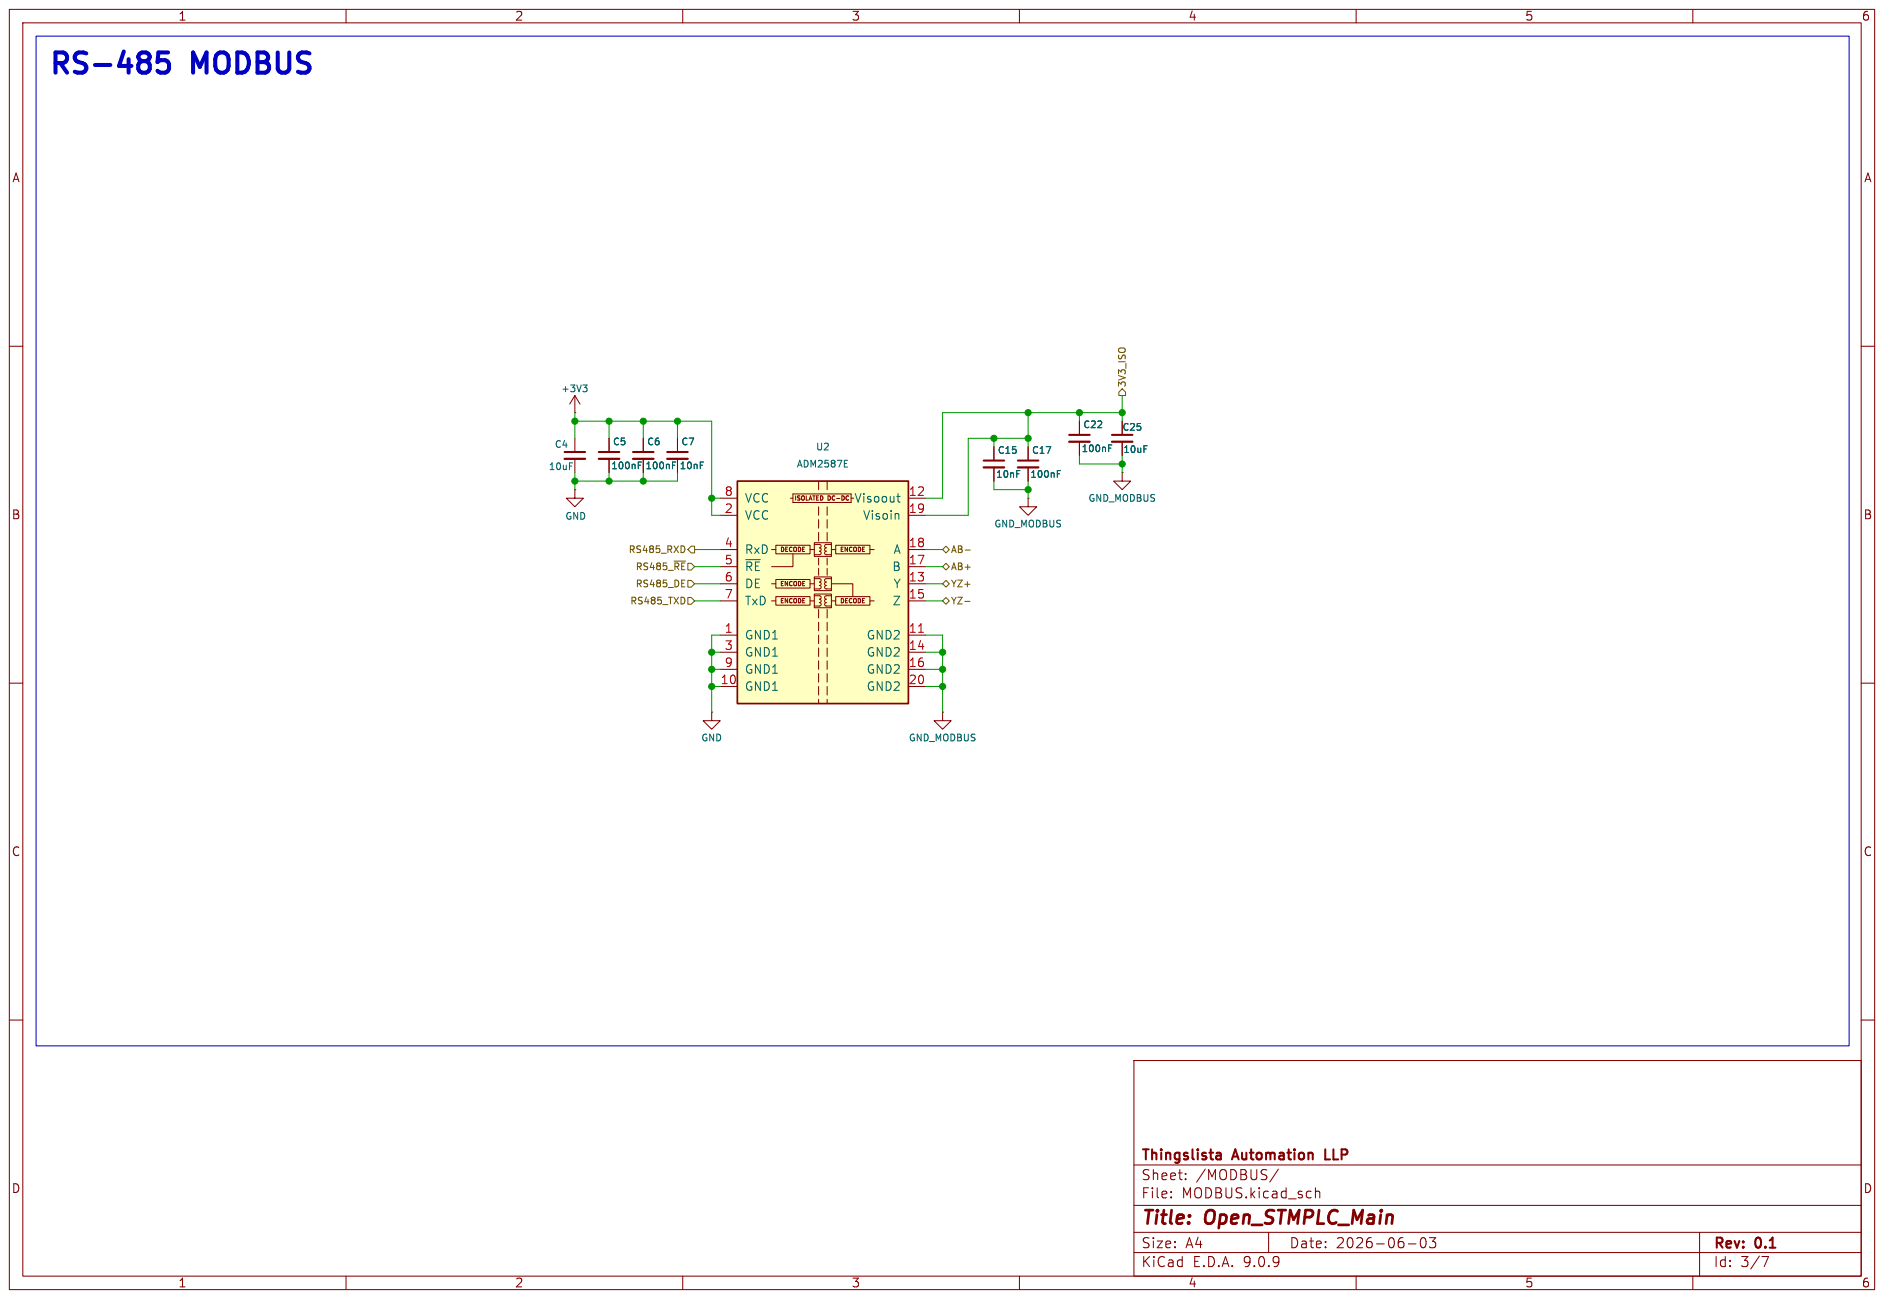
[picture p40: page 3]

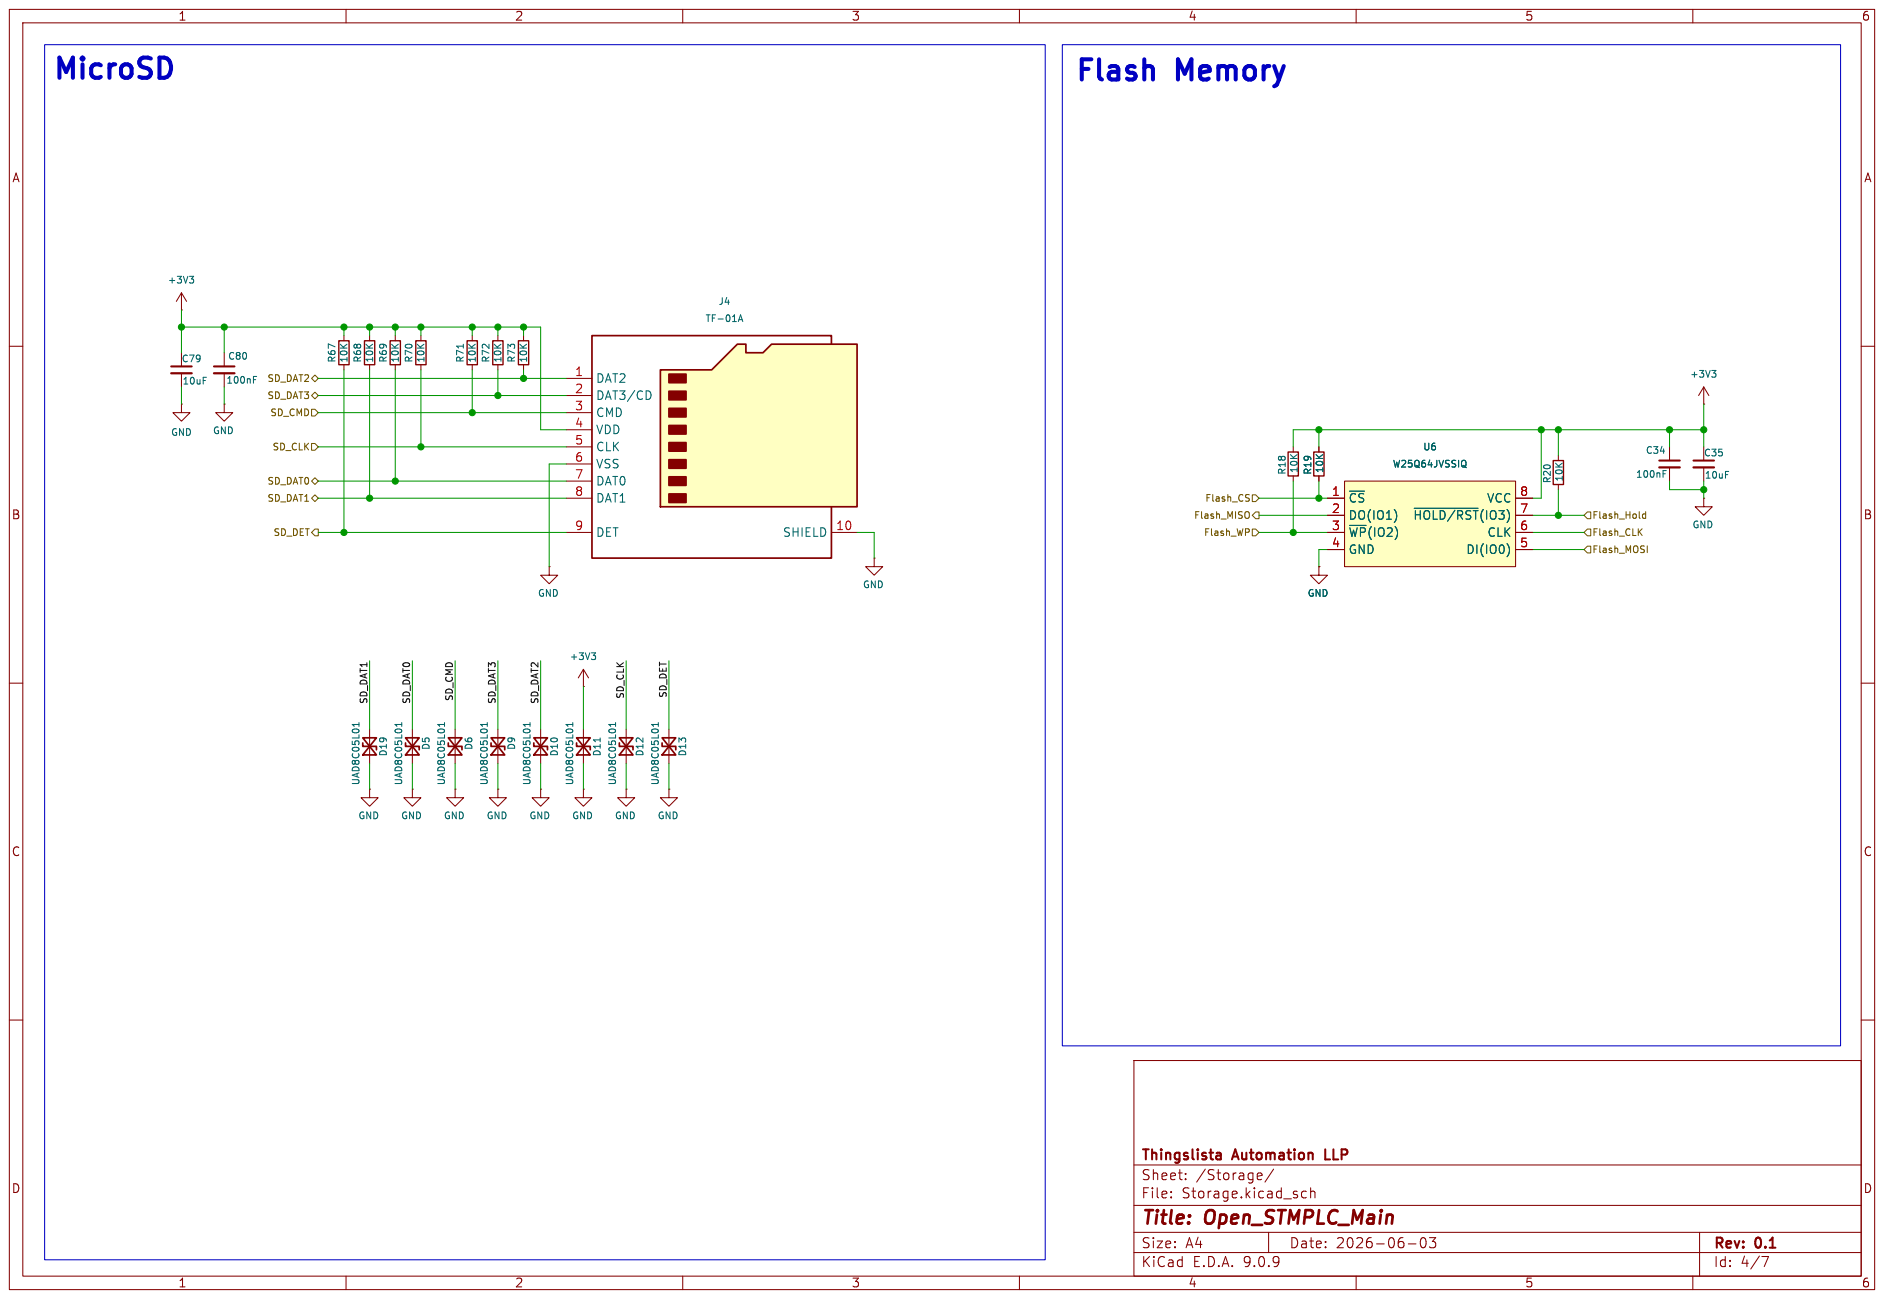
[picture p41: page 4]

File: Storage.kicad_sch Sheet: /Storage/
Id: 4/7 Title: Open_STMPLC_Main

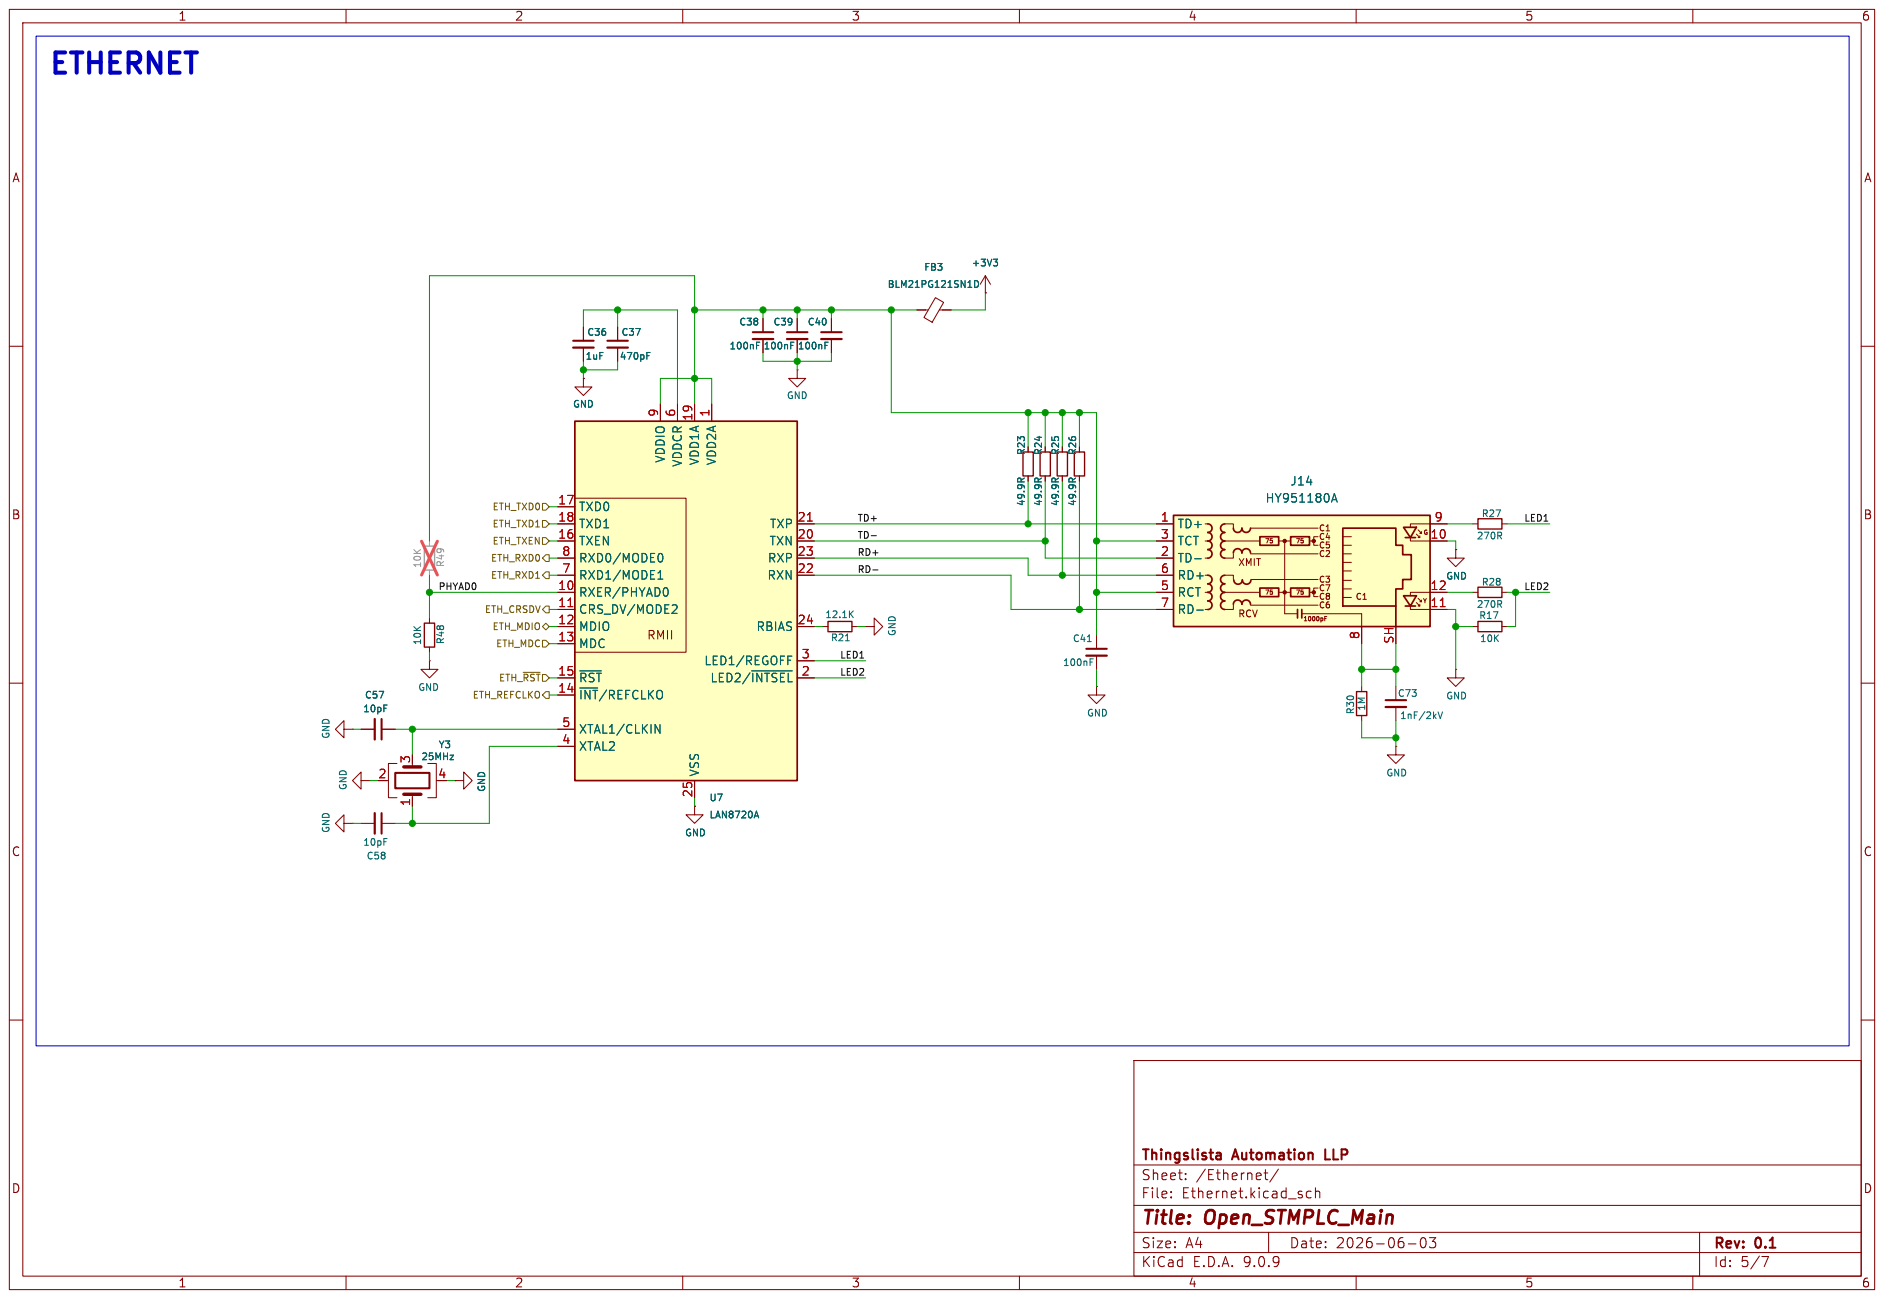
[picture p42: page 5]

1 TXP 21 TXN 20 RXP 23 RXN 22 RBIAS 24

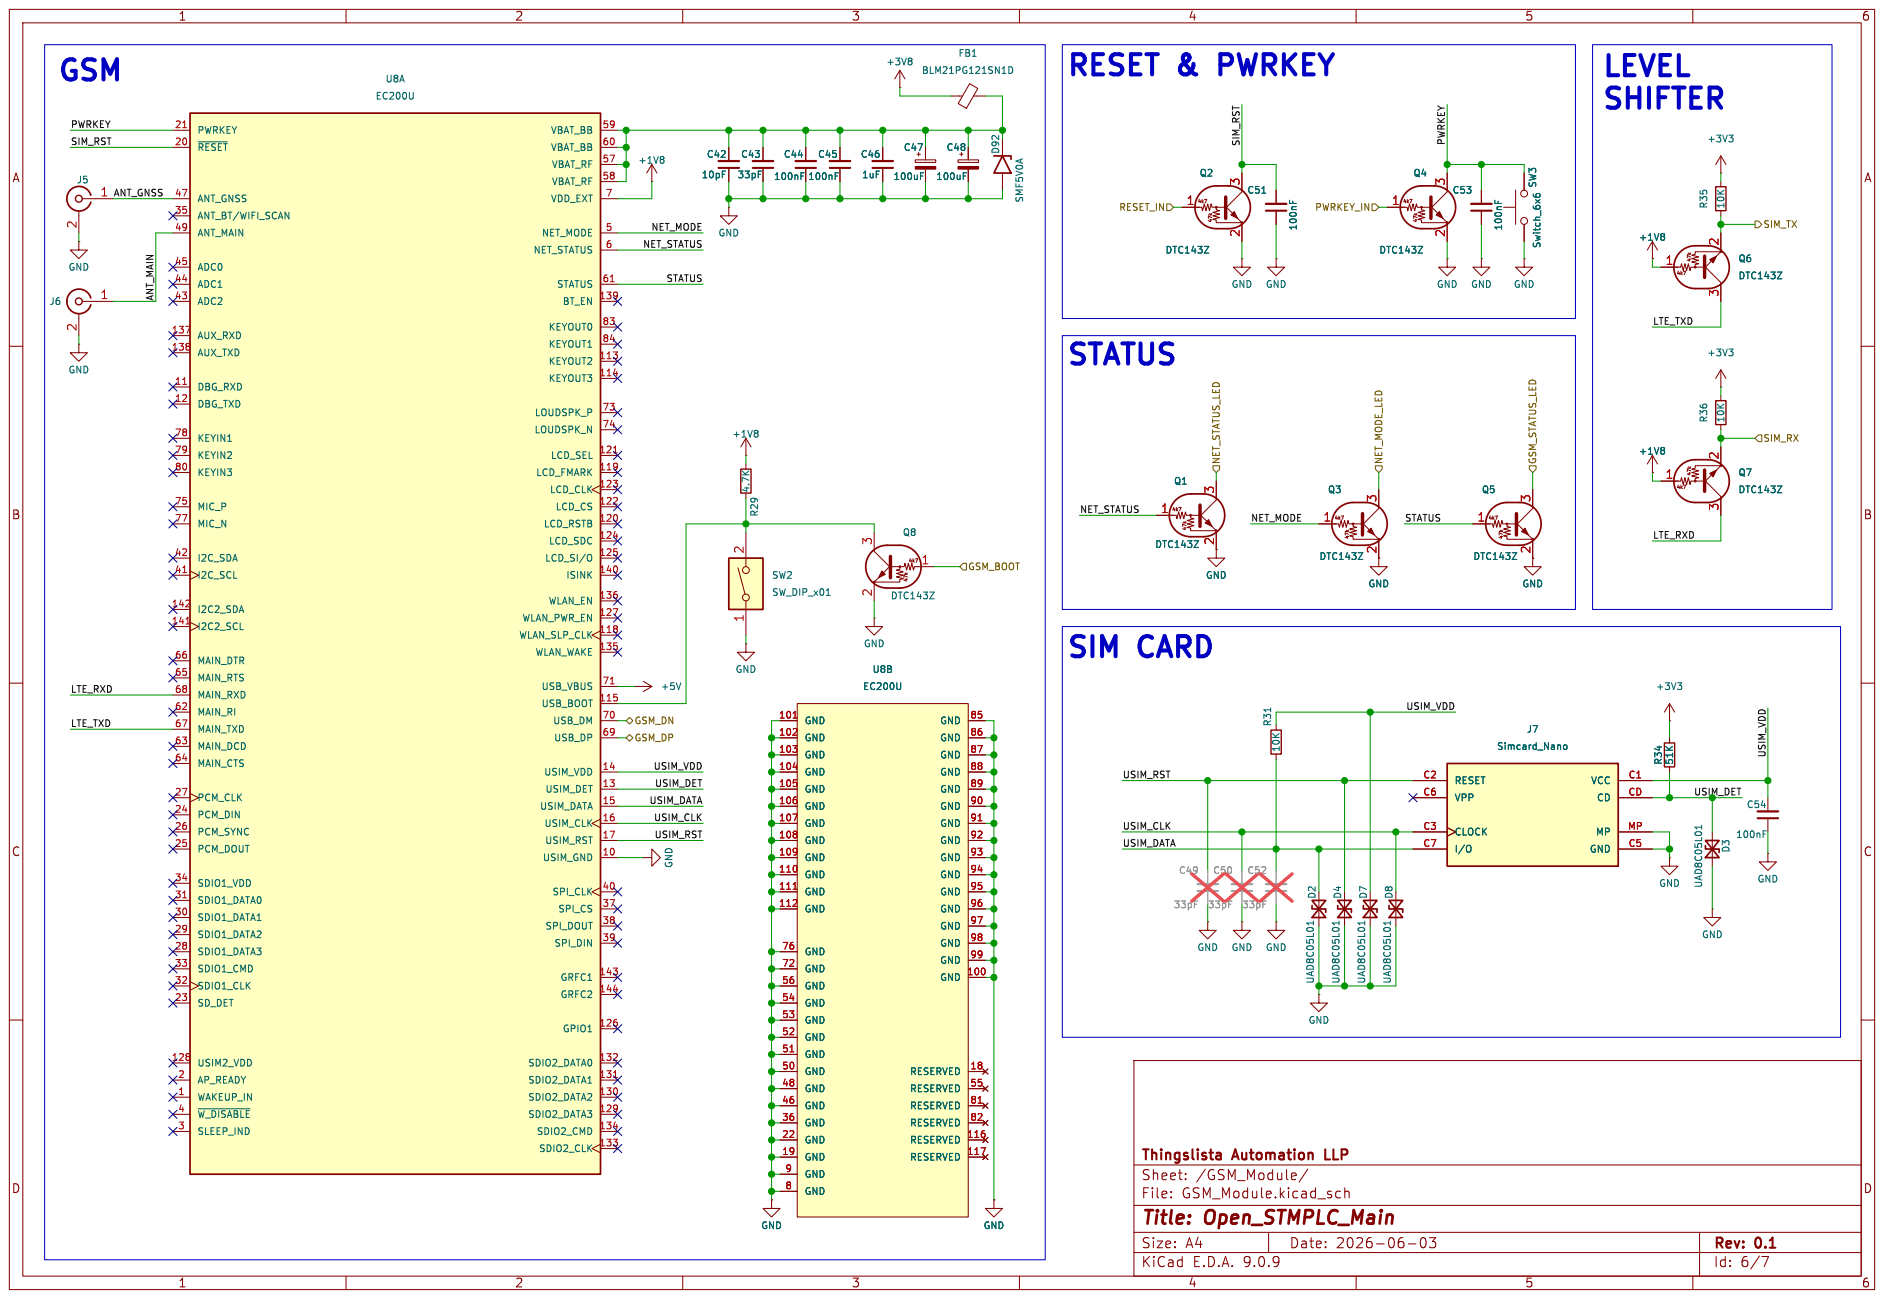
[picture p43: page 6]

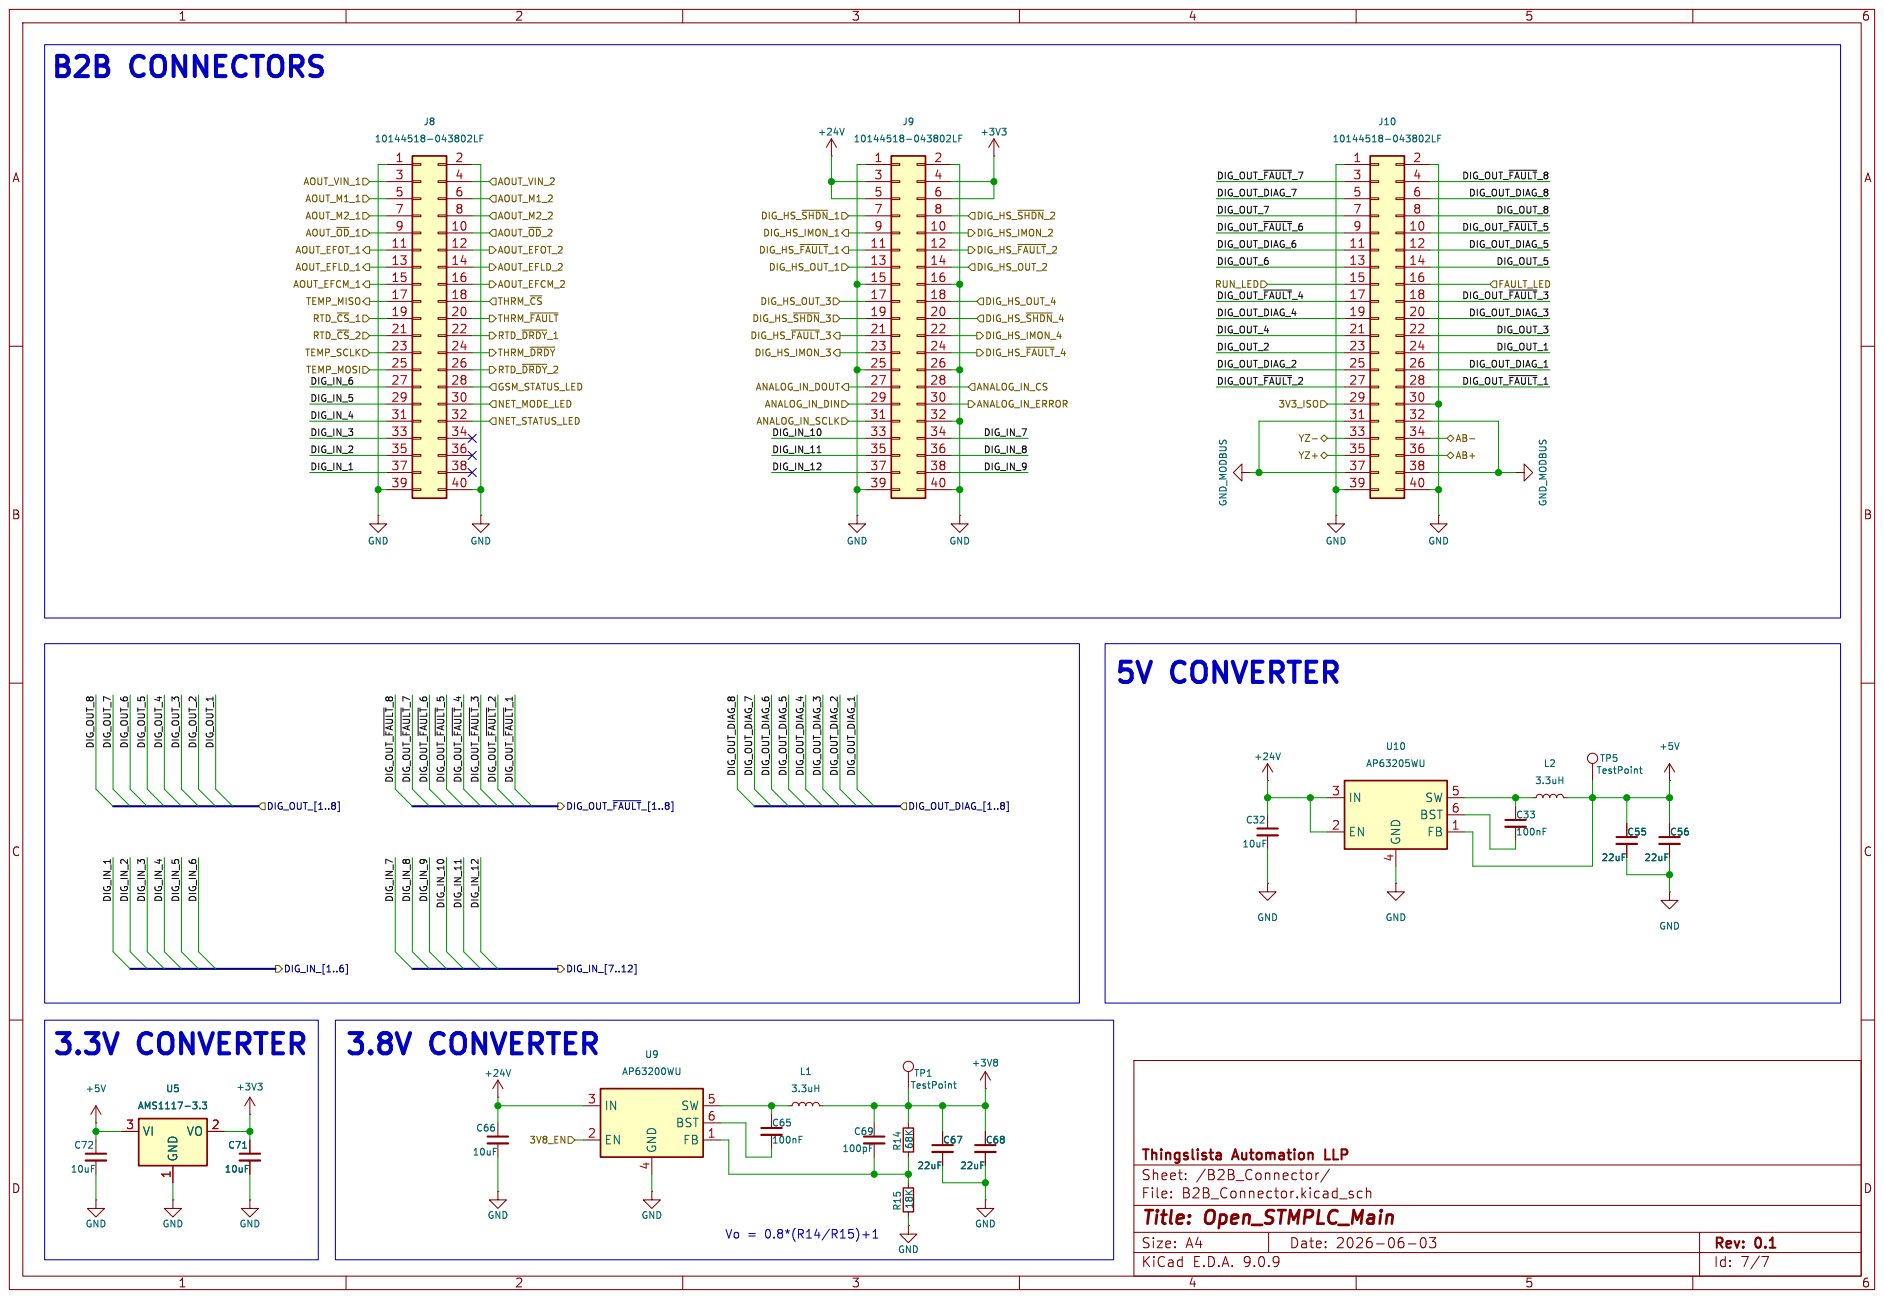
[picture p44: page 7]

4 SW 5 BST 6 FB 1 U10 AP63205WU TP5 TestPoint GND
