venam123/Open_STMPLC/Document/Controller/Controller Card/PLC_Controller Card.pdf

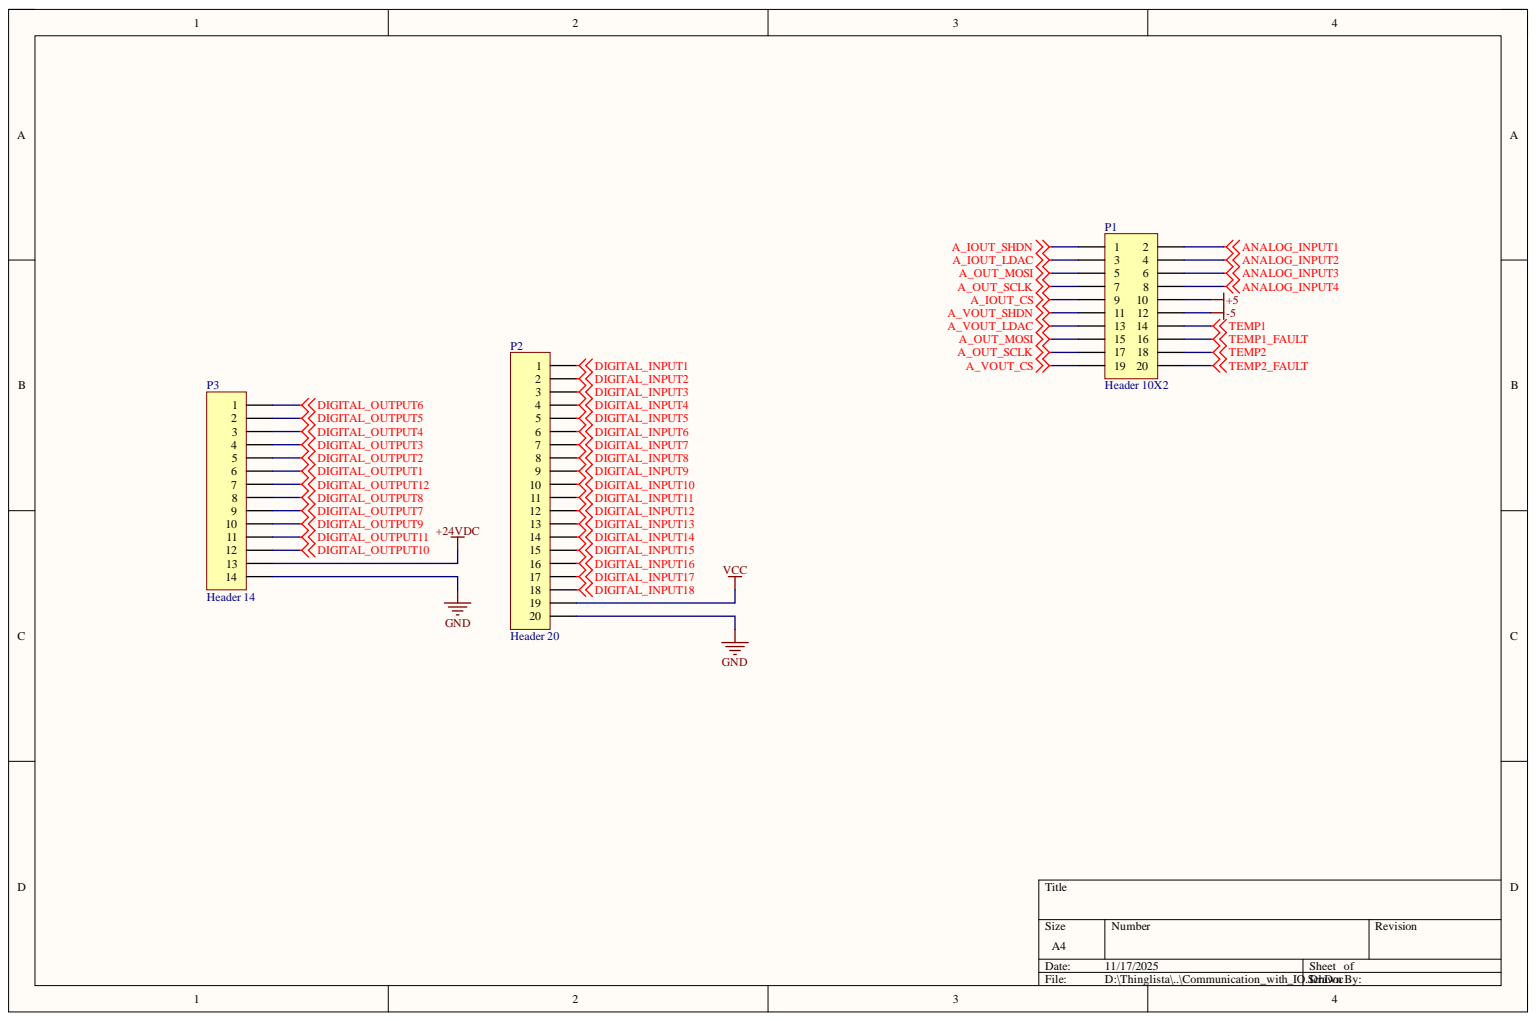
[picture p45: page 1]

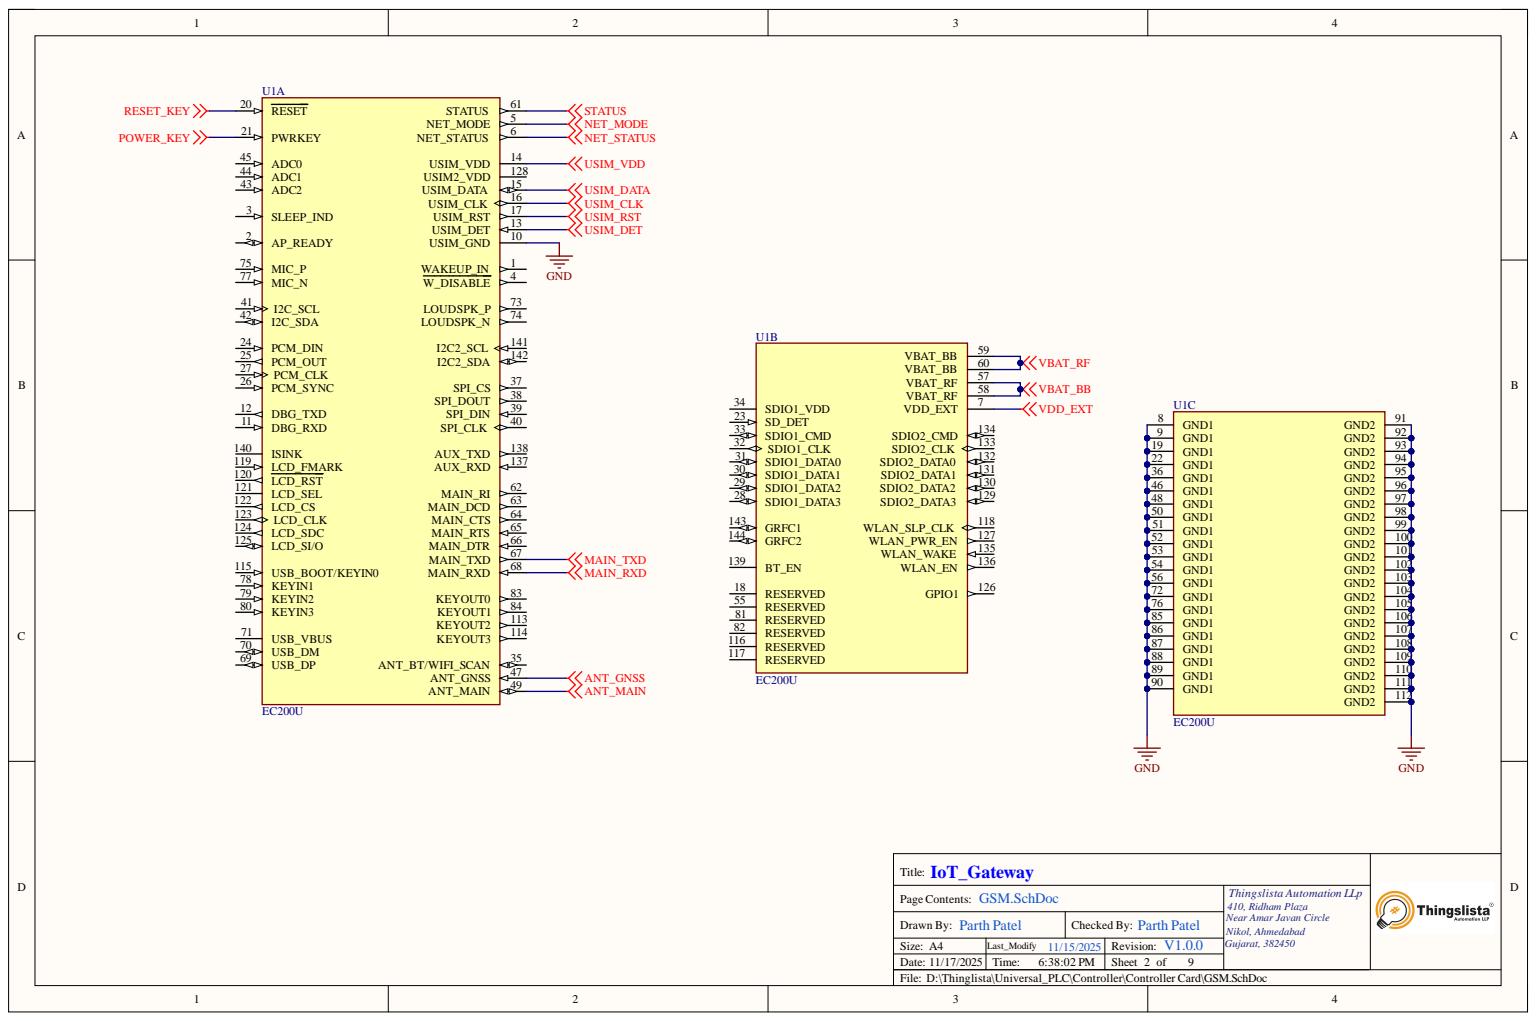
[picture p46: page 2]

7 2 | 1 0 4
7 6 | 1 0 5
8 5 | 1 0 6
8 6 | 1 0 7

8 7 | 1 0 8
8 8 | 1 0 9
8 9 | 1 1 0
9 0 | 1 1 1

Page Co n ten t s : GS M.S c h D o c

P arth P ate l Draw n By : | Checked By P arth P ate l :
Size : A 4 | 5 L a st_Modi fy 1 1 / 1 5 / 2 0 2 | Rev i s i o n : V1.0 . 0

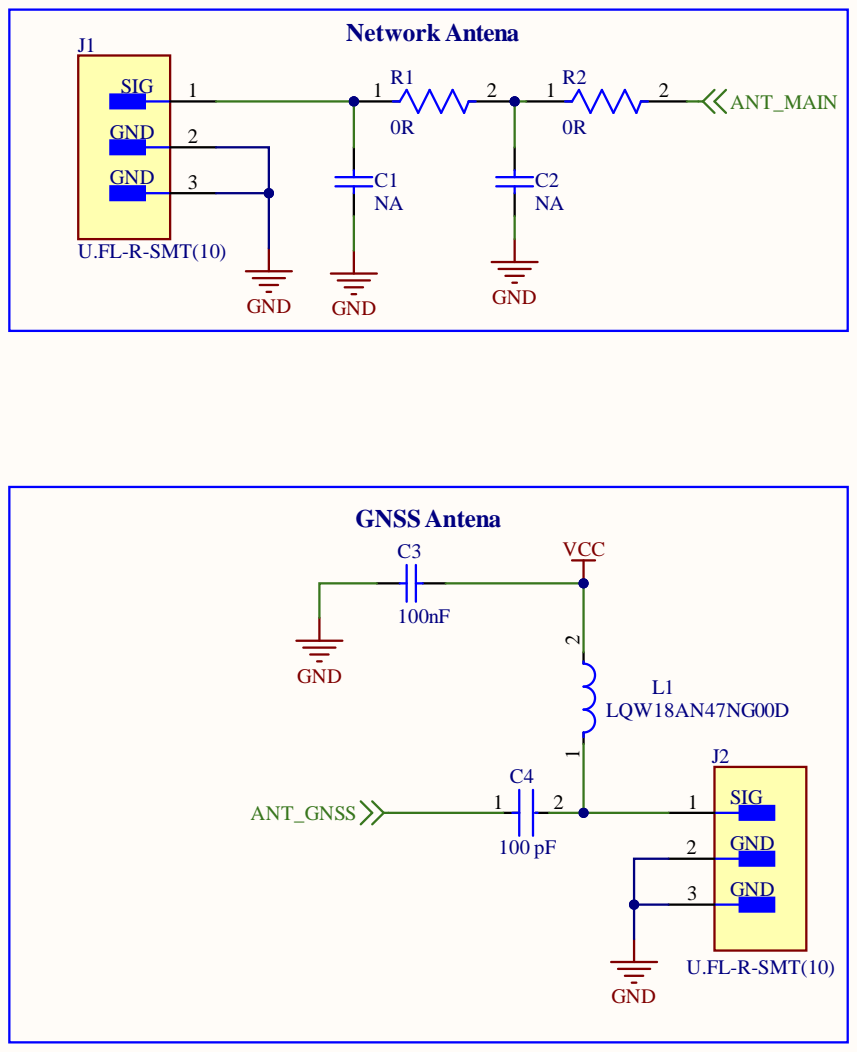
[picture p47: page 3]

Page Contents: ANT.SchDoc

Thingslista Automation LLp
410, Ridham Plaza
Near Amar Javan Circle
Nikol, Ahmedabad
Gujarat, 382450

Drawn By: Name | Checked By: None

Size: A4 | Last_Modify 11/15/2025 | Revision:

D:\Thinglista\Universal_PLC\Controller\Controller Card\ANT.SchDoc

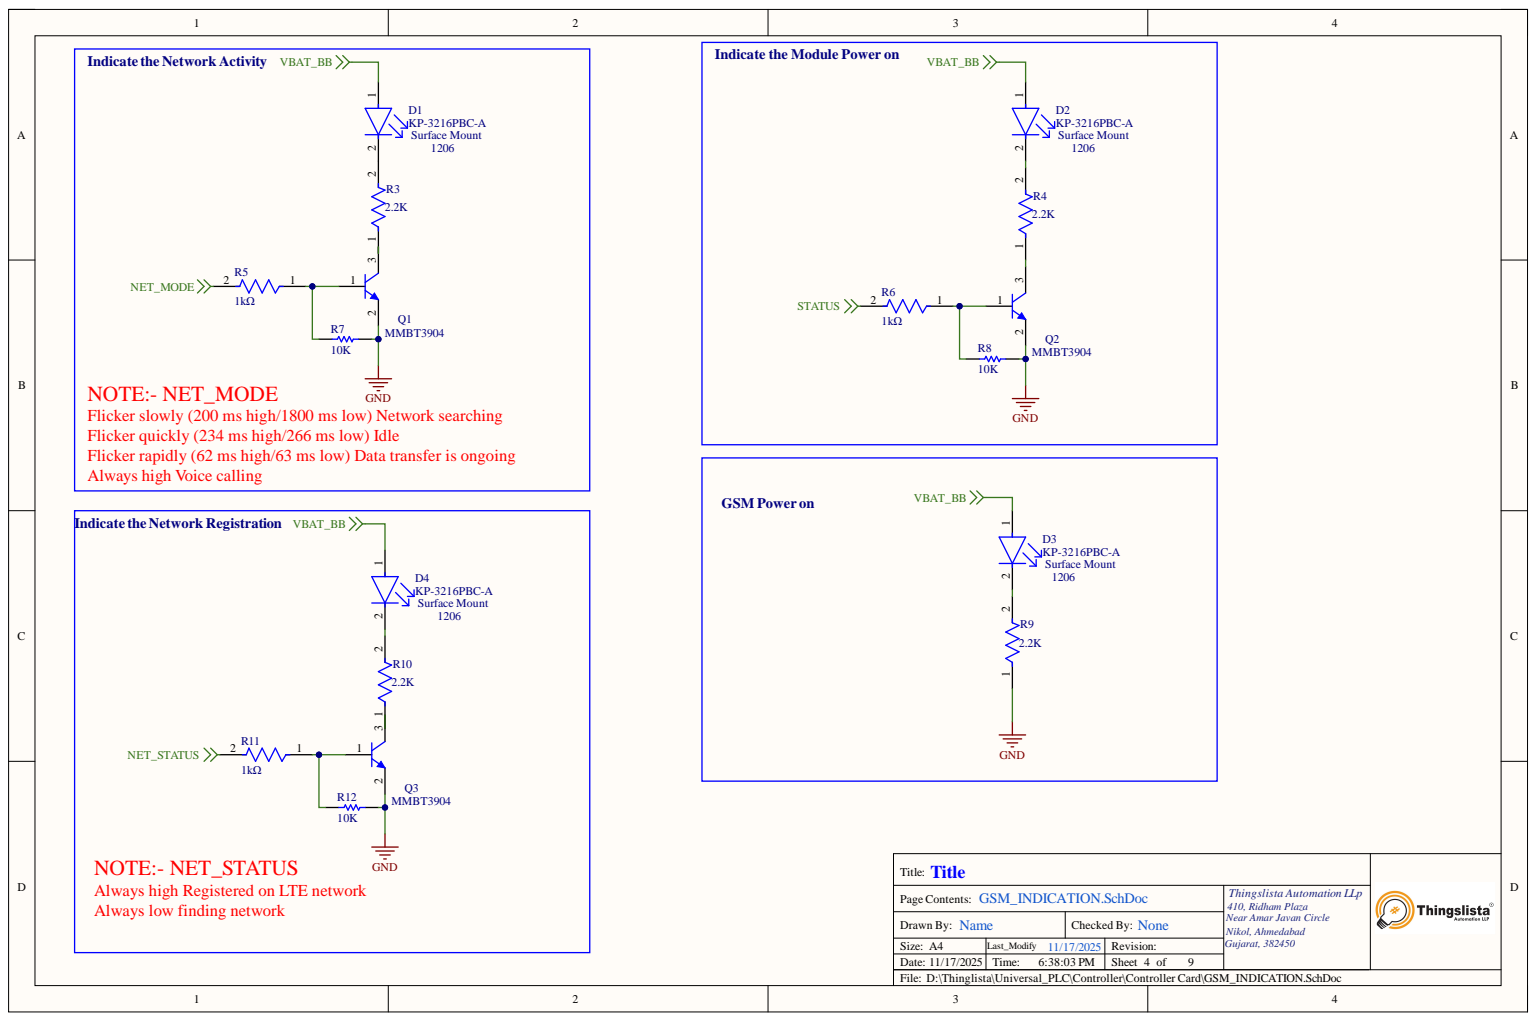
[picture p48: page 4]

NOTE:- NET_MODE Always high Registered on

Page Co n ten t s : GS M _INDICATION . S c h D o c

: Na m e Draw n By | Checked By : No n e

Size : A 4 | L a st_Modi fy 1 1 / 1 7 / 2 0 2 5 | Rev i s i o n :

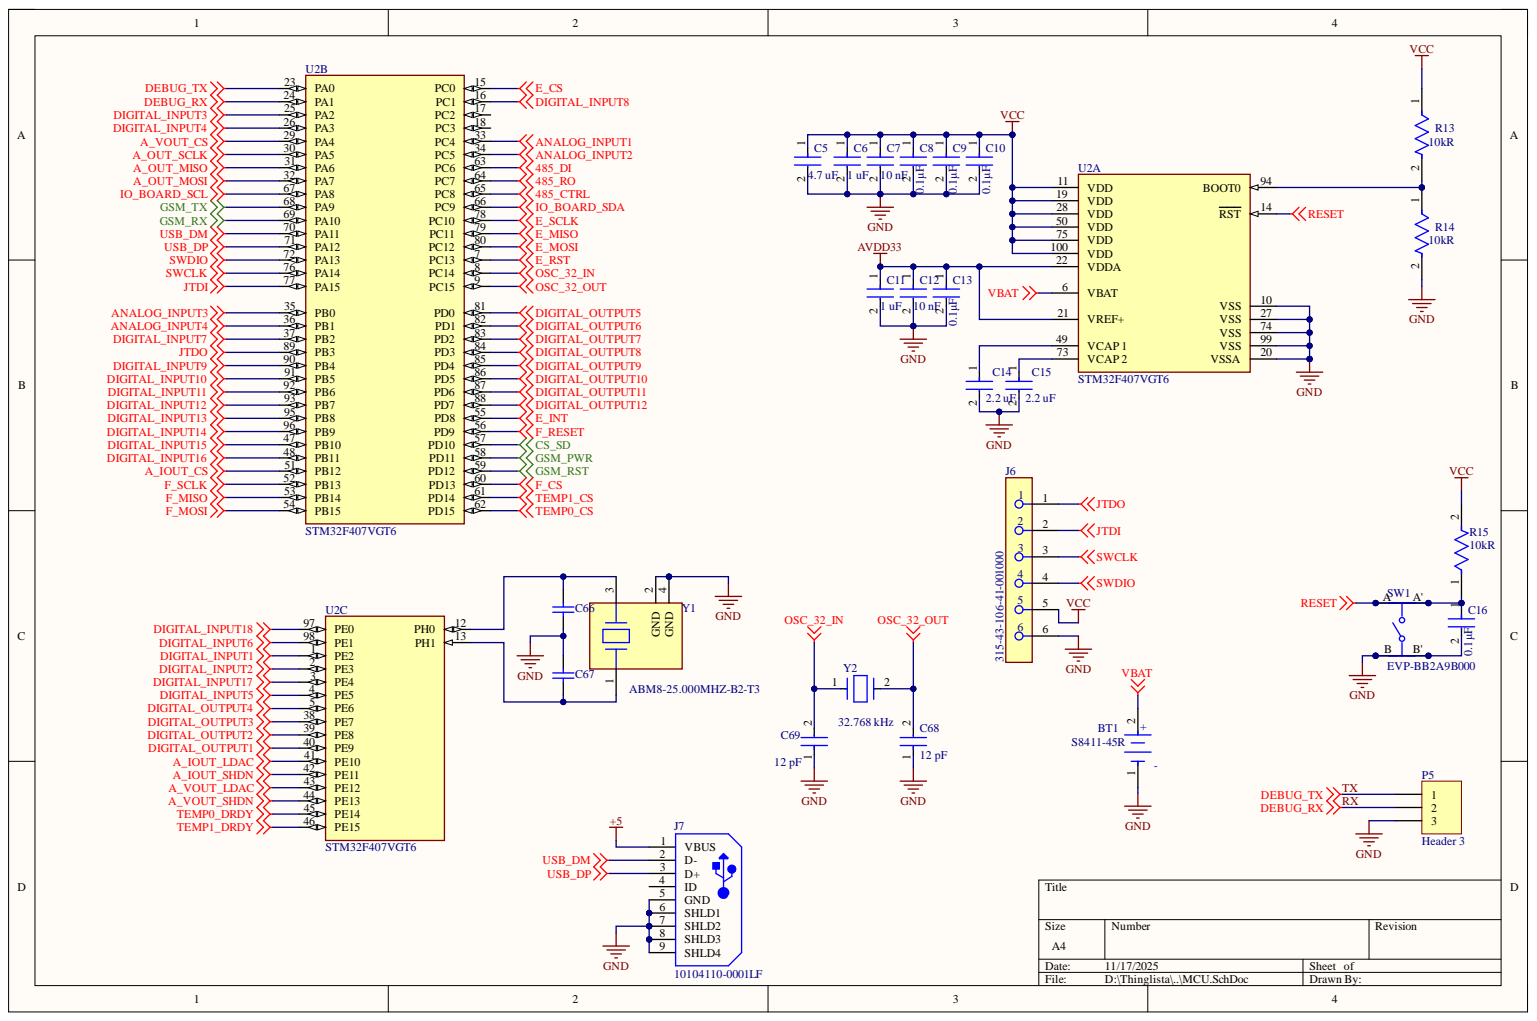
[picture p49: page 5]

1 9
2 8
5 0
7 5

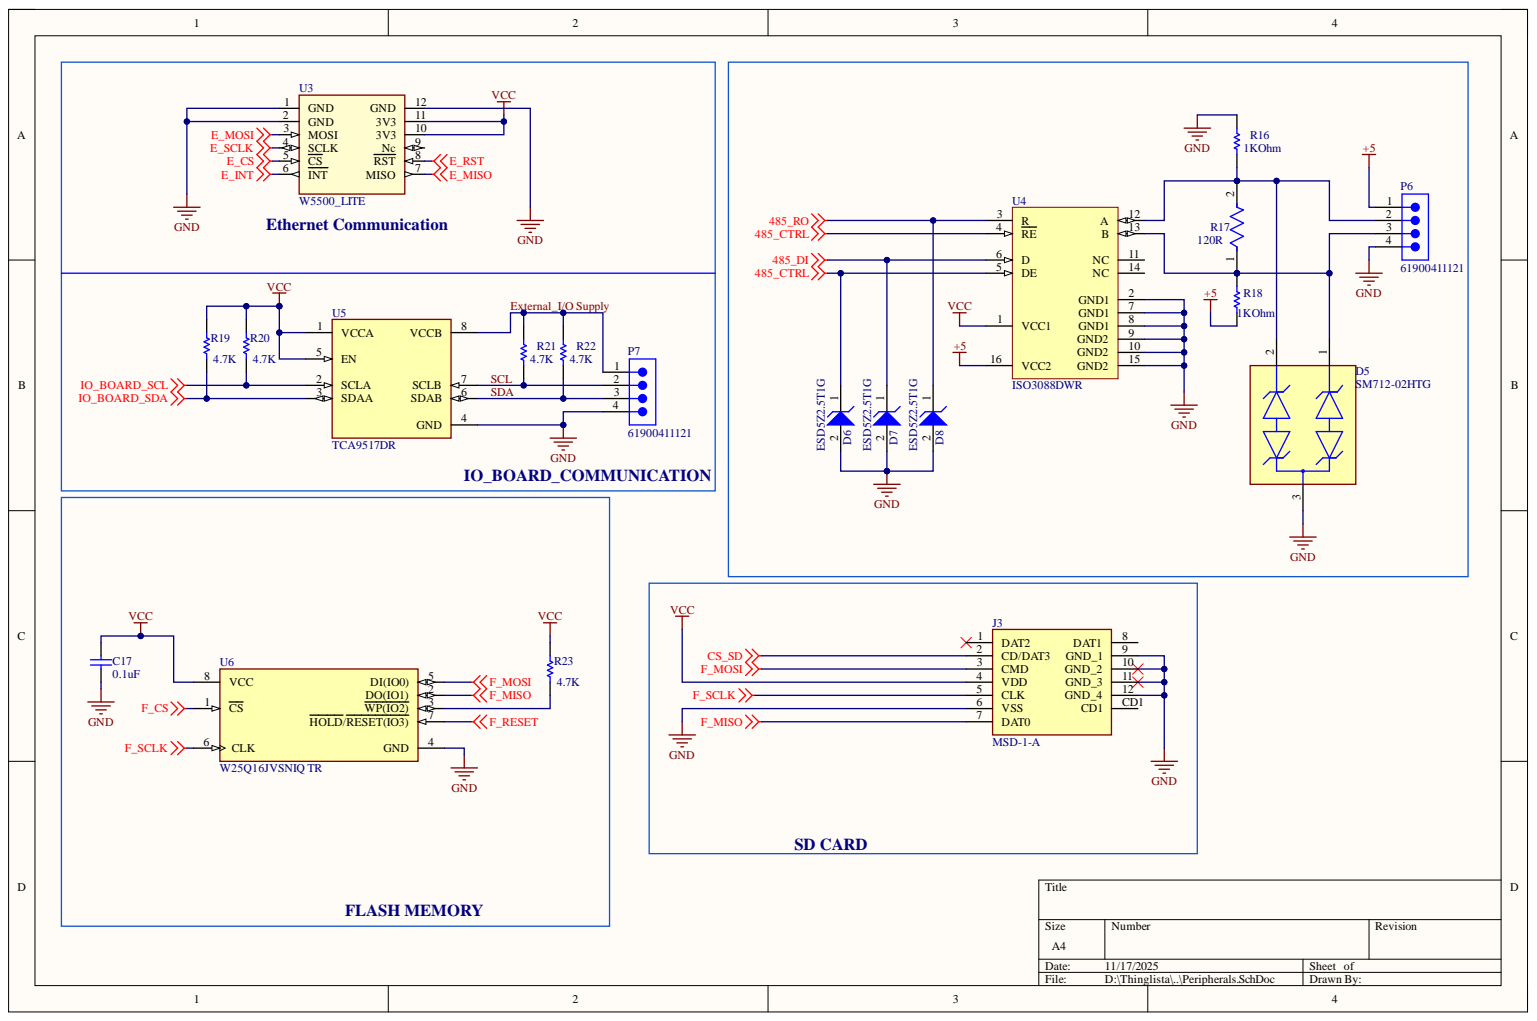
[picture p50: page 6]

E _MO S I E _SCL K E _ C S E _ IN T | 3 | | 0

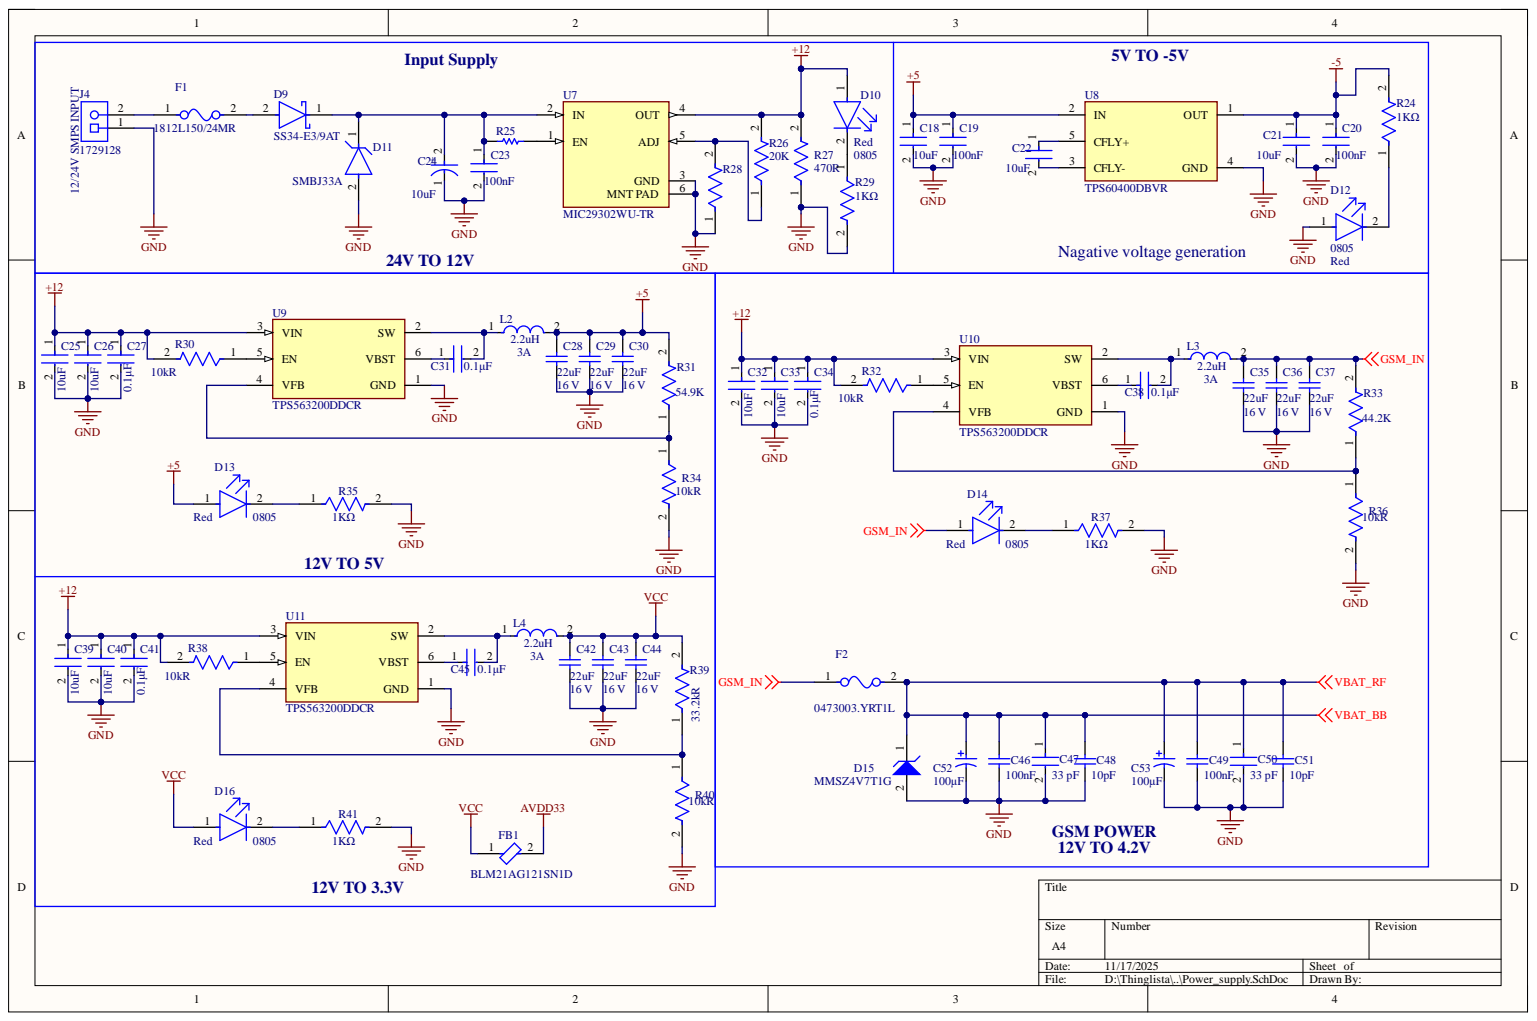
[picture p51: page 7]

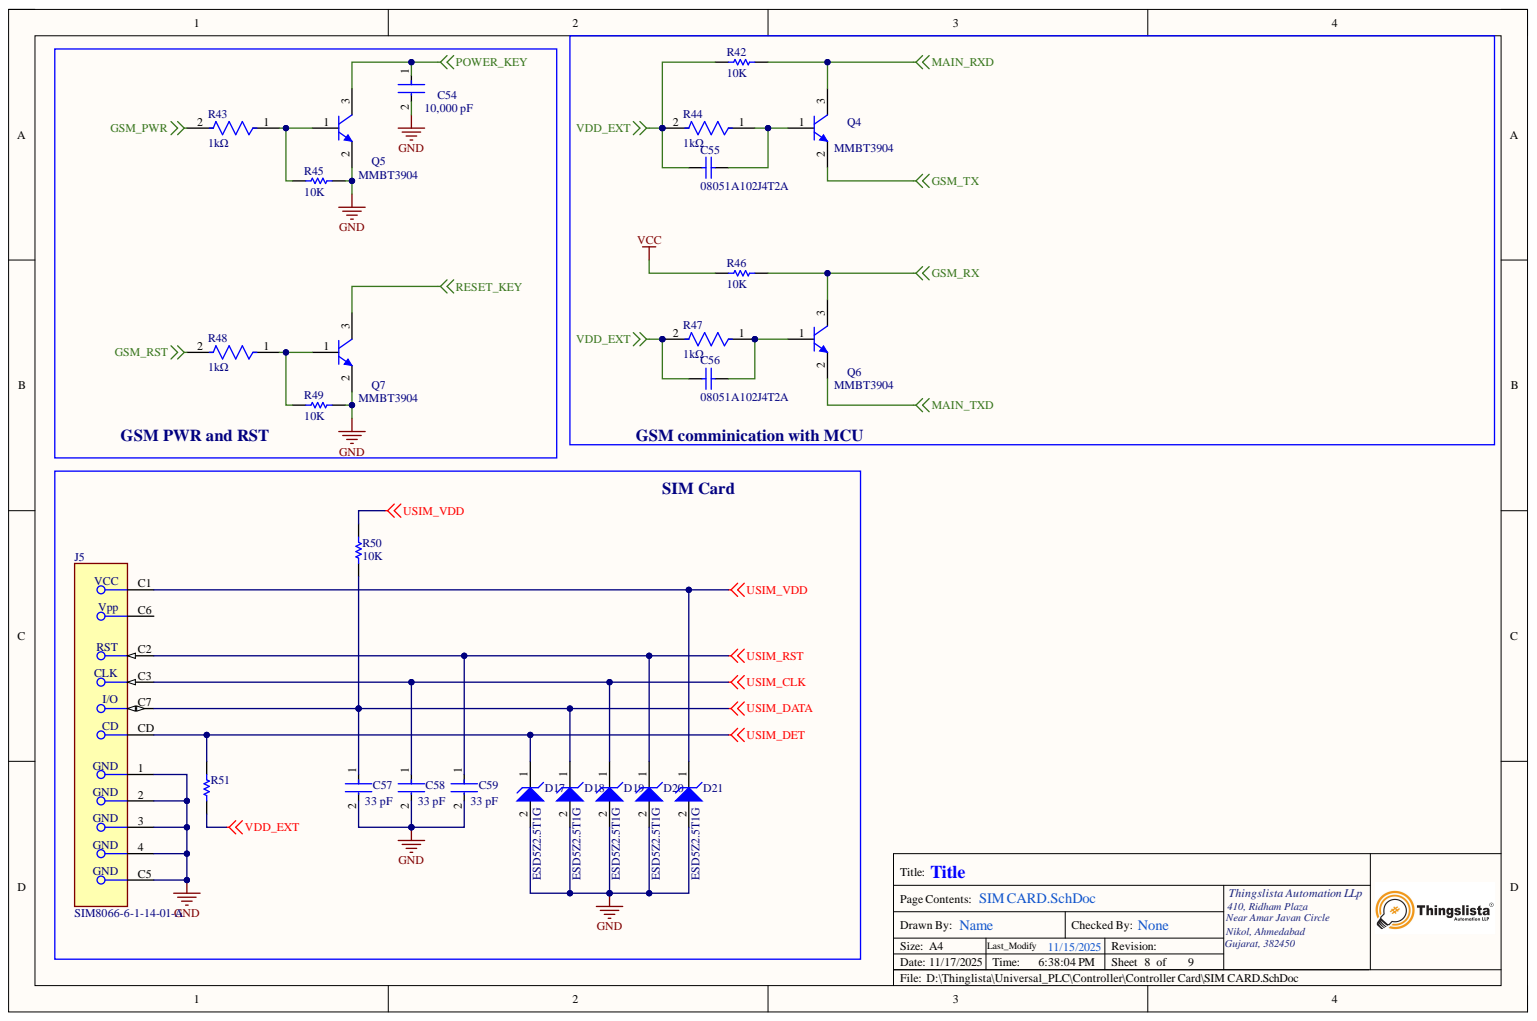
[picture p52: page 8]

Page Contents: SIMCARD.SchDoc

Thingslista Automation LLp
410, Ridham Plaza
Near Amar Javan Circle
Nikol, Ahmedabad
Gujarat, 382450

D:\Thinglista\Universal_PLC\Controller\Controller Card\SIM CARD.SchDoc

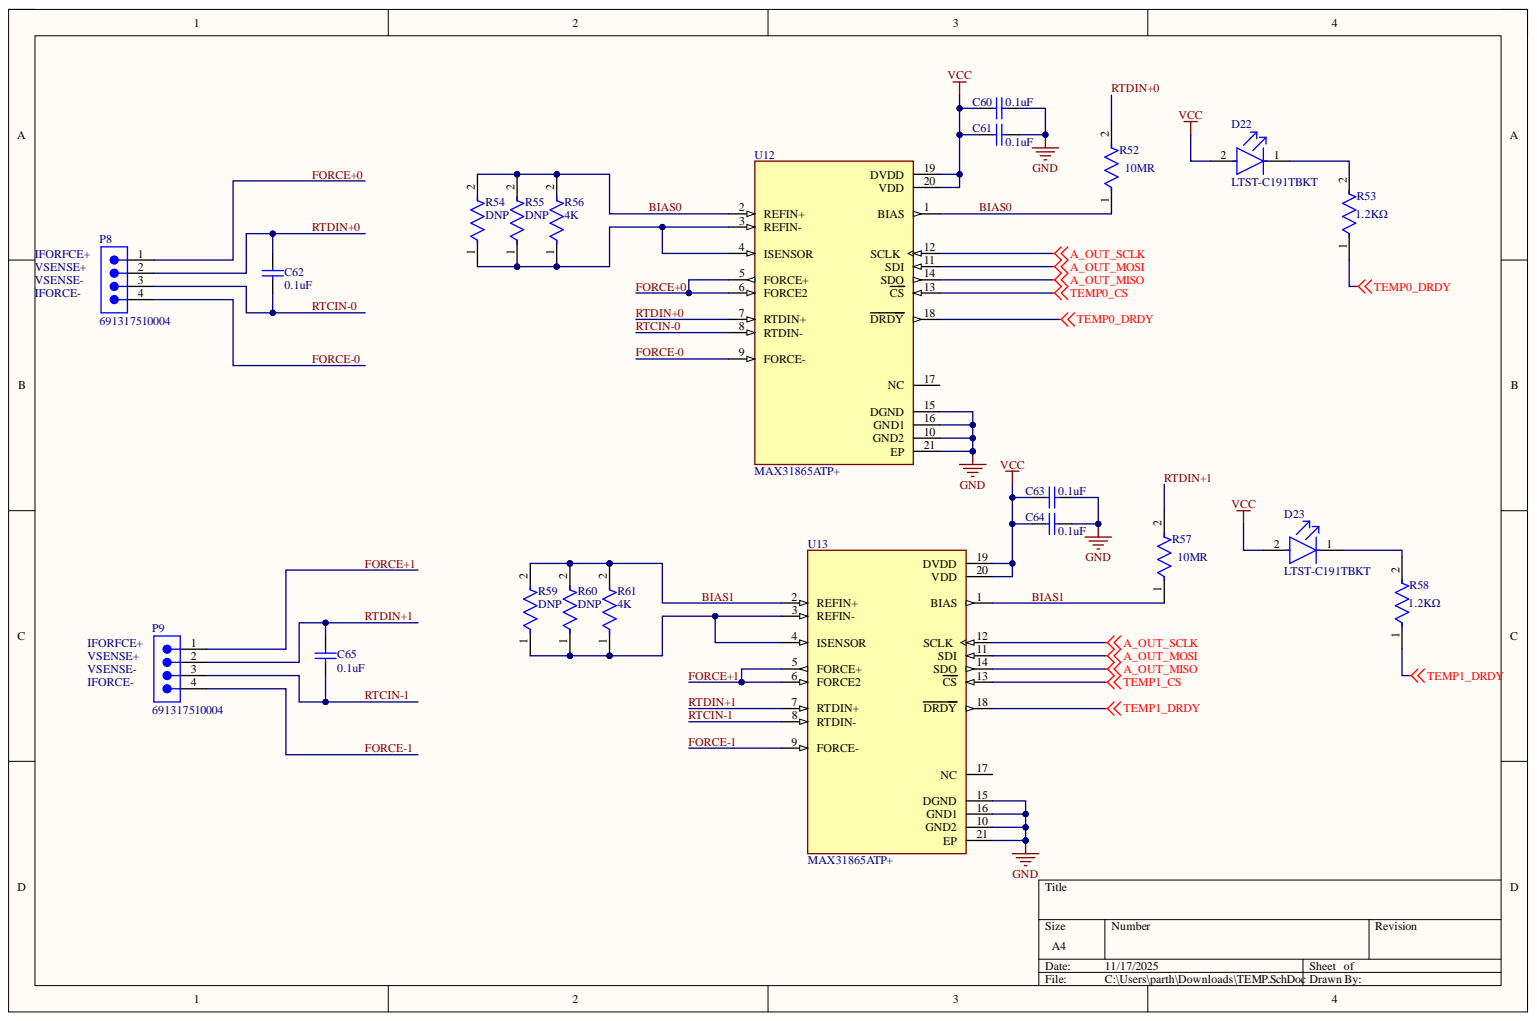
[picture p53: page 9]
