venam123/Open_STMPLC/(list of files, drawings)

Other design files:
Document/ATM90E3x_V1.05/Hardware/ATM90E3x-DB V1.0/ATM90E3x-DB.PcbDoc
Document/ATM90E3x_V1.05/Hardware/ATM90E3x-DB V1.0/ATM90E3x-DB.PcbLib
Document/ATM90E3x_V1.05/Hardware/ATM90E3x-DB V1.0/ATM90E3x-DB.PrjPcb
Document/ATM90E3x_V1.05/Hardware/ATM90E3x-DB V1.0/ATM90E3x-DB.SchDoc
Document/ATM90E3x_V1.05/Hardware/ATSAM4C-CB V1.0/1 - MCU.SchDoc
Document/ATM90E3x_V1.05/Hardware/ATSAM4C-CB V1.0/2 - Communication.SchDoc
Document/ATM90E3x_V1.05/Hardware/ATSAM4C-CB V1.0/3 - Periphery.SchDoc
Document/ATM90E3x_V1.05/Hardware/ATSAM4C-CB V1.0/ATSAM4C-CB.PcbDoc
Document/ATM90E3x_V1.05/Hardware/ATSAM4C-CB V1.0/ATSAM4C-CB.PrjPcb
Document/Controller/Controller Card/ANT.SchDoc
Document/Controller/Controller Card/Communication_with_IO.SchDoc
Document/Controller/Controller Card/GSM.SchDoc
Document/Controller/Controller Card/GSM_INDICATION.SchDoc
Document/Controller/Controller Card/MCU.SchDoc
Document/Controller/Controller Card/Peripherals.SchDoc
Document/Controller/Controller Card/PLC_Controller Card.PrjPcb
Document/Controller/Controller Card/Power_supply.SchDoc
Document/Controller/Controller Card/SIM CARD.SchDoc
Document/Universal_PLC/ANALOG_IOUTPUT.SchDoc
Document/Universal_PLC/ANALOG_VOUTPUT.SchDoc
Document/Universal_PLC/Digital_Input2.SchDoc
Document/Universal_PLC/Digital_Input3.SchDoc
Document/Universal_PLC/Digital_Input.SchDoc
Document/Universal_PLC/DIGITAL_OUTPUT1.SchDoc
Document/Universal_PLC/DIGITAL_OUTPUT.SchDoc
Document/Universal_PLC/Temp_sensors Input.SchDoc
Document/Universal_PLC/Universal_PLC.PrjPcb
