venam123/Open_STMPLC/Firmware/OpenSTM_PLC.ioc

Mcu.UserName=STM32F407IGTx
PA1.Signal=ETH_REF_CLK
PA10.Signal=USART1_RX
PA11.Signal=USB_OTG_FS_DM
PA12.Signal=USB_OTG_FS_DP
PA13.Signal=SYS_JTMS-SWDIO
PA14.Signal=SYS_JTCK-SWCLK
PA2.Signal=ETH_MDIO
PA4.Signal=COMP_DAC1_group
PA5.Signal=COMP_DAC2_group
PA7.Signal=ETH_CRS_DV
PA9.Signal=USART1_TX
PB10.Signal=USART3_TX
PB11.Signal=USART3_RX
PB13.Signal=USB_OTG_HS_VBUS
PB14.Signal=USB_OTG_HS_DM
PB15.Signal=USB_OTG_HS_DP
PB3.Signal=SPI1_SCK
PB4.Signal=SPI1_MISO
PB5.Signal=SPI1_MOSI
PC1.Signal=ETH_MDC
PC10.Signal=SDIO_D2
PC11.Signal=SDIO_D3
PC12.Signal=SDIO_CK
PC14-OSC32_IN.Signal=RCC_OSC32_IN
PC15-OSC32_OUT.Signal=RCC_OSC32_OUT
PC4.Signal=ETH_RXD0
PC5.Signal=ETH_RXD1
PC6.Signal=USART6_TX
PC7.Signal=USART6_RX
PC8.Signal=SDIO_D0
PC9.Signal=SDIO_D1
PD2.Signal=SDIO_CMD
PD5.Signal=USART2_TX
PD6.Signal=USART2_RX
PE5.Signal=S_TIM9_CH1
PE6.Signal=S_TIM9_CH2
PF3.Signal=ADC3_IN9
PF4.Signal=ADC3_IN14
PF5.Signal=ADC3_IN15
PF6.Signal=S_TIM10_CH1
PF7.Signal=ADC3_IN5
PF8.Signal=ADC3_IN6
PF9.Signal=ADC3_IN7
PG11.Signal=ETH_TX_EN
PG13.Signal=ETH_TXD0
PG14.Signal=ETH_TXD1
PH0-OSC_IN.Signal=RCC_OSC_IN
PH1-OSC_OUT.Signal=RCC_OSC_OUT
PH4.Signal=I2C2_SCL
PH5.Signal=I2C2_SDA
PH7.Signal=I2C3_SCL
PH8.Signal=I2C3_SDA
PI1.Signal=SPI2_SCK
PI2.Signal=SPI2_MISO
PI3.Signal=SPI2_MOSI
PI7.Signal=S_TIM8_CH3
