venam123/Open_STMPLC/(commit log)

2026-03-10 update the PCB Files
    [1 - MCU.SchDoc, 2 - Communication.SchDoc, 3 - Periphery.SchDoc, ANALOG_IOUTPUT.SchDoc, ANALOG_VOUTPUT.SchDoc, ANT.SchDoc, ATM90E3x-DB BOM.xlsx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]
2026-03-10 Initial hardware commit
    [Open_STMPLC_Main_V0.1.kicad_pcb, Open_STMPLC_Main_V0.1.kicad_sch]
2026-03-11 Symbol libraries 1
    [Open_STMPLC_Main_V0.1.kicad_sch]
2026-03-14 Main Schematic V0.1 updates
    [Digital_Inputs.kicad_sch, GSM_Module.kicad_sch, Microcontroller.kicad_sch, Open_STMPLC_Main_V0.1.kicad_sch]
2026-03-16 MODBUS and GSM changes
    [GSM_Module.kicad_sch, Open_STMPLC_Main_V0.1.kicad_sch]
2026-03-20 schematic updates v0.1
    [Microcontroller.kicad_sch, Open_STMPLC_Main_V0.1.kicad_sch]
2026-03-22 IO board schematic
    [Digital_Inputs.kicad_sch, Microcontroller.kicad_sch, Open_STMPLC_IO_V0.1.kicad_pcb, Open_STMPLC_IO_V0.1.kicad_sch, Open_STMPLC_Main_V0.1.kicad_sch]
2026-03-23 IO board changes
    [DIG_OUT.kicad_sch, Open_STMPLC_IO_V0.1.kicad_sch, Temp_Sensor.kicad_sch, untitled.kicad_sch]
2026-03-24 IO board schematic changes
    [DIG_IN.kicad_sch, DIG_OUT.kicad_sch, Ethernet.kicad_sch, MODBUS.kicad_sch, Microcontroller.kicad_sch, Open_STMPLC_IO_V0.1.kicad_sch, Open_STMPLC_Main_V0.1.kicad_sch, Storage.kicad_sch]
2026-03-25 Digital IO completion
    [DIG_HS_OUT_1.kicad_sch, DIG_HS_OUT_2.kicad_sch, DIG_HS_OUT_3.kicad_sch, DIG_HS_OUT_4.kicad_sch, DIG_IN.kicad_sch, DIG_IN_GRP1.kicad_sch, DIG_IN_GRP2.kicad_sch, DIG_IN_GRP3.kicad_sch]
2026-03-30 Analog out section
    [ANALOG_IN.kicad_sch, ANALOG_OUT.kicad_sch, DIG_HS_OUT_4.kicad_sch, DIG_IN_GRP2.kicad_sch, DIG_IN_GRP3.kicad_sch, Open_STMPLC_IO_V0.1.kicad_sch]
2026-03-30 Analog input section
    [ANALOG_IN.kicad_sch, ANALOG_OUT.kicad_sch, DIG_HS_OUT_1.kicad_sch, DIG_HS_OUT_2.kicad_sch, DIG_HS_OUT_3.kicad_sch, DIG_HS_OUT_4.kicad_sch, DIG_IN_GRP1.kicad_sch, DIG_IN_GRP2.kicad_sch]
2026-04-03 GSM Module add
    [10144517-041802LF.step, 10144518-041802LF.step, ANALOG_IN.kicad_sch, ANALOG_OUT.kicad_sch, B2B_Connector.kicad_sch, DIG_HS_OUT_1.kicad_sch, DIG_HS_OUT_2.kicad_sch, DIG_HS_OUT_3.kicad_sch]
2026-04-04 Main PCB schematic changes V0.1
    [ANALOG_IN.kicad_sch, ANALOG_OUT.kicad_sch, B2B_Connector.kicad_sch, DIG_HS_OUT_1.kicad_sch, DIG_HS_OUT_2.kicad_sch, DIG_HS_OUT_3.kicad_sch, DIG_HS_OUT_4.kicad_sch, DIG_IN_GRP1.kicad_sch]
2026-04-08 Main PCB watchdog and USB add
    [Microcontroller.kicad_sch]
2026-04-14 Update the DXF Files
    [Universal_PLC_Bottom_PCB.dxf, Universal_PLC_Top_PCB.dxf, Universal_PLC_Top_PCB_With_Terminal.dxf]
2026-04-16 New DXF update
    [ANALOG_IN.kicad_sch, ANALOG_OUT.kicad_sch, B2B_Connector.kicad_sch, DIG_HS_OUT_1.kicad_sch, DIG_HS_OUT_2.kicad_sch, DIG_HS_OUT_3.kicad_sch, DIG_HS_OUT_4.kicad_sch, DIG_IN_GRP1.kicad_sch]
2026-04-20 Update DXF files
    Top & Bottom files
    [LK-PLC18_Botton_PCB.dwg, LK-PLC18_Top_Bottom_Overlapp.dwg, LK-PLC18_Top_PCB.dwg, LK-PLC18_With_Terminal.dwg]
2026-04-20 Common GND terminal changes
    [B2B_Connector.kicad_sch, DIG_HS_OUT_1.kicad_sch, DIG_HS_OUT_2.kicad_sch, DIG_HS_OUT_3.kicad_sch, DIG_HS_OUT_4.kicad_sch, DIG_OUT.kicad_sch, Open_STMPLC_IO_V0.1.kicad_pcb, Open_STMPLC_IO_V0.1.kicad_sch]
2026-04-20 Rule areas creation
    [ANALOG_OUT.kicad_sch, DIG_IN_GRP1.kicad_sch, DIG_IN_GRP2.kicad_sch, DIG_OUT.kicad_sch, Open_STMPLC_IO_V0.1.kicad_pcb]
2026-04-21 IO board component grouping
    [DIG_IN_GRP1.kicad_sch, DIG_IN_GRP2.kicad_sch, LK-PLC18_Botton_PCB.dxf, Open_STMPLC_IO_V0.1.kicad_pcb]
2026-04-22 Added New DXF Files
    [LK-PLC18_Botton_PCB.dxf, LK-PLC18_Top_Bottom_Overlapp.dxf, LK-PLC18_Top_PCB.dxf]
2026-04-22 IO board component placement
    [DIG_IN_GRP1.kicad_sch, DIG_IN_GRP2.kicad_sch, Open_STMPLC_IO_V0.1.kicad_pcb, Open_STMPLC_IO_V0.1.kicad_sch]
2026-04-23 Input circuit added
    [B2B_Connector.kicad_sch, DIG_IN_GRP1.kicad_sch, DIG_IN_GRP2.kicad_sch, GSM_Module.kicad_sch, Microcontroller.kicad_sch, Open_STMPLC_IO_V0.1.kicad_sch]
2026-04-25 IO board layout
    [ANALOG_IN.kicad_sch, ANALOG_OUT.kicad_sch, B2B_Connector.kicad_sch, DIG_IN_GRP1.kicad_sch, DIG_IN_GRP2.kicad_sch, Open_STMPLC_IO_V0.1.kicad_pcb, Temp_Sensor.kicad_sch]
2026-04-26 IO board layout 1
    [ANALOG_IN.kicad_sch, B2B_Connector.kicad_sch, Open_STMPLC_IO_V0.1.kicad_pcb, TPS1H200AQDGNRQ1.STEP, Temp_Sensor.kicad_sch]
2026-04-29 LED arrengements
    [B2B_Connector.kicad_sch, Open_STMPLC_IO_V0.1.kicad_pcb]
2026-04-29 update the Step File
    [SMPS Price.xlsx]
2026-05-02 Component placement IO board
    [A-DF_09_PP_Z.stp, ANALOG_OUT.kicad_sch, B2B_Connector.kicad_sch, DIG_OUT.kicad_sch, Open_STMPLC_IO_V0.1.kicad_pcb]
2026-05-04 Pin mapping IO connector
    [10144517-041802LF.step, 10144518-041802LF.step, B2B_Connector.kicad_sch, Ethernet.kicad_sch, GSM_Module.kicad_sch, HY951180A.stp, MODBUS.kicad_sch, Microcontroller.kicad_sch]
2026-05-09 Main PCB changes
    [B2B_Connector.kicad_sch, DIG_IN_GRP1.kicad_sch, DIG_IN_GRP2.kicad_sch, Ethernet.kicad_sch, GSM_Module.kicad_sch, MODBUS.kicad_sch, Microcontroller.kicad_sch, Open_STMPLC_IO_V0.1.kicad_pcb]
2026-05-11 Main PCB component placement
    [Microcontroller.kicad_sch, Open_STMPLC_Main_V0.1.kicad_pcb, SD_Card_TF-01A.step]
2026-05-12 BOM generated
    [Open_STMPLC_Main_V0.1.kicad_pcb]
2026-05-12 Update IO_PCB BOm excel sheet
    [IO_PCB.xlsx]
2026-05-12 Update the Main PCB Excel BOM
    [IO_PCB.xlsx, Main_PCB_BOM.xlsx]
2026-05-13 Schematic updates
    [ANALOG_IN.kicad_sch, B2B_Connector.kicad_sch, DIG_HS_OUT_1.kicad_sch, DIG_HS_OUT_2.kicad_sch, DIG_HS_OUT_3.kicad_sch, DIG_HS_OUT_4.kicad_sch, DIG_IN_GRP1.kicad_sch, DIG_IN_GRP2.kicad_sch]
2026-05-13 Component placement main pcb
    [B2B_Connector.kicad_sch, CR2032_Holder_THT_Horizontal.STEP, EC200UCNAA.STEP, Ethernet.kicad_sch, GSM_Module.kicad_sch, Inductor_ASPI-0630LR.STEP, Microcontroller.kicad_sch, Open_STMPLC_Main_V0.1.kicad_pcb]
2026-05-16 IO board layout completion and DRC clear
    [Ethernet.kicad_sch, HR911105A.STEP, Open_STMPLC_IO_V0.1.kicad_pcb, Open_STMPLC_IO_V0.1.kicad_sch, Open_STMPLC_Main_V0.1.kicad_pcb]
2026-05-16 Layer stack up main PCB and pin mapping
    [B2B_Connector.kicad_sch, Ethernet.kicad_sch, GSM_Module.kicad_sch, Microcontroller.kicad_sch, Open_STMPLC_Main_V0.1.kicad_pcb, Open_STMPLC_Main_V0.1.kicad_sch]
2026-05-17 MCU pin mapping
    [Microcontroller.kicad_sch, Open_STMPLC_Main_V0.1.kicad_pcb]
2026-05-18 Pin mapping - MCU connectors
    [B2B_Connector.kicad_sch, Microcontroller.kicad_sch, Open_STMPLC_Main_V0.1.kicad_pcb, Open_STMPLC_Main_V0.1.kicad_sch]
2026-05-20 Pin mapping
    [Microcontroller.kicad_sch, Open_STMPLC_Main_V0.1.kicad_pcb]
2026-05-23 PCB routing completion v0.1 Main
    [ANALOG_IN.kicad_sch, ANALOG_OUT.kicad_sch, B2B_Connector.kicad_sch, DIG_HS_OUT_1.kicad_sch, DIG_HS_OUT_2.kicad_sch, DIG_HS_OUT_3.kicad_sch, DIG_HS_OUT_4.kicad_sch, DIG_IN_GRP1.kicad_sch]
2026-05-24 Silkscreen and DRC
    [10144517-041802LF.step, 10144517-042802LF.STEP, 10144517-043802LF.STEP, 10144518-042802LF.STEP, 10144518-043802LF.STEP, B2B_Connector.kicad_sch, Ethernet.kicad_sch, GSM_Module.kicad_sch]
2026-05-28 Ethernet updated to vertical
    [Ethernet.kicad_sch, Open_STMPLC_Main_V0.1.kicad_pcb]
2026-06-03 Gerber generation v0.1
    [ANALOG_IN.kicad_sch, ANALOG_OUT.kicad_sch, B2B_Connector.kicad_sch, DIG_HS_OUT_1.kicad_sch, DIG_HS_OUT_2.kicad_sch, DIG_HS_OUT_3.kicad_sch, DIG_HS_OUT_4.kicad_sch, DIG_IN_GRP1.kicad_sch]
2026-06-10 Energy monitoring schematic
    [ATM90E3x-DB.PrjPcb, ATM90E3x-DB.SchDoc, Open_STMPLC_EnergyMon_V0..1.kicad_pcb, Open_STMPLC_EnergyMon_V0..1.kicad_sch]
2026-06-11 CT added
    [Open_STMPLC_EnergyMon_V0..1.kicad_sch]
2026-06-13 Update the BOM
    [IO_PCB.xlsx, Main_PCB_BOM.xlsx]
2026-06-13 Energy monitoring BOM
    [Open_STMPLC_EnergyMon_V0..1.csv, Open_STMPLC_EnergyMon_V0..1.kicad_pcb, Open_STMPLC_EnergyMon_V0..1.kicad_sch]
2026-06-19 Energy monitoring component grouping
    [Open_STMPLC_EnergyMon_V0..1.kicad_pcb, Open_STMPLC_EnergyMon_V0..1.kicad_sch]
2026-06-21 Energy monitoring layout
    [DC-DC_B5050S-1W.stp, Open_STMPLC_EnergyMon_V0..1.kicad_pcb, Open_STMPLC_EnergyMon_V0..1.kicad_sch, Open_STMPLC_EnergyMon_V0..1.step, zmct206.STEP]
2026-06-22 Energy monitoring gerber generated
    [Open_STMPLC_EnergyMon_V0..1-B_Cu.gbr, Open_STMPLC_EnergyMon_V0..1-B_Mask.gbr, Open_STMPLC_EnergyMon_V0..1-B_Paste.gbr, Open_STMPLC_EnergyMon_V0..1-B_Silkscreen.gbr, Open_STMPLC_EnergyMon_V0..1-Edge_Cuts.gbr, Open_STMPLC_EnergyMon_V0..1-F_Cu.gbr, Open_STMPLC_EnergyMon_V0..1-F_Mask.gbr, Open_STMPLC_EnergyMon_V0..1-F_Paste.gbr]
